CharlieW112/Programmable-Electronic-Load/STM32/TouchGFX_Projects/MyApplication/TouchGFX/assets/images/Screenshot 2024-04-13 051426.png

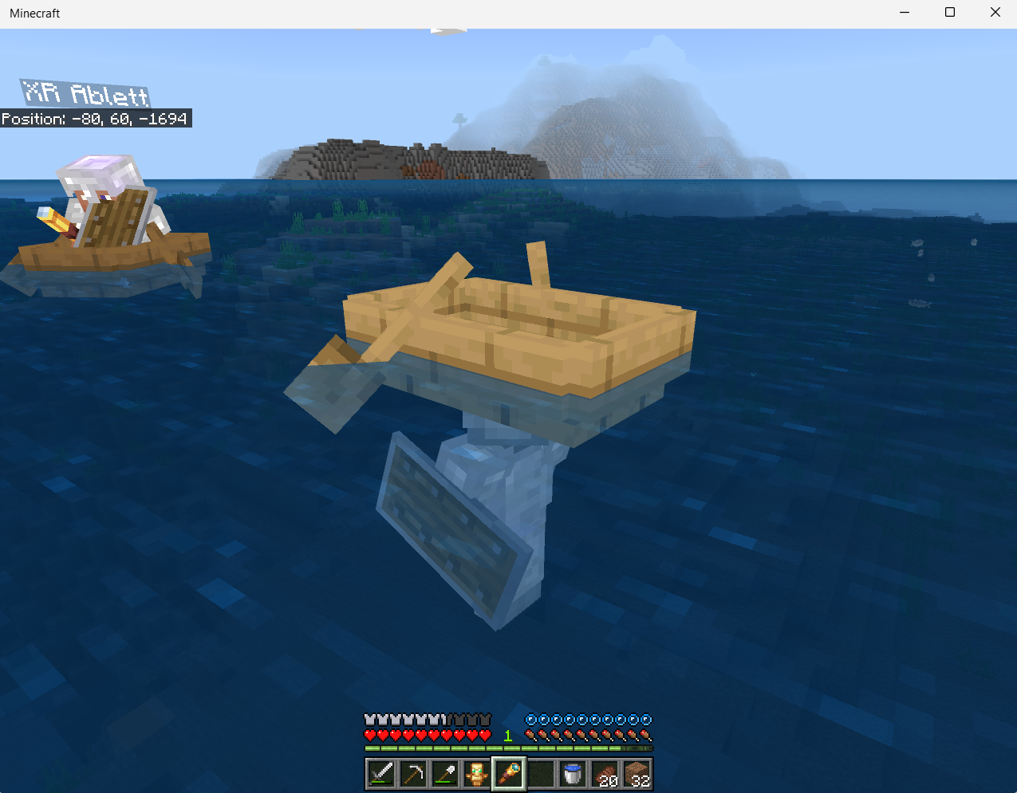
STM32/TouchGFX_Projects/MyApplication/TouchGFX/assets/images/Screenshot 2024-04-13 051426.png
