CharlieW112/Programmable-Electronic-Load/STM32/TouchGFX_Projects/MyApplication/TouchGFX/assets/images/Screenshot 2024-05-27 185339.png

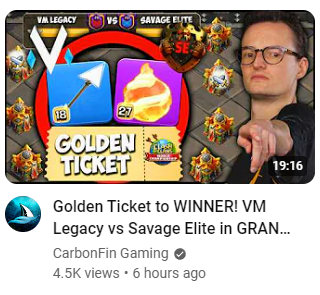
STM32/TouchGFX_Projects/MyApplication/TouchGFX/assets/images/Screenshot 2024-05-27 185339.png
