CharlieW112/Programmable-Electronic-Load/STM32/TouchGFX_Projects/MyApplication/readme.md

# STM32F429I_DISCO_REV_D01 TBS

The default IDE is set to STM32CubeIDE, to change IDE open the STM32F429I_DISCO_REV_D01.ioc with STM32CubeMX and select from the supported IDEs (EWARM from version 8.50.9, MDK-ARM, and STM32CubeIDE). Supports flashing of the STM32F429I_DISCO_DEV_D01 board directly from TouchGFX Designer using GCC and STM32CubeProgrammer. Flashing the board requires STM32CubeProgrammer which can be downloaded from the ST webpage. 

This TBS is configured for 320 x 240 pixels 16bpp screen resolution.  

Performance testing can be done using the GPIO pins designated with the following signals: VSYNC_FREQ  - Pin PE2, RENDER_TIME - Pin PE3, FRAME_RATE  - Pin PE4, MCU_ACTIVE  - Pin PE5
