CharlieW112/Programmable-Electronic-Load/Reports/CAD V1 vs V2 15.10.24.docx

CAD V1 -> V2 Proposed Changes

- Internal height 140mm -> ~160mm
- Additional exhausts on rear panel
- Plate thickness 15mm -> 12mm
- Consistent counterbores
- Tapped holes for cable routing
- Front panel extension
- Rear binding posts

Programmable dc electronic load (s) Charles Warhurst 10/15/24
