CharlieW112/Programmable-Electronic-Load/Reports/Project Overview - Bikar.pdf

## Charles Warhurst

charles.warhurst@students.plymouth.ac.uk

## Programmable DC Electronic Load

## Project Overview

I’m building a programmable DC electronic load, a device used to test power supplies and batteries by simulating real-world electrical loads. The enclosure is more than just a housing—it plays a critical role in heat dissipation, structural integrity, and EMI shielding.

## Why Aluminum?

- Heat Dissipation – The entire enclosure acts as a passive heatsink, helping to manage thermal loads efficiently.
- Structural Strength – A precisely machined aluminum assembly ensures durability and accurate alignment.
- EMI Shielding – The thick aluminum case minimizes electrical interference, improving measurement accuracy.

## What I Need

The enclosure will be built from seven individual aluminum plates, precisely machined to assemble into a rigid, thermally conductive structure. These plates will require cutouts, drilled holes, and accurate tolerances to ensure a secure fit and proper airflow. A simple milled finish is sufficient—no special coatings or treatments required.

## Example Commercial Units

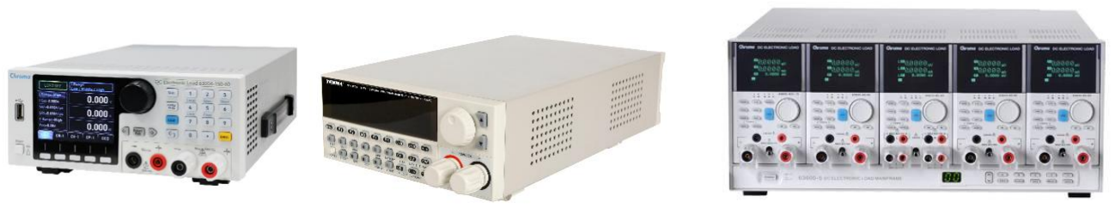
[picture p18: figure]

## My Design:

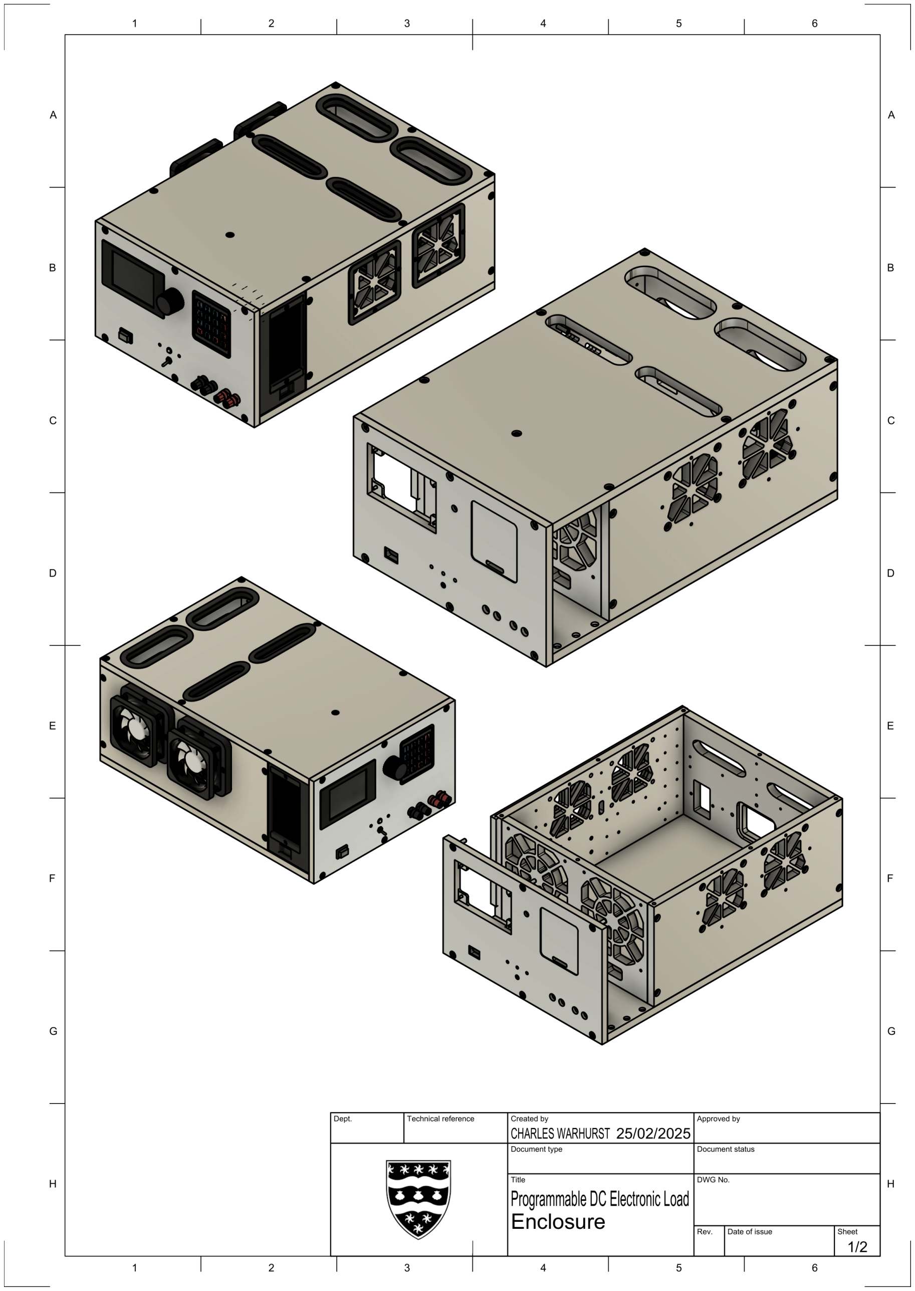
[picture p19: page 2]
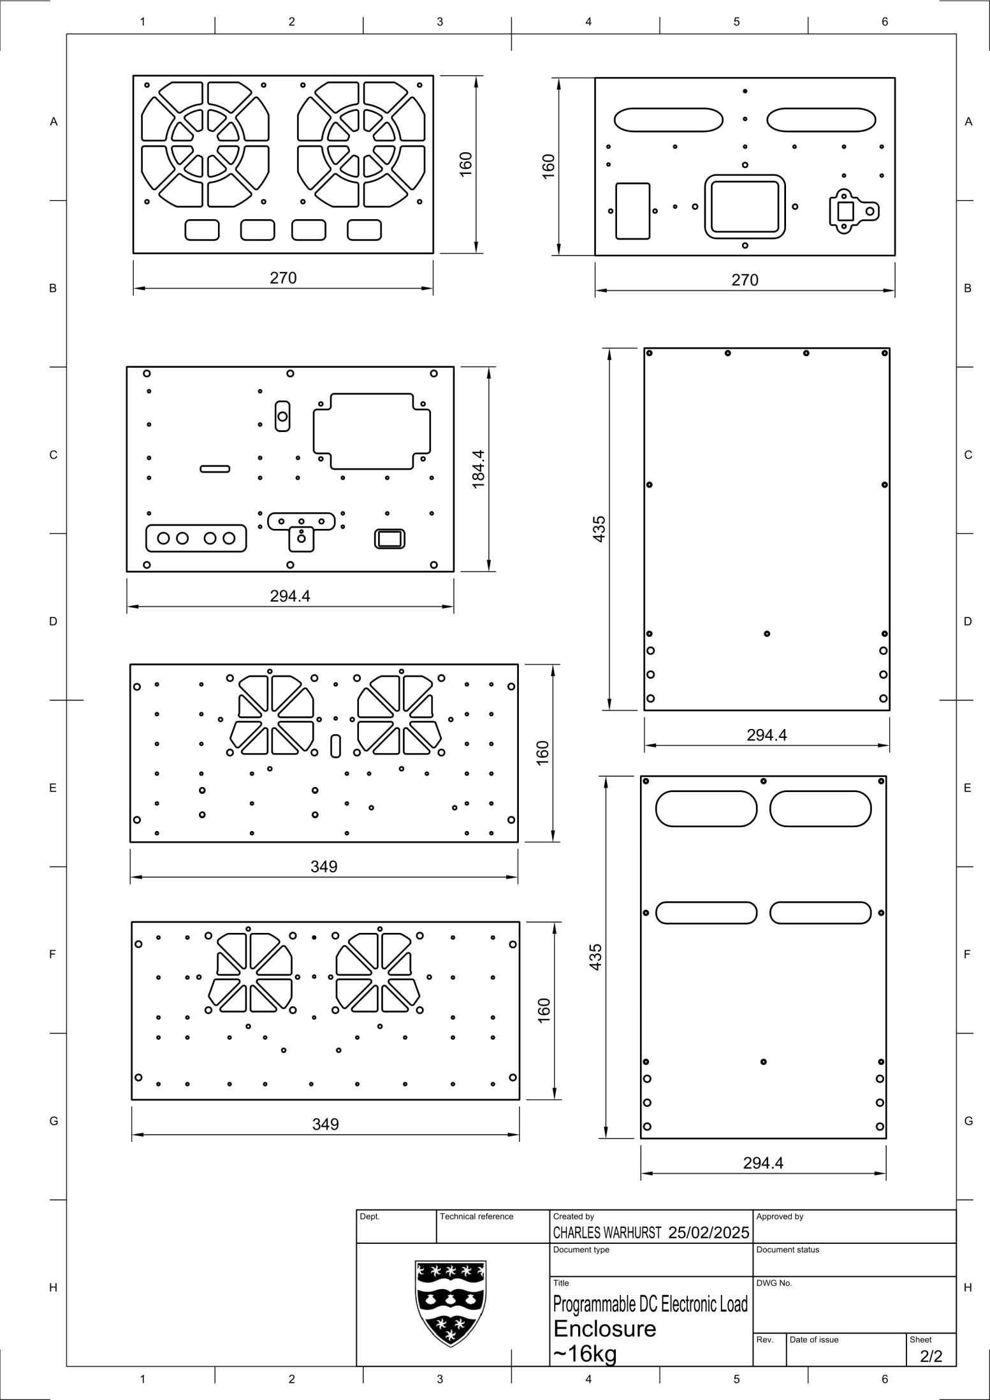
[picture p20: page 3]

PART NAME QTY = 1 | FINAL MACHINED DIMENSIONS (mm) | INITIAL PLATE DIMENSIONS (mm)
WIDTH | HEIGHT | THICKNESS | WIDTH | HEIGHT | THICKNESS
Front Panel | 270 | 160 | 12 | 276 | 166 | 12
Rear Panel | 270 | 160 | 12 | 276 | 166 | 12
External Front Panel | 294.4 | 184.4 | 10 | 300.4 | 190.4 | 12
Bottom Panel | 294.4 | 435 | 12 | 300.4 | 441 | 12
Top Panel | 294.4 | 435 | 12 | 300.4 | 441 | 12
Left Panel | 349 | 160 | 12 | 355 | 166 | 12
Right Panel | 349 | 160 | 12 | 355 | 166 | 12
