CharlieW112/Programmable-Electronic-Load/Reports/Initial Proposal.pdf

Student Name: | Charles Warhurst
Proposal Name: | Programmable DC Electronic Load

Proposal:

I am proposing to design, build, and test a Programmable DC Electronic Load capable of testing power sources up to 100A, 250V, 2kW (whichever comes first). These capabilities are extremely optimistic and due to budget restrictions, a more realistic target would be 20A, 60V, 750W.

# Initial Proposal

19 September 2024 17:51

New Section 1 Page 1
