CharlieW112/Programmable-Electronic-Load/Reports/CAD Progress Update.docx

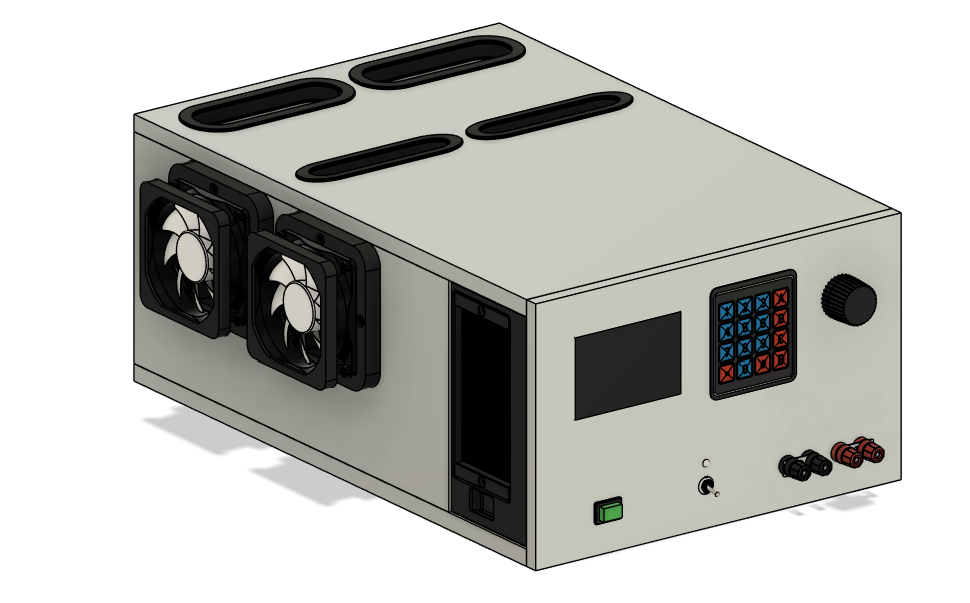
[picture p21: figure]
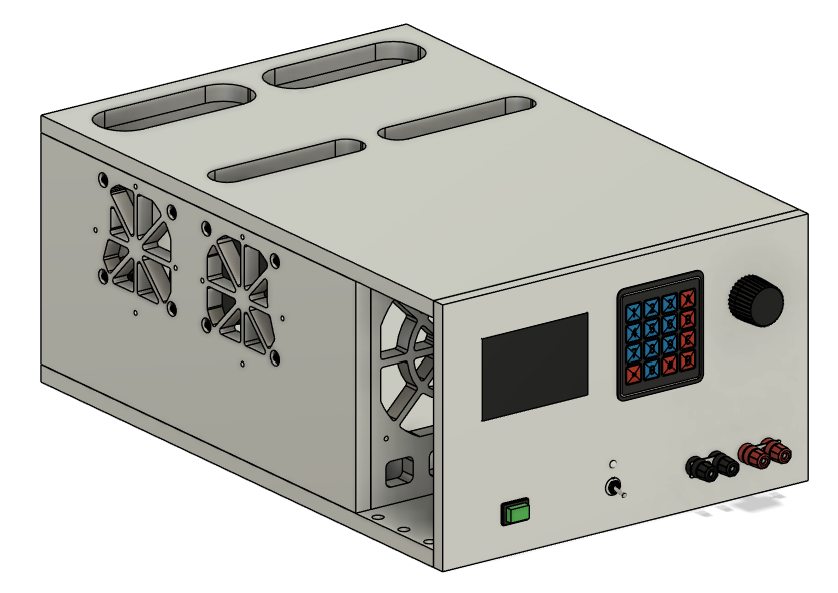
[picture p22: figure]
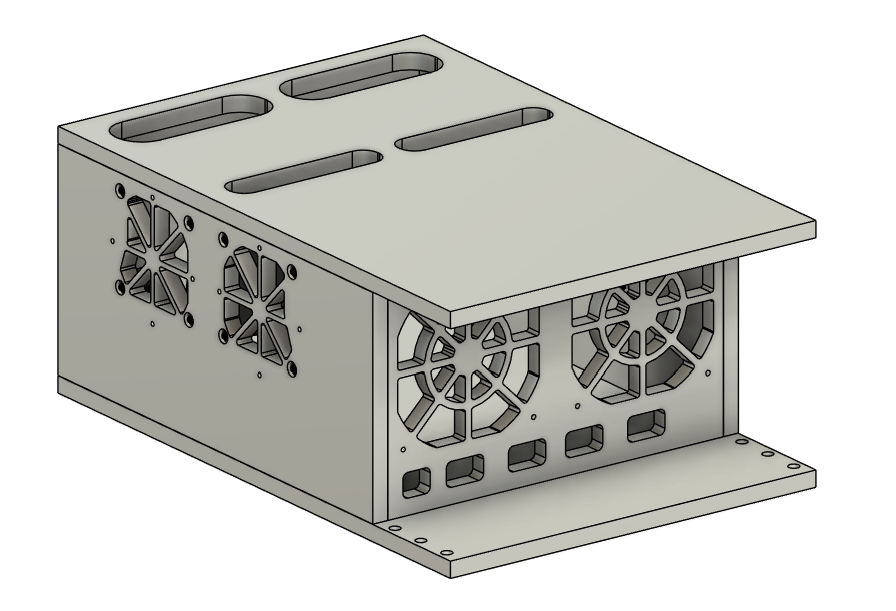
[picture p23: figure]
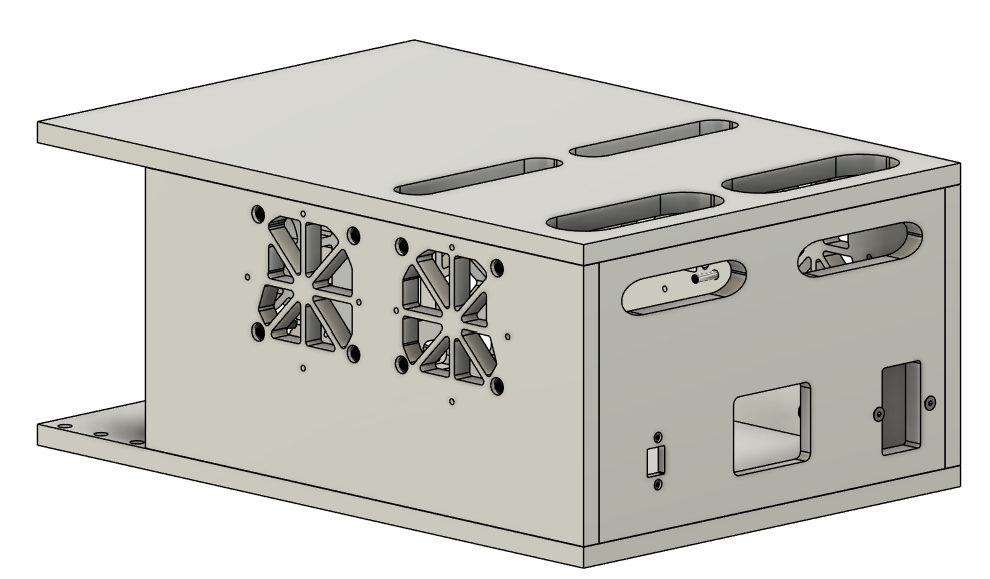
[picture p24: figure]
