CharlieW112/Programmable-Electronic-Load/CAD Files/Downloaded Part Files/3.5 LCD/AliExpress Dimensions.jpg

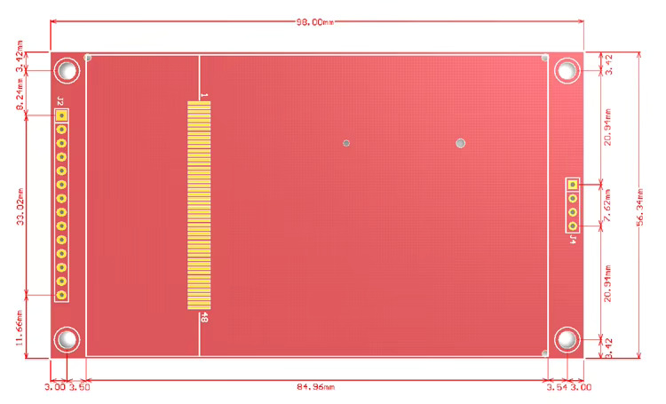
CAD Files/Downloaded Part Files/3.5 LCD/AliExpress Dimensions.jpg
