CharlieW112/Programmable-Electronic-Load/CAD Files/Downloaded Part Files/5mm RGB LED/1.png

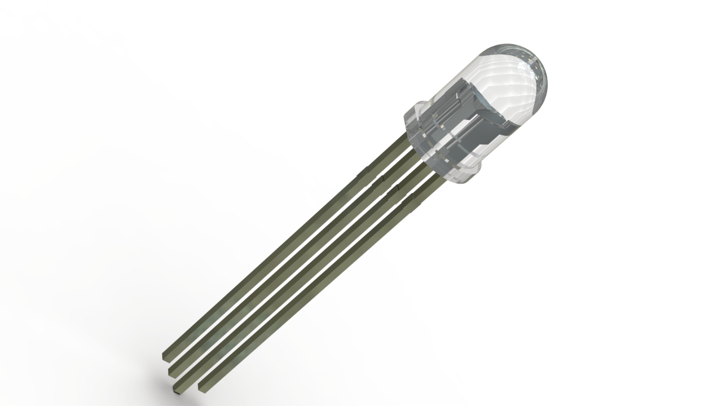
CAD Files/Downloaded Part Files/5mm RGB LED/1.png
