CharlieW112/Programmable-Electronic-Load/CAD Files/Downloaded Part Files/Binding Posts/Low-Current/Rendering1.PNG

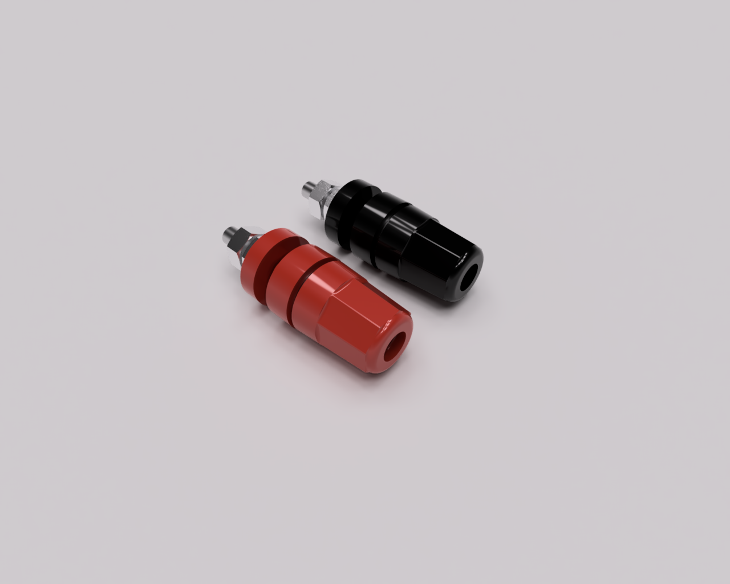
CAD Files/Downloaded Part Files/Binding Posts/Low-Current/Rendering1.PNG
