CharlieW112/Programmable-Electronic-Load/CAD Files/Downloaded Part Files/Binding Posts/Low-Current/Rendering2.png

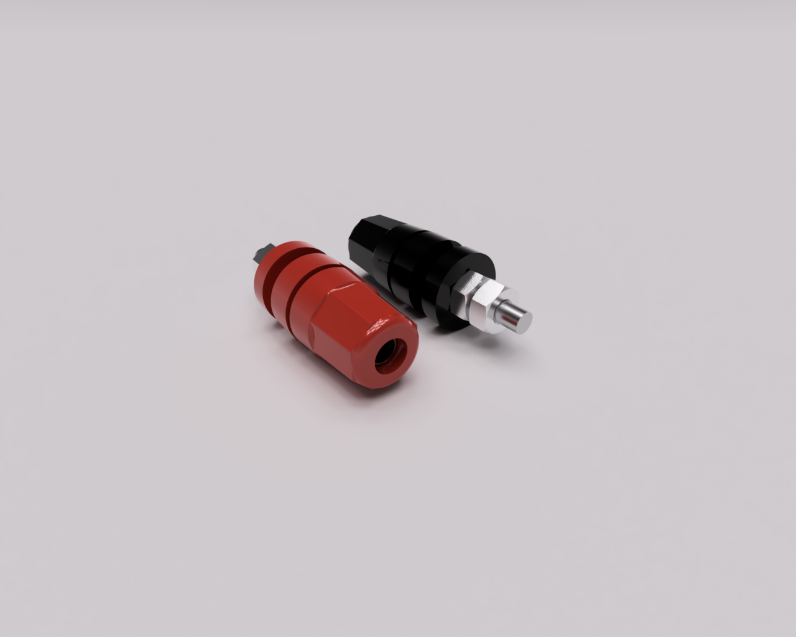
CAD Files/Downloaded Part Files/Binding Posts/Low-Current/Rendering2.png
