CharlieW112/Programmable-Electronic-Load/CAD Files/Downloaded Part Files/Ethernet Port/RJ45 PanelMount.jpg

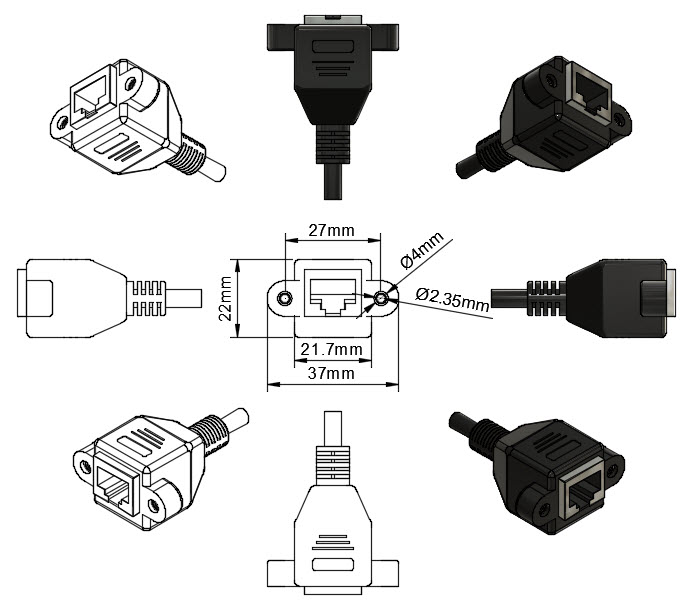
CAD Files/Downloaded Part Files/Ethernet Port/RJ45 PanelMount.jpg
