CharlieW112/Programmable-Electronic-Load/CAD Files/Downloaded Part Files/Fans/80x80x25/80x80x25 fan.307.jpg

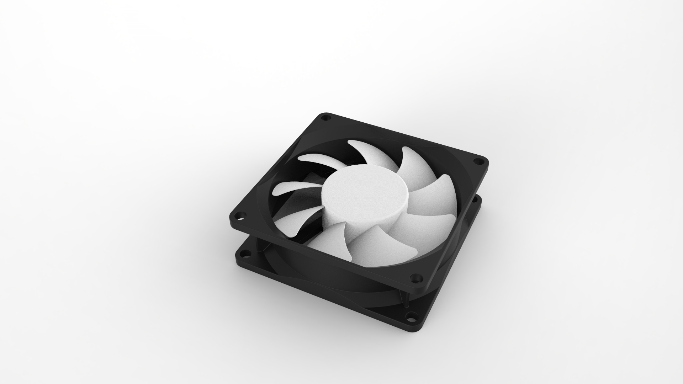
CAD Files/Downloaded Part Files/Fans/80x80x25/80x80x25 fan.307.jpg
