CharlieW112/Programmable-Electronic-Load/CAD Files/Downloaded Part Files/Membrane Keypad/keypad-16keymembrane.jpg

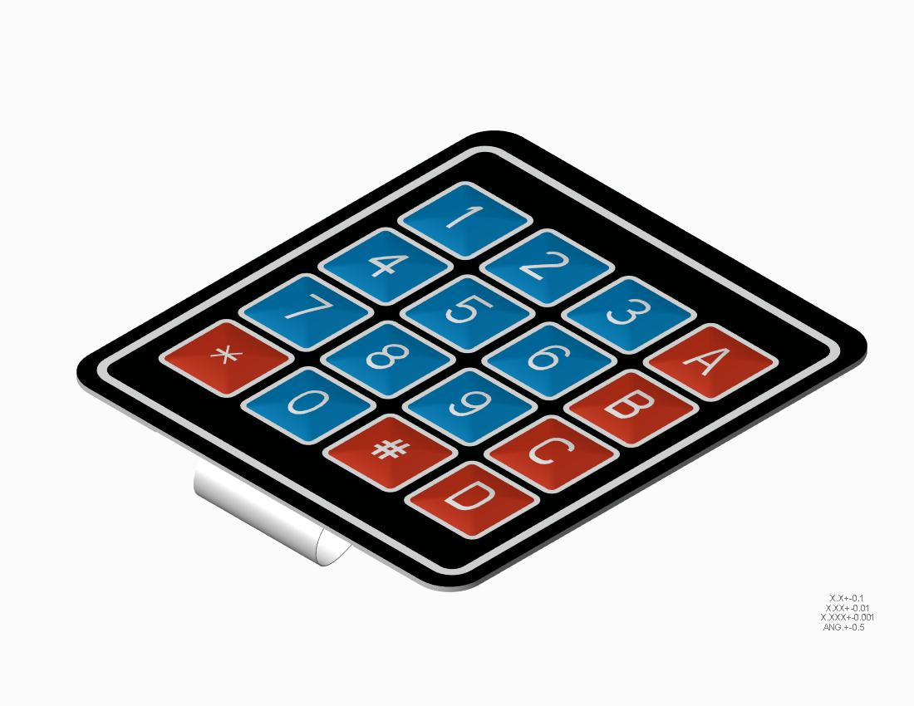
CAD Files/Downloaded Part Files/Membrane Keypad/keypad-16keymembrane.jpg
