CharlieW112/Programmable-Electronic-Load/Misc Photos/Enclosure/IMG_0725.JPEG

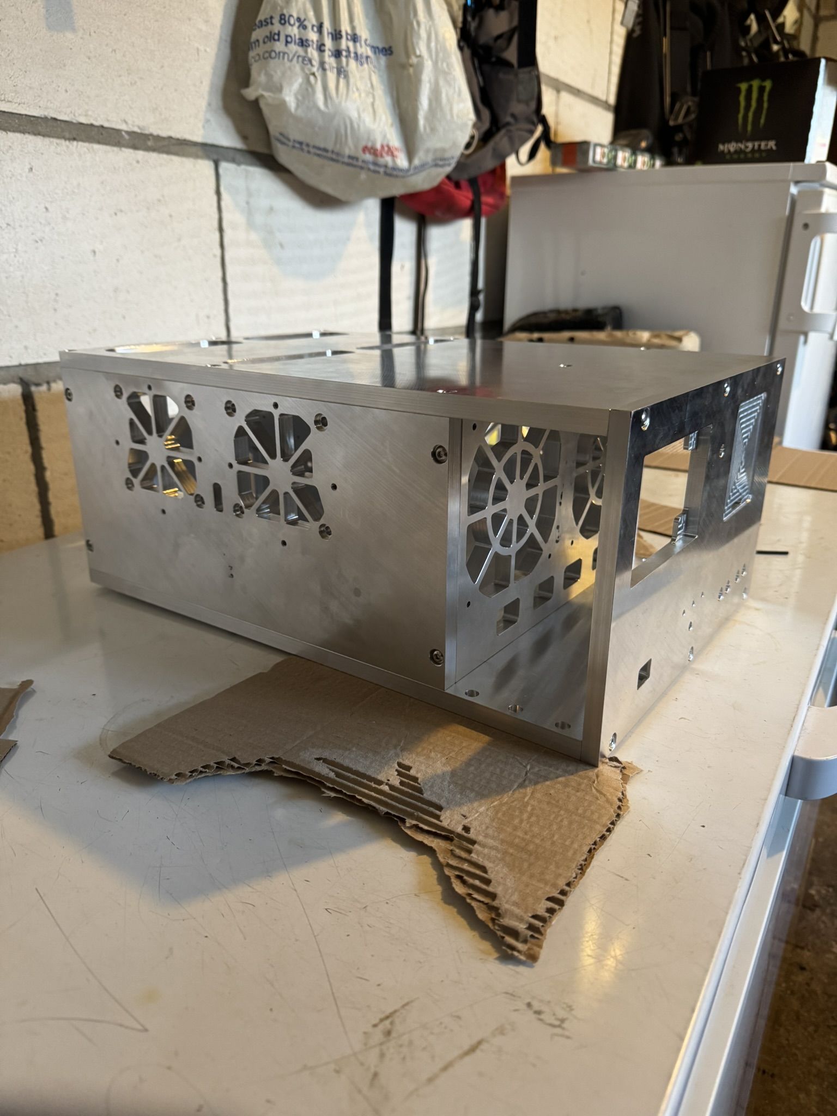
Misc Photos/Enclosure/IMG_0725.JPEG
