CharlieW112/Programmable-Electronic-Load/Misc Photos/Enclosure/IMG_0726.JPEG

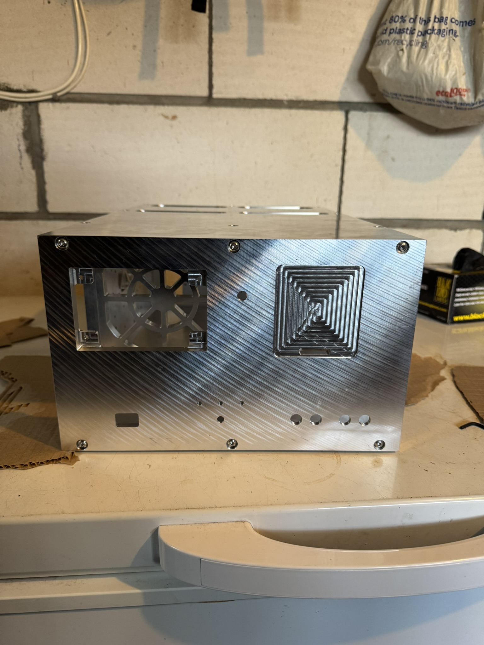
Misc Photos/Enclosure/IMG_0726.JPEG
