CharlieW112/Programmable-Electronic-Load/Misc Photos/Enclosure/IMG_0727.JPEG

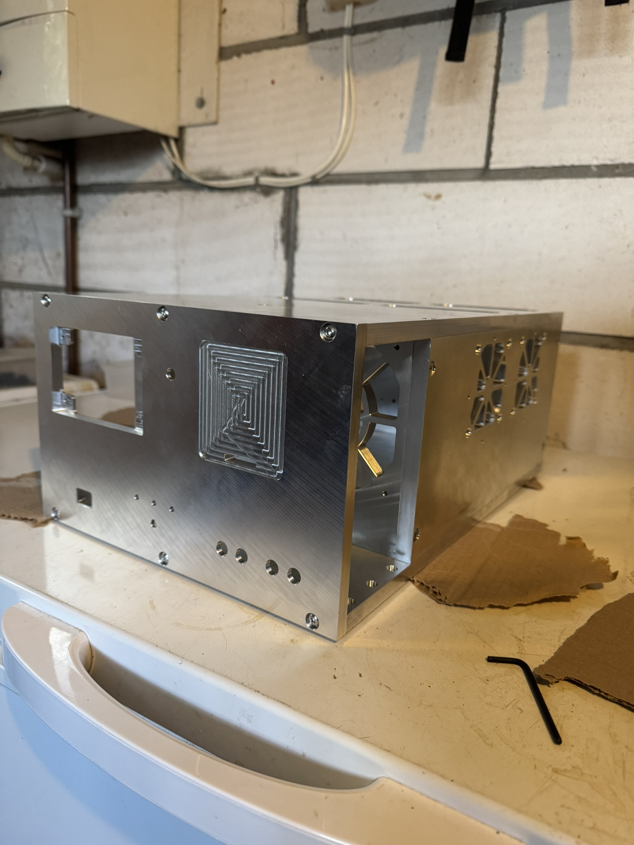
Misc Photos/Enclosure/IMG_0727.JPEG
