CharlieW112/Programmable-Electronic-Load/Misc Photos/Enclosure/IMG_0728.JPEG

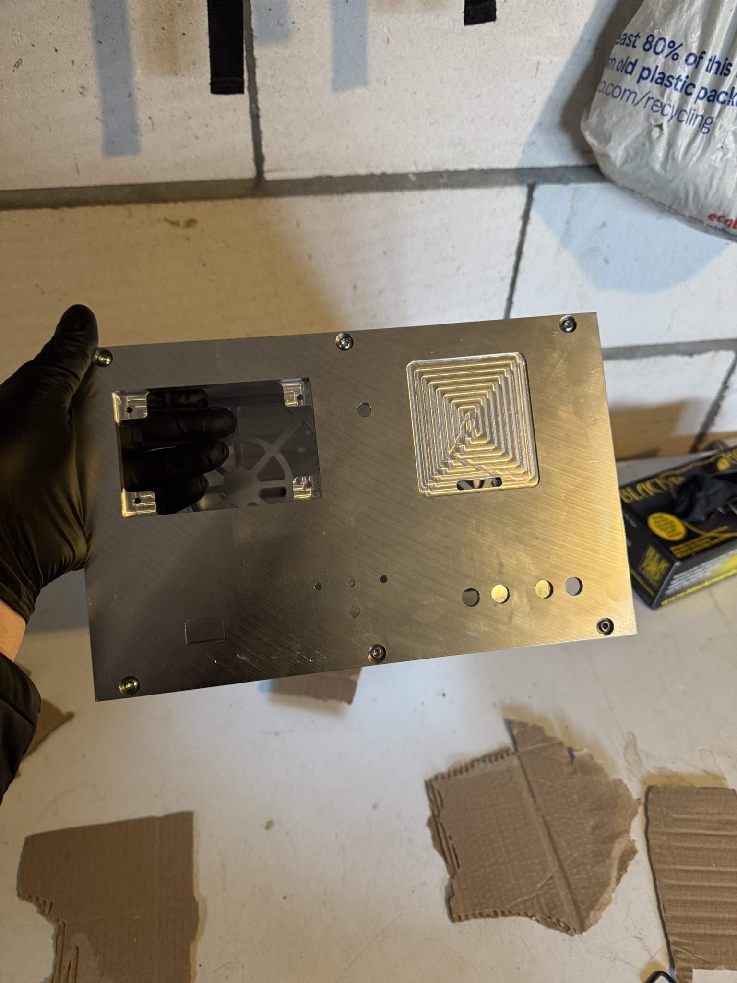
Misc Photos/Enclosure/IMG_0728.JPEG
