CharlieW112/Programmable-Electronic-Load/Misc Photos/Enclosure/IMG_0729.JPEG

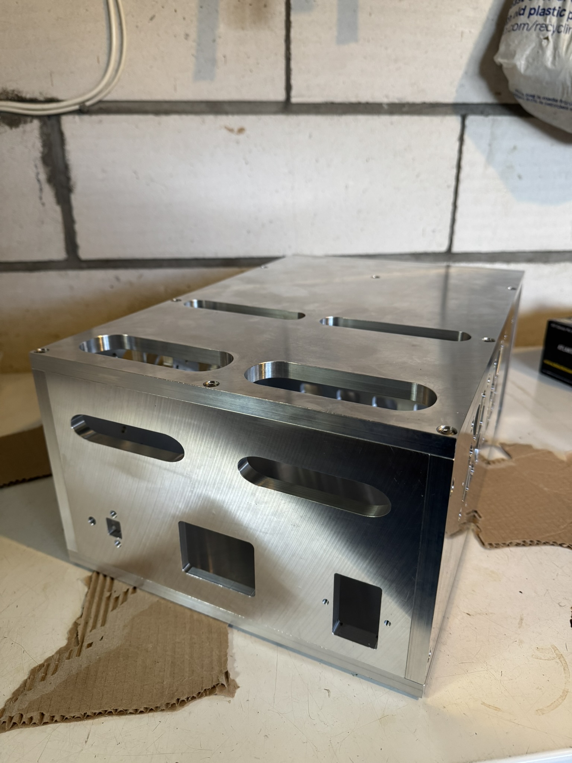
Misc Photos/Enclosure/IMG_0729.JPEG
