CharlieW112/Programmable-Electronic-Load/Misc Photos/Enclosure/IMG_0730.JPEG

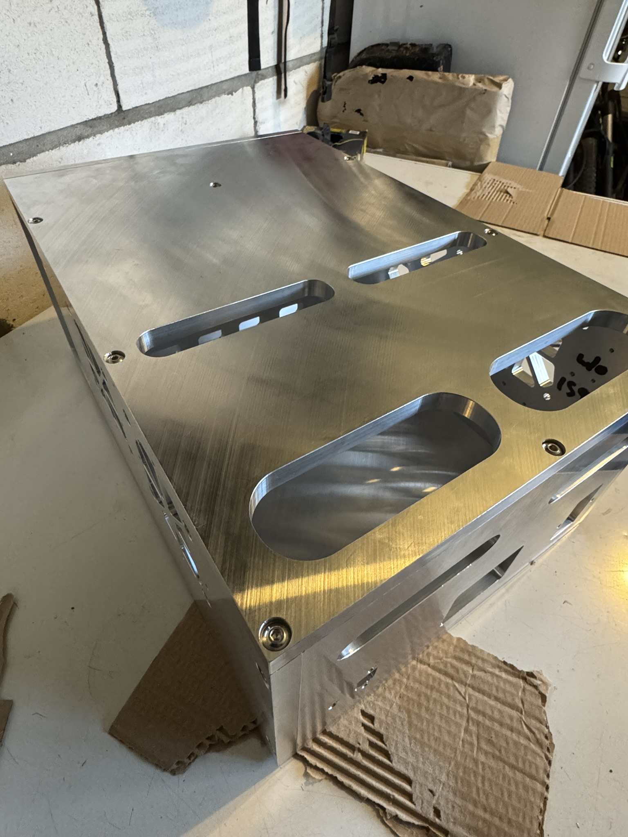
Misc Photos/Enclosure/IMG_0730.JPEG
