CharlieW112/Programmable-Electronic-Load/Misc Photos/Enclosure/IMG_0731.JPEG

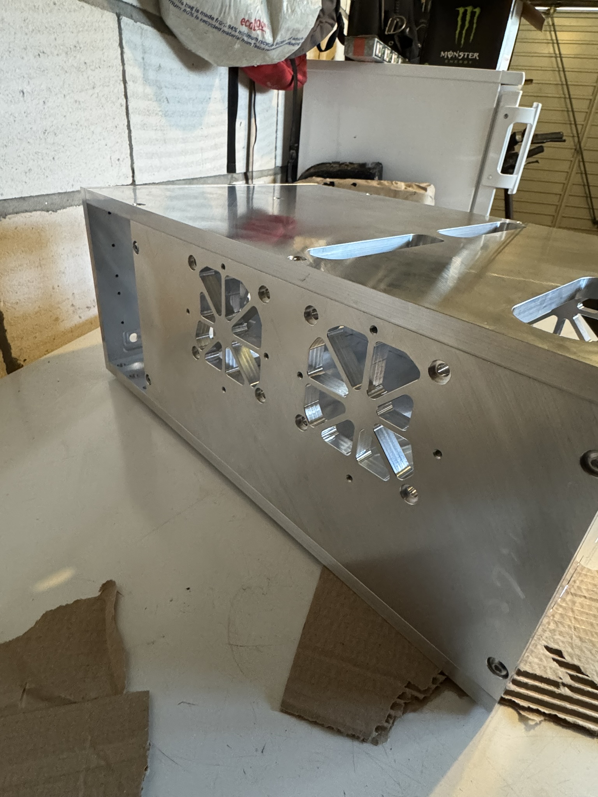
Misc Photos/Enclosure/IMG_0731.JPEG
