CharlieW112/Programmable-Electronic-Load/Misc Photos/Enclosure/IMG_0732.JPEG

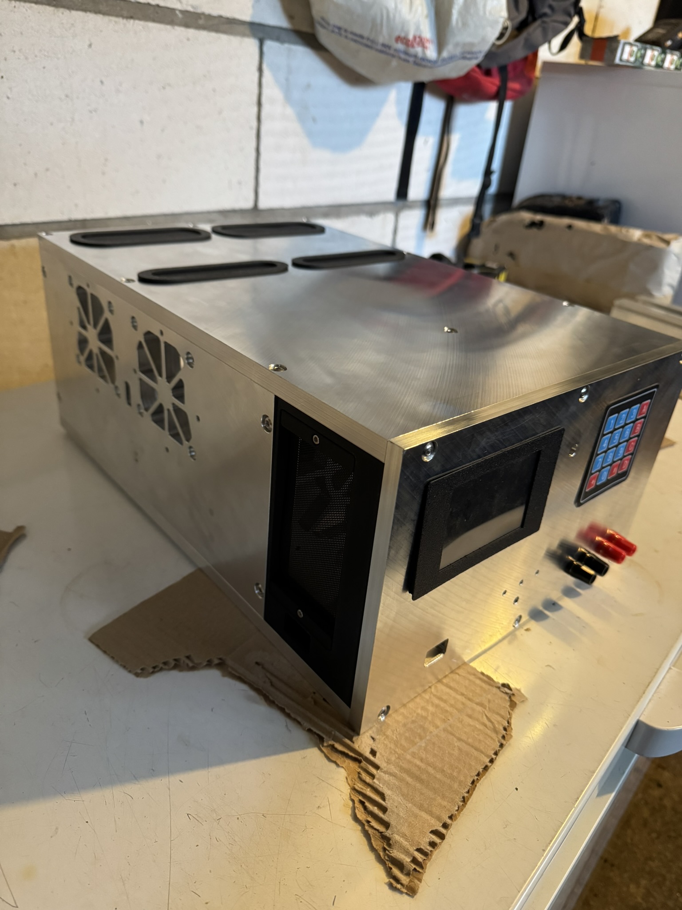
Misc Photos/Enclosure/IMG_0732.JPEG
