CharlieW112/Programmable-Electronic-Load/Misc Photos/Enclosure/IMG_0733.JPEG

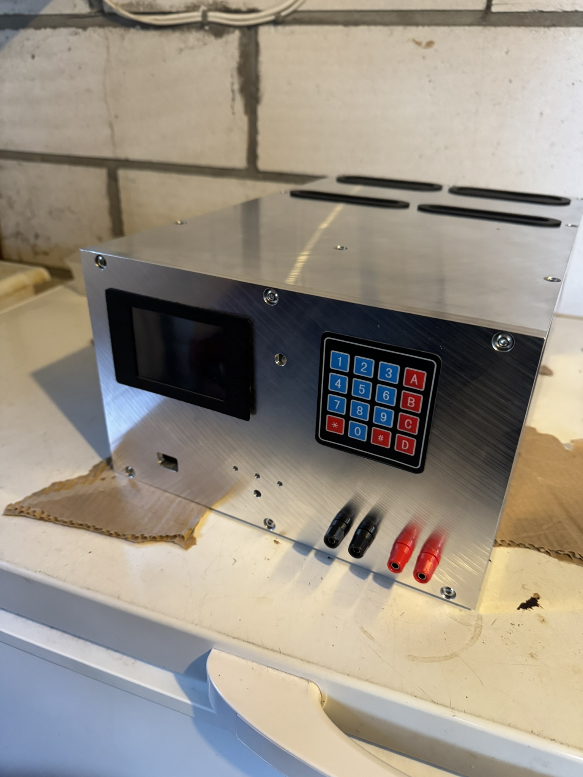
Misc Photos/Enclosure/IMG_0733.JPEG
