CharlieW112/Programmable-Electronic-Load/Misc Photos/Enclosure/IMG_0735.JPEG

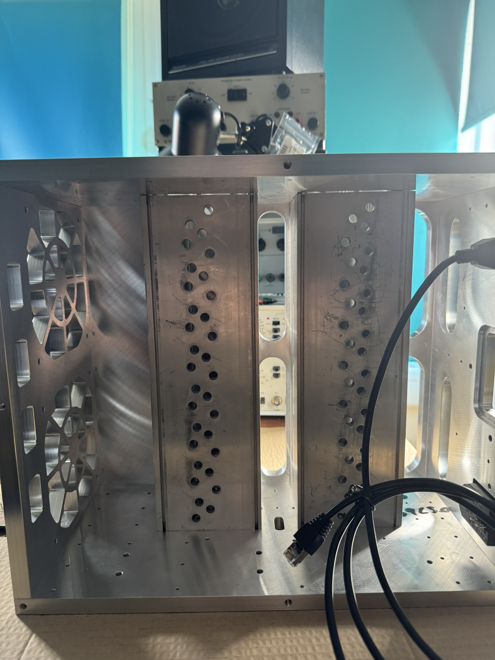
Misc Photos/Enclosure/IMG_0735.JPEG
