CharlieW112/Programmable-Electronic-Load/Misc Photos/Enclosure/IMG_0736.JPEG

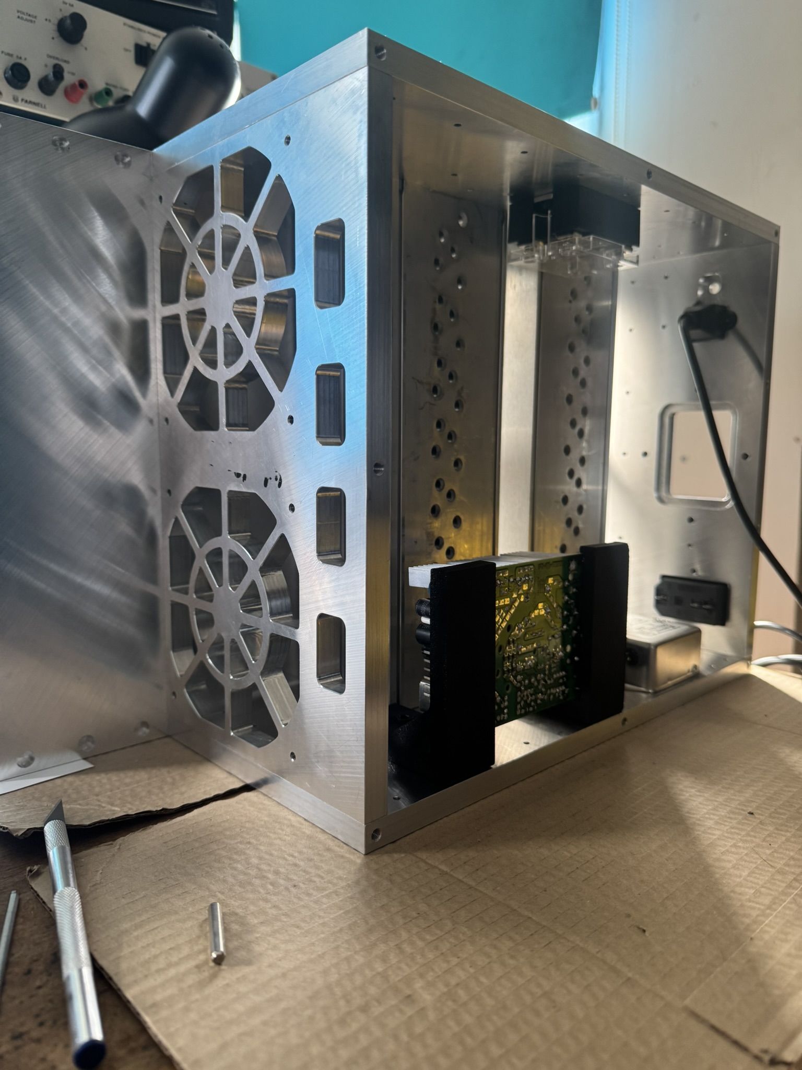
Misc Photos/Enclosure/IMG_0736.JPEG
