CharlieW112/Programmable-Electronic-Load/Misc Photos/Enclosure/IMG_0737.JPEG

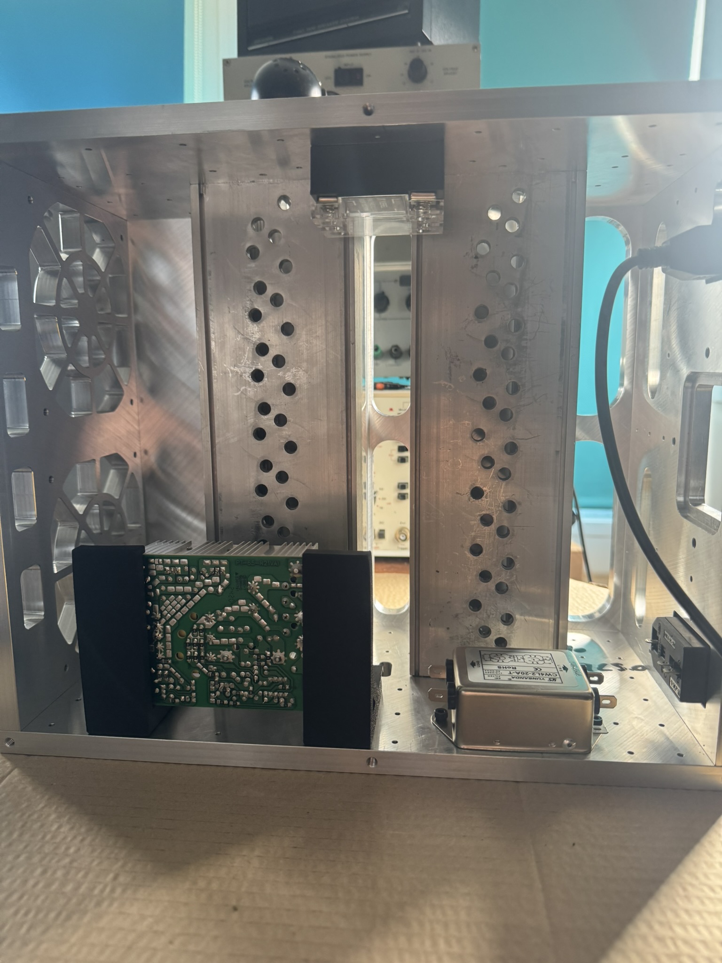
Misc Photos/Enclosure/IMG_0737.JPEG
