CharlieW112/Programmable-Electronic-Load/Misc Photos/Enclosure/IMG_0738.JPEG

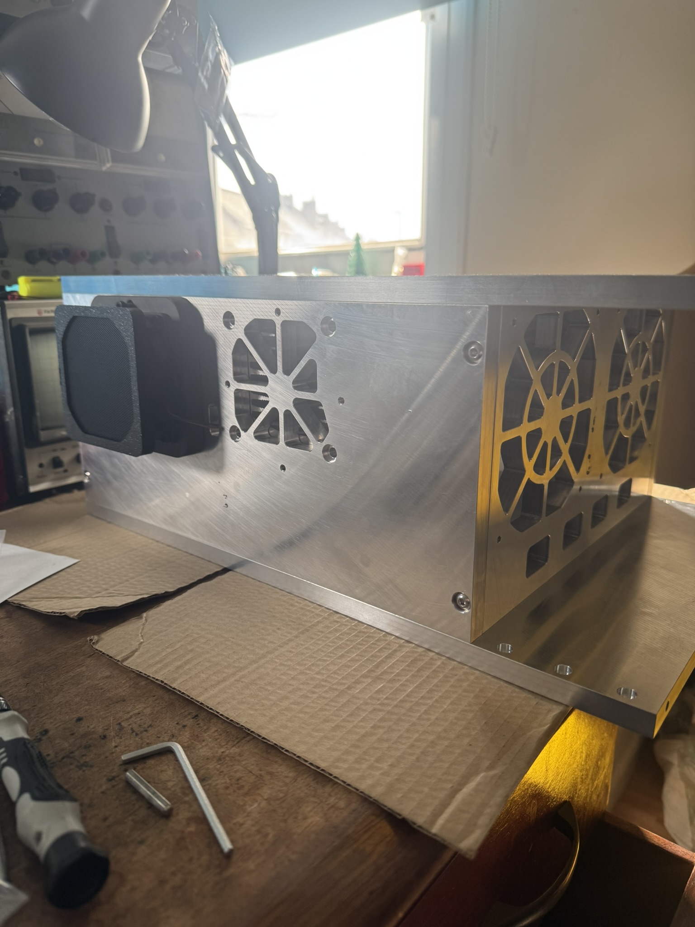
Misc Photos/Enclosure/IMG_0738.JPEG
