CharlieW112/Programmable-Electronic-Load/Misc Photos/Enclosure/IMG_0739.JPEG

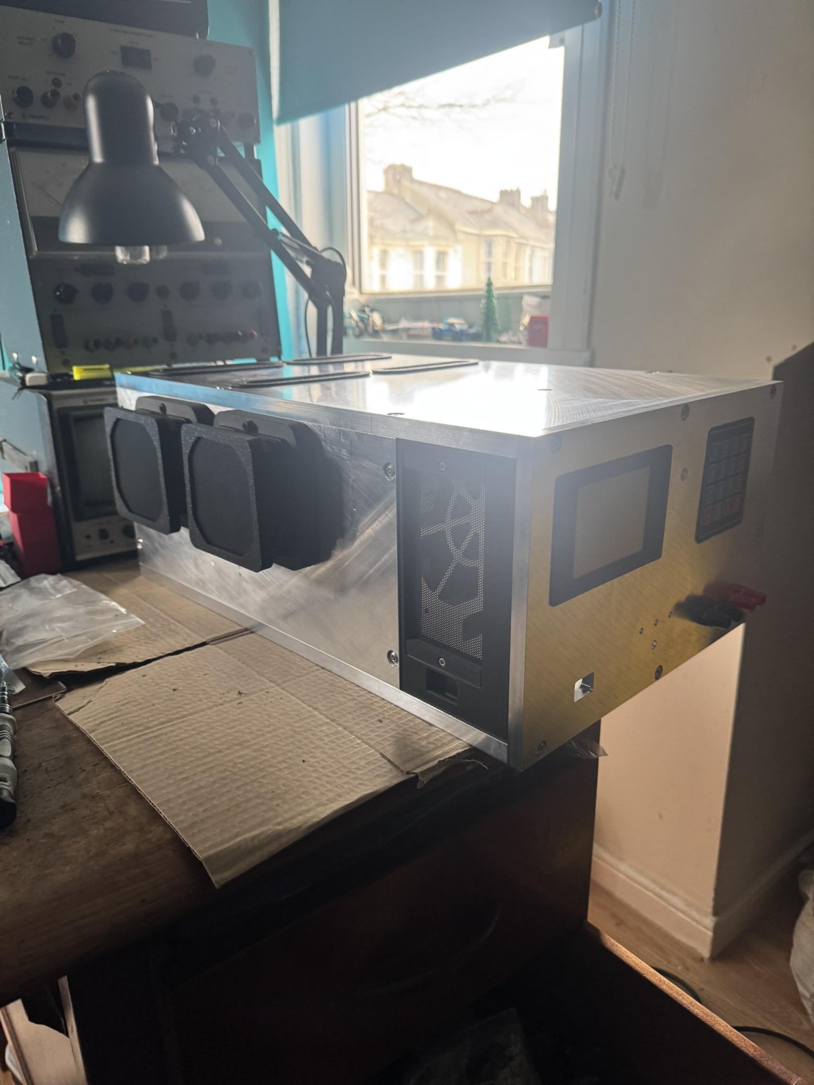
Misc Photos/Enclosure/IMG_0739.JPEG
