CharlieW112/Programmable-Electronic-Load/Misc Photos/Enclosure/IMG_0740.JPEG

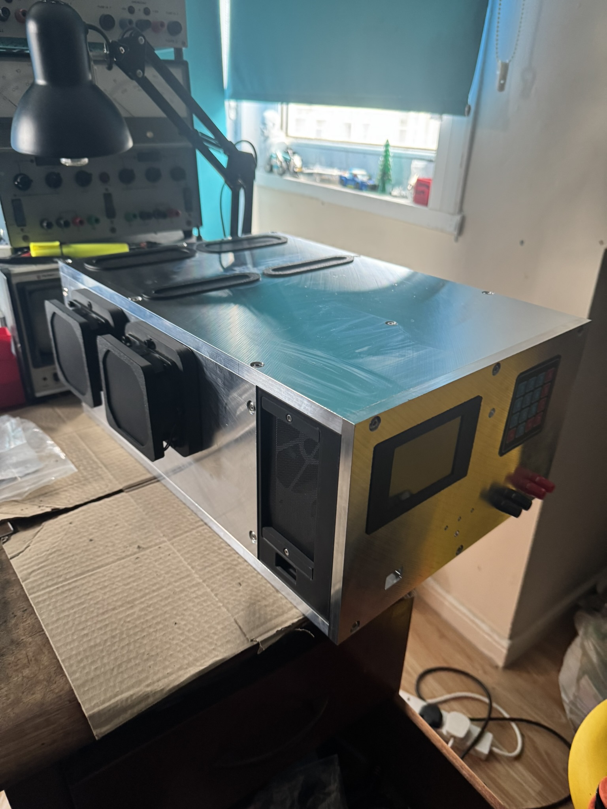
Misc Photos/Enclosure/IMG_0740.JPEG
