CharlieW112/Programmable-Electronic-Load/Misc Photos/Enclosure/IMG_0741.JPEG

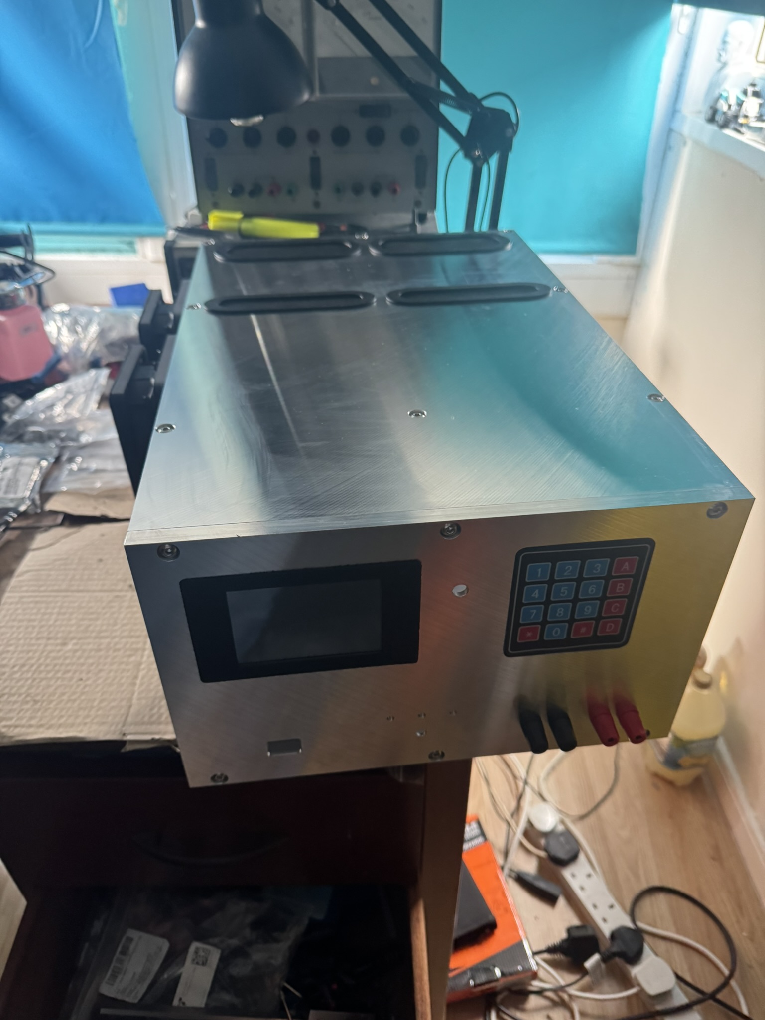
Misc Photos/Enclosure/IMG_0741.JPEG
