CharlieW112/Programmable-Electronic-Load/Misc Photos/Front Panel LEDs.png

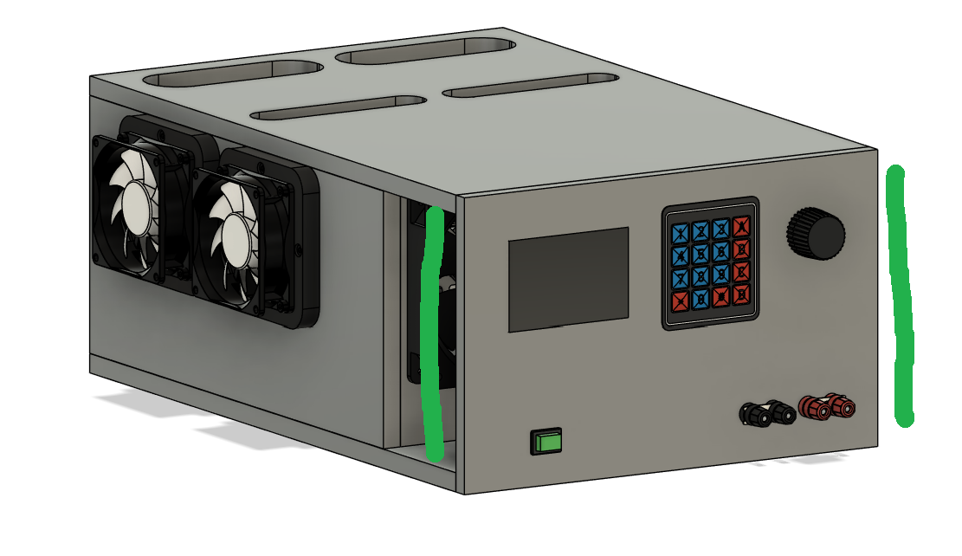
Misc Photos/Front Panel LEDs.png
