CharlieW112/Programmable-Electronic-Load/Misc Photos/Proteus - Base Driver V2.png

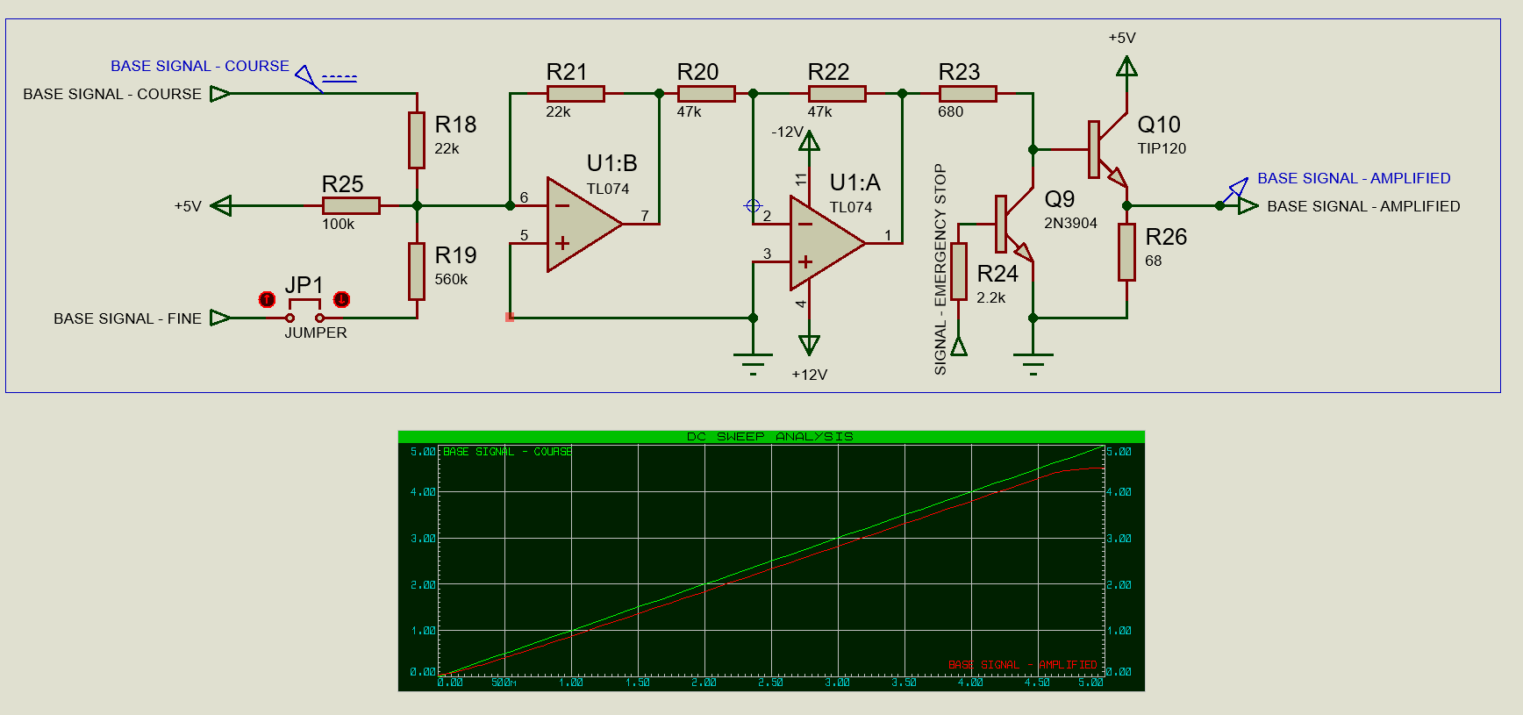
Misc Photos/Proteus - Base Driver V2.png
