CharlieW112/Programmable-Electronic-Load/Accounting/Sample Tracker.xlsx

Company | Email | Date | Product | Purchase Price | Response | Product Acquired | Company | Reason | Acknowledgement
MeanWell | info@meanwell.eu | 2024-09-30 | PT-65B | £15.00 | n | n | Bikar Metals | Aluminium plate for enclosure | Engraving
Riedon | sales@riedon.com | 2024-09-30 | SSA2-250 | £70.00 | y | y | AJM Engineering | Machining for enclosure | Engraving
STMicroelectronics | uk.contact@st.com | 2024-09-30 | STM32F767 | £13.00 | n | n | Riedon | SSA2-250 Smart Current Sensor | Engraving
Newhaven Display | nhsales@newhavendisplay.com | 2024-09-30 | 3.5" LCD TFT | £15-£100 | n | n
Gigavac | info@gigavac.com | 2024-10-05 | GX11 150+ Amp | £50.00 | n | n
Seek Thermal | https://www.flir.co.uk/about/general-inquiries/ | 2024-10-17 | Thermal Imaging Camera | £200-£1000 | a | n
Hakko | sales@hakko.co.uk | 2024-10-29 | Desoldering Gun | £350.00 | n | n
Pomona (Fluke) | technicalsupport@pomonatest.com | 2024-10-29 | Shorting Bar | £10-£50 | a | n
Molex | mo.boolaky@molex.com | 2024-10-30 | PSU Connectors | £15.00 | a | n
