CharlieW112/Programmable-Electronic-Load/Accounting/Price Tracker.xlsx

Total Price (£) | Name | Quantity | Vendor | Date | Purchased?
17.44 | Heavy Duty Car Starter Relay DC 12V 100A 4Pin Normally Open for Control Battery ON OFF RL/180 | 2 | Amazon.co.uk | 2024-09-16 | y
2.9 | TS5A3159ADBVR - SPDT Analog Multiplexer | 5 | Digikey.co.uk
5.32 | OPA197IDR - Precision Op-Amp | 4 | Digikey.co.uk
19.2 | HO 100-S - 100A Hall Effect Current Sensor | 1 | Digikey.co.uk
 | MEAN WELL Switching Power Supply, PT-65B, 12V dc, 2.5A, 63.5W, Triple Output, 264V ac Input Voltage | 1 | uk.rs-online.com
 | Sunon EE Series Axial Fan, 12 V dc, DC Operation, 158m³/h, 3.4W, 279mA Max, 120 x 120 x 25mm | 2 | uk.rs-online.com
 | Axial Fan, 12 V dc, dc Operation, 70m³/h, 138mA Max, 80 x 80 x 25mm | 4 | uk.rs-online.com
 | RS PRO 83dB Through Hole Continuous Internal Piezo Buzzer, 28.6 (Dia.) x 7.5mm, 3V dc Min, 28V dc Max | 5 | uk.rs-online.com
 | STMicroelectronics STM32F767VIT6, 32bit ARM Cortex M7 Microcontroller, STM32F7, 216MHz, 2.048 MB Flash, 100-Pin LQFP | 1 | uk.rs-online.com
