CharlieW112/Programmable-Electronic-Load/CAD Files/Downloaded Part Files/5mm RGB LED/Led RGB 5mm.STEP

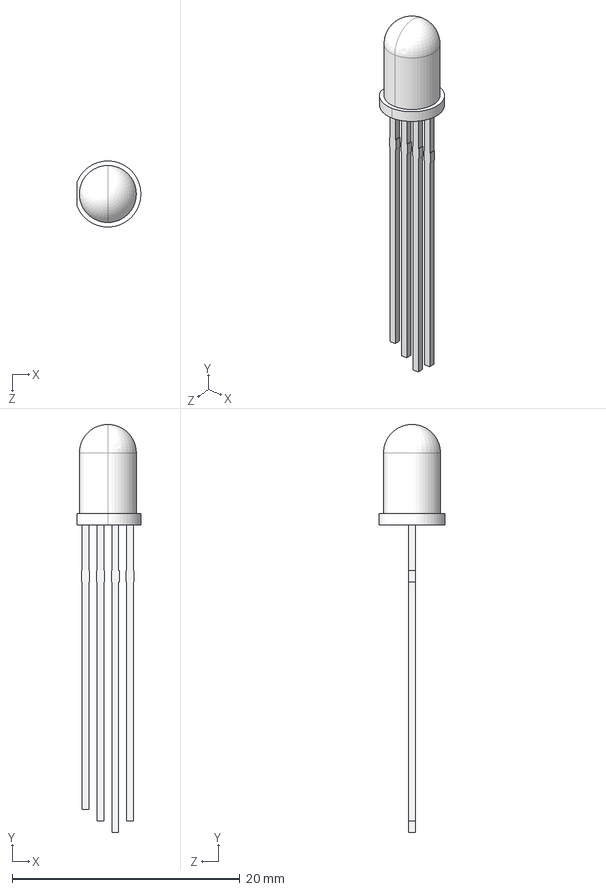
[picture p55: CAD file, 2024-10-31]
CAD Files/Downloaded Part Files/5mm RGB LED/Led RGB 5mm.STEP
5.60 x 35.8 x 5.80 mm
Lente^Led RGB 5mm
Terminais^Led RGB 5mm
