CharlieW112/Programmable-Electronic-Load/CAD Files/Downloaded Part Files/Binding Posts/Low-Current/Banana jack (4mm female socket).step

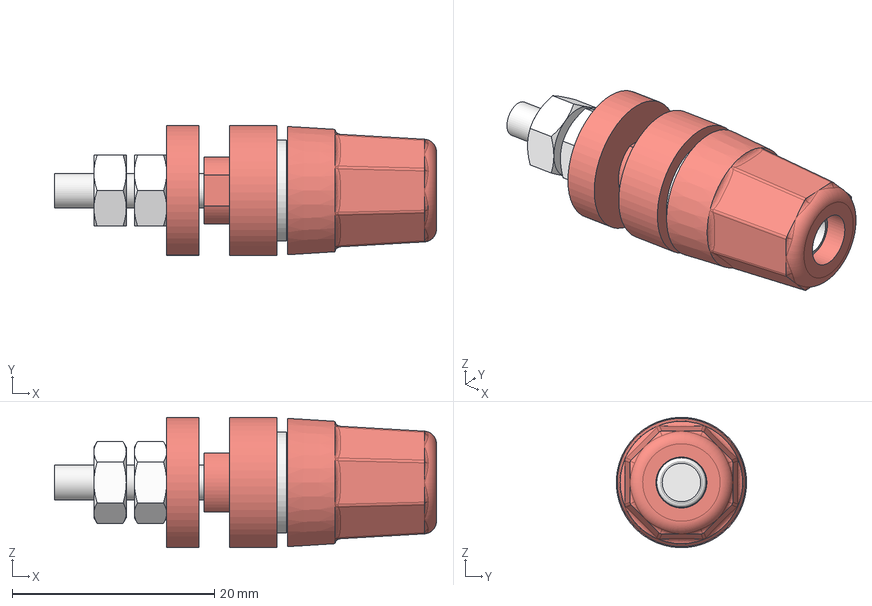
[picture p56: CAD file, 2024-10-31]
CAD Files/Downloaded Part Files/Binding Posts/Low-Current/Banana jack (4mm female socket).step
37.8 x 12.9 x 12.9 mm
Metal rod
Knob part
Front fixing part
Back washer
M4 nut x 2
