CharlieW112/Programmable-Electronic-Load/CAD Files/Downloaded Part Files/Fans/80x80x25/80x80x25 fan frame.SLDPRT

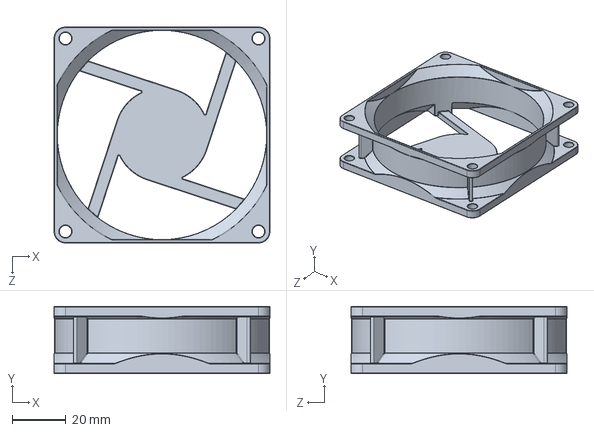
[picture p58: CAD file, 2024-10-12]
CAD Files/Downloaded Part Files/Fans/80x80x25/80x80x25 fan frame.SLDPRT
80.0 x 25.0 x 80.0 mm
