CharlieW112/Programmable-Electronic-Load/CAD Files/Downloaded Part Files/Fans/Fan Adapter.stl

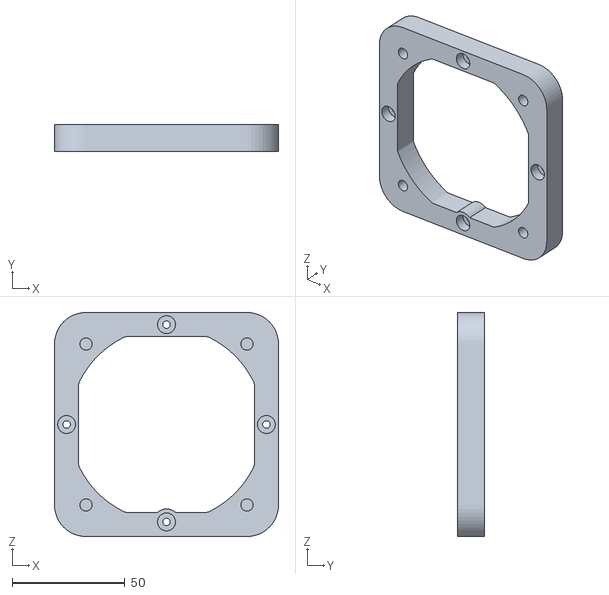
[picture p59: CAD file, 2024-10-12]
CAD Files/Downloaded Part Files/Fans/Fan Adapter.stl
99.5 x 12.0 x 99.5
