CharlieW112/Programmable-Electronic-Load/CAD Files/Downloaded Part Files/Heatsinks/Outline1.dxf

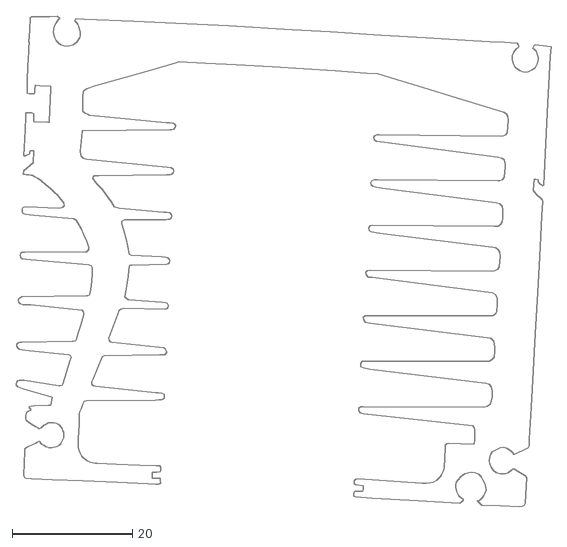
[picture p60: CAD file, 2024-10-12]
CAD Files/Downloaded Part Files/Heatsinks/Outline1.dxf
89.0 x 81.5
