CharlieW112/Programmable-Electronic-Load/CAD Files/Downloaded Part Files/Mains Switch Indicating/PB1973GxxxxILEFx.stp

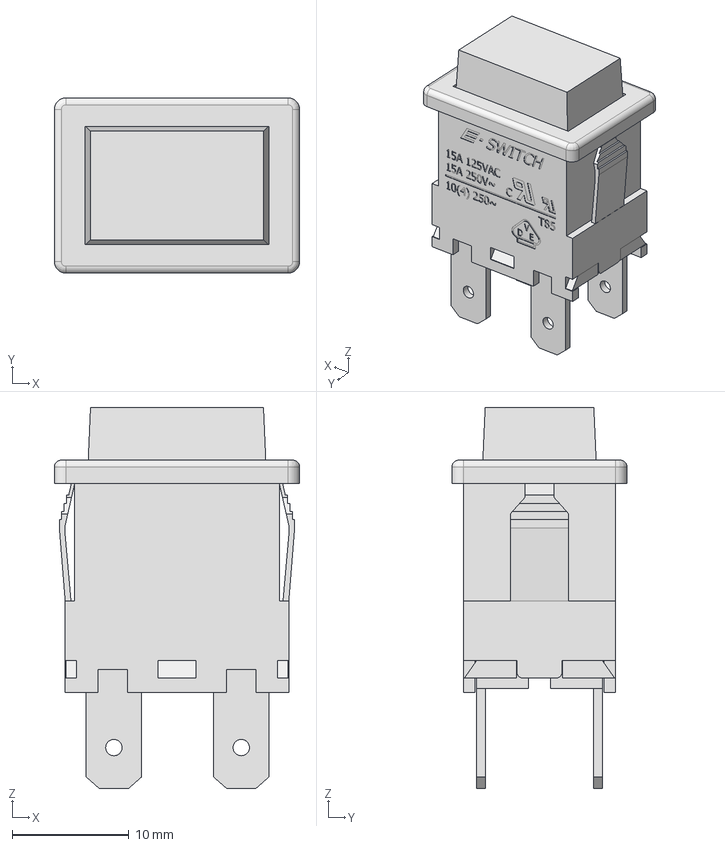
[picture p61: CAD file, 2024-10-31]
CAD Files/Downloaded Part Files/Mains Switch Indicating/PB1973GxxxxILEFx.stp
21.0 x 15.0 x 32.6 mm
