CharlieW112/Programmable-Electronic-Load/CAD Files/Downloaded Part Files/Power Line Filter/CW4EL2-10A-T EMI v2.step

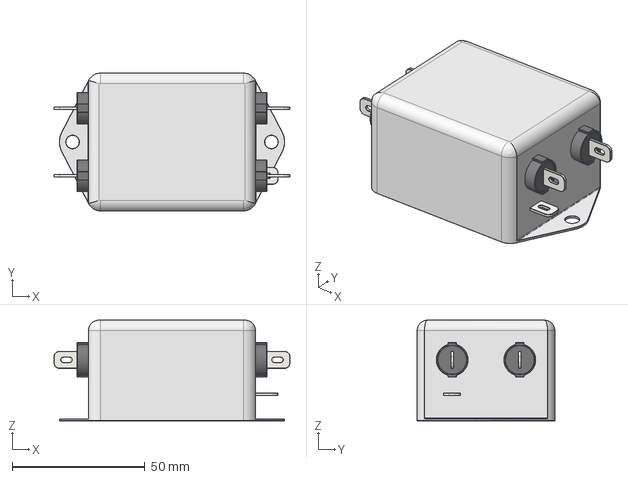
[picture p62: CAD file, 2024-10-31]
CAD Files/Downloaded Part Files/Power Line Filter/CW4EL2-10A-T EMI v2.step
89.0 x 52.0 x 38.0 mm
