CharlieW112/Programmable-Electronic-Load/CAD Files/Downloaded Part Files/Power Socket/IEC320-C14.STEP

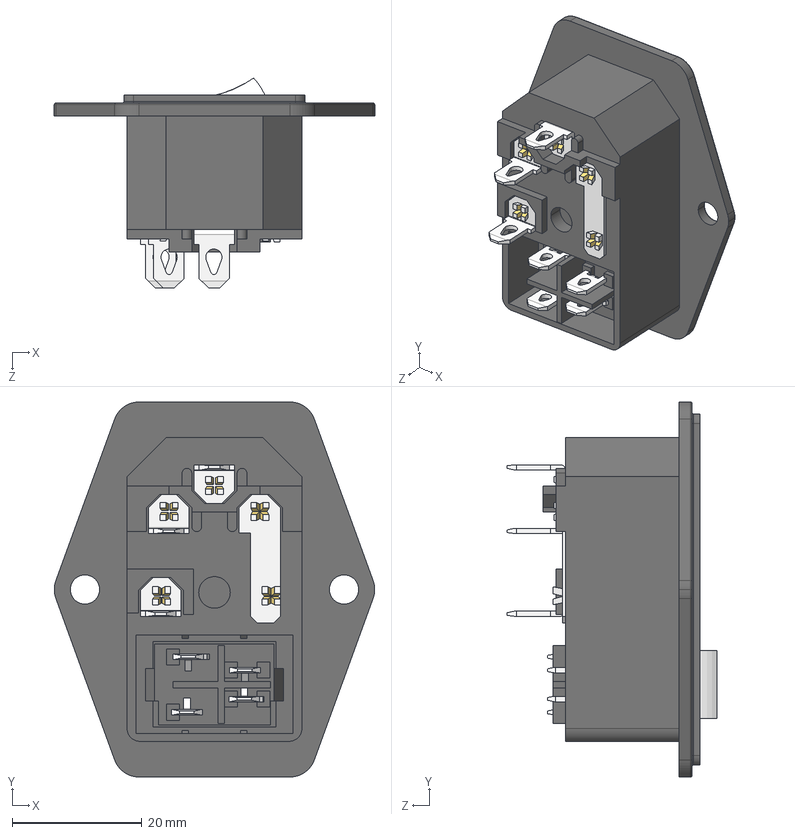
[picture p63: CAD file, 2024-10-13]
CAD Files/Downloaded Part Files/Power Socket/IEC320-C14.STEP
49.5 x 57.9 x 32.4 mm
ilpm_case
fuse_clip_set
blade_15
blade_12 x 2
fuse-holder
fuse
switch_base
rocker
sm_tab_type1a
sm_tab_type1b
sm_tab_type2a
sm_tab_type2b
spot x 2
stamped_cond
correct_big_tab x 3
