CharlieW112/Programmable-Electronic-Load/CAD Files/Downloaded Part Files/Rotary Encoder/pec11r-4x25f-sxxxx.stp

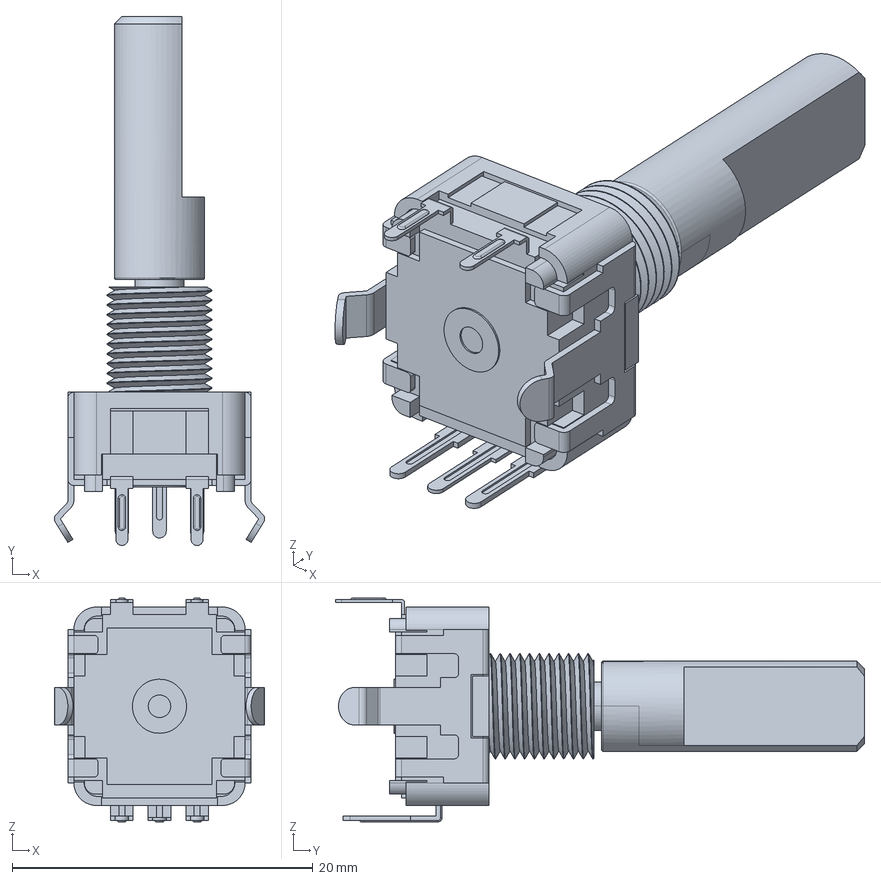
[picture p64: CAD file, 2024-10-31]
CAD Files/Downloaded Part Files/Rotary Encoder/pec11r-4x25f-sxxxx.stp
14.0 x 35.2 x 14.9 mm
