CharlieW112/Programmable-Electronic-Load/CAD Files/Downloaded Part Files/Transistors/TO3.STEP

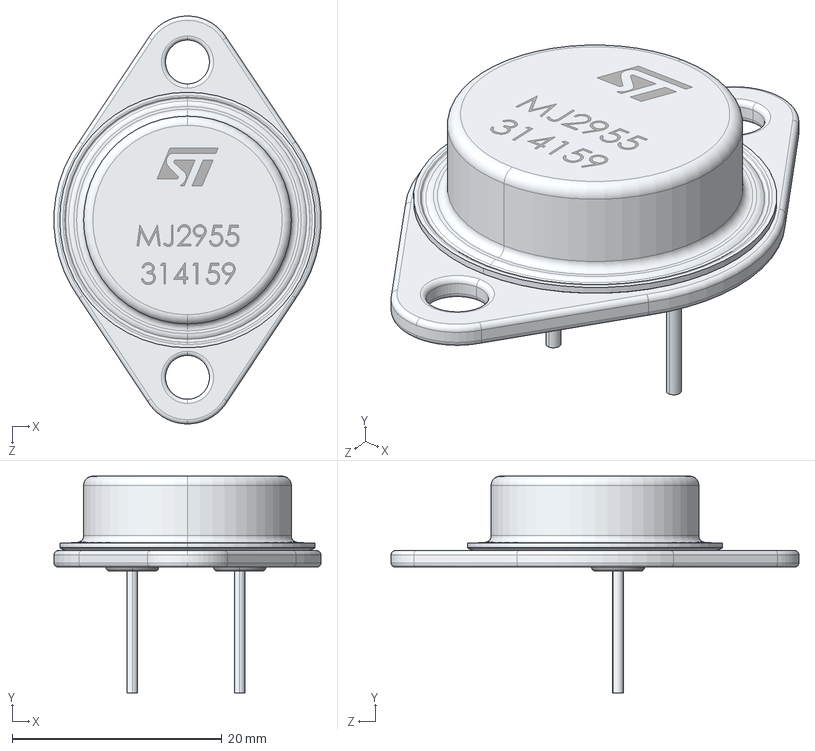
[picture p65: CAD file, 2024-10-12]
CAD Files/Downloaded Part Files/Transistors/TO3.STEP
25.5 x 20.7 x 38.9 mm
