CharlieW112/Programmable-Electronic-Load/CAD Files/STL Files/Dust Filters/SMALL TOOL.stl

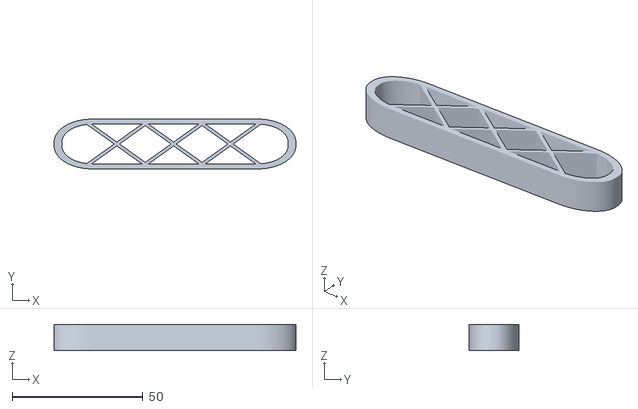
[picture p66: CAD file, 2025-04-07]
CAD Files/STL Files/Dust Filters/SMALL TOOL.stl
92.5 x 19.0 x 10.00
