CharlieW112/Programmable-Electronic-Load/CAD Files/STL Files/Rotary Encoder Knob.stl

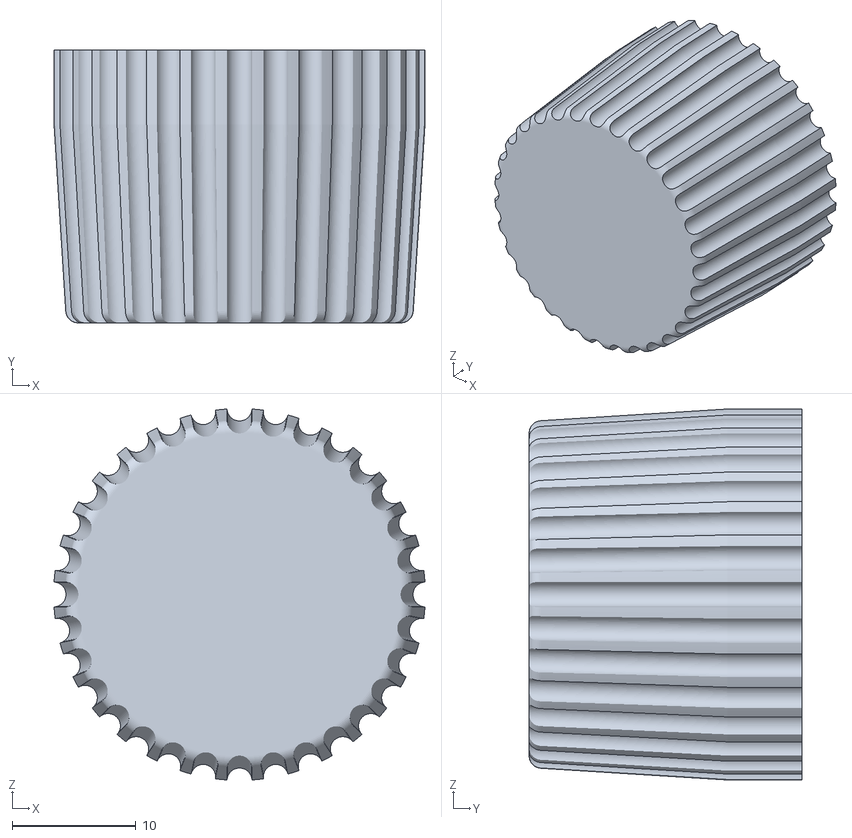
[picture p67: CAD file, 2025-04-07]
CAD Files/STL Files/Rotary Encoder Knob.stl
29.9 x 22.0 x 29.9
