CharlieW112/Programmable-Electronic-Load/KiCad/V1/LED Board/LED_BOARD/LED_BOARD.step

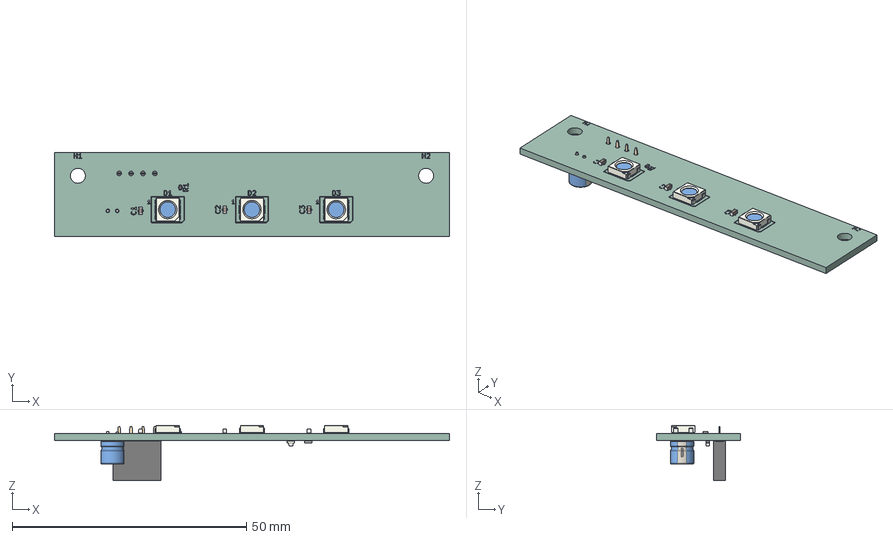
[picture p68: CAD file, 2025-04-07]
KiCad/V1/LED Board/LED_BOARD/LED_BOARD.step
84.4 x 18.0 x 11.8 mm
LED_WS2812B_PLCC4_5.0x5.0mm_P3.2mm x 3
R_0402_1005Metric
C_0603_1608Metric x 3
LED_0603_1608Metric
CP_Radial_D5.0mm_P2.00mm
R_0603_1608Metric
PinSocket_1x04_P2.54mm_Vertical
LED_BOARD_silkscreen
LED_BOARD_PCB
