CharlieW112/Programmable-Electronic-Load/KiCad/V1/Power Regulation Board/Power Regulation/Power Regulation.step

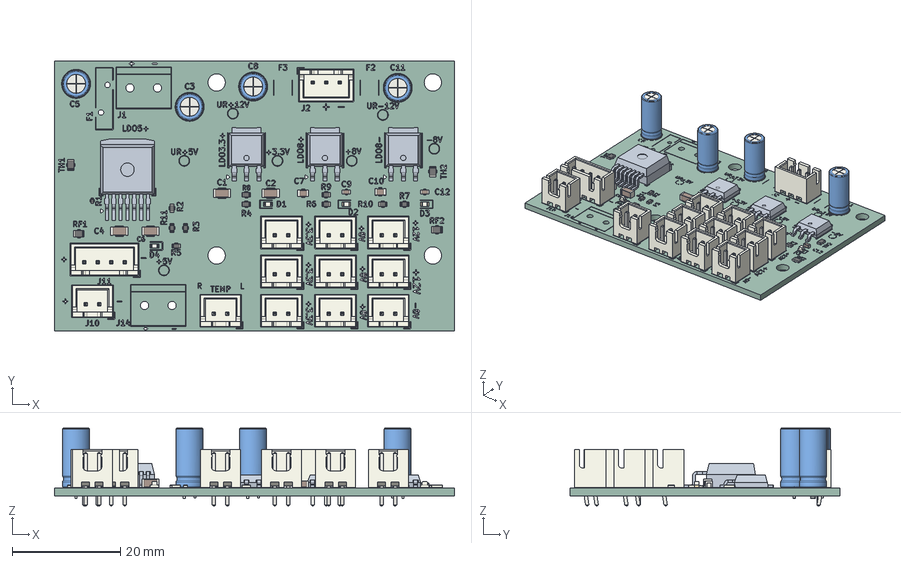
[picture p69: CAD file, 2025-04-07]
KiCad/V1/Power Regulation Board/Power Regulation/Power Regulation.step
74.0 x 50.0 x 14.4 mm
R_0402_1005Metric
R_0603_1608Metric x 10
LED_0603_1608Metric x 4
Power Regulation 1.4.1 x 3
R_0805_2012Metric x 4
JST_XH_B2B-XH-A_1x02_P2.50mm_Vertical x 11
C_Radial_D5.0mm_H11.0mm_P2.00mm x 4
C_1206_3216Metric x 4
C_0805_2012Metric x 2
C_0603_1608Metric x 2
Power Regulation 1.41.1
JST_XH_B3B-XH-A_1x03_P2.50mm_Vertical
JST_XH_B4B-XH-A_1x04_P2.50mm_Vertical
Power Regulation_silkscreen
Power Regulation_PCB
