CharlieW112/Programmable-Electronic-Load/CAD Files/Downloaded Part Files/Fans/80x80x25/80x80x25 fan blade.SLDPRT

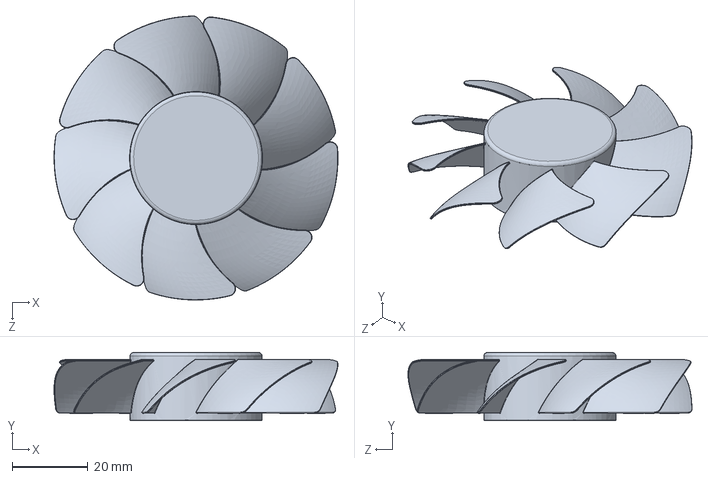
[picture p71: CAD file, 2024-10-12]
CAD Files/Downloaded Part Files/Fans/80x80x25/80x80x25 fan blade.SLDPRT
75.1 x 18.0 x 75.1 mm
