CharlieW112/Programmable-Electronic-Load/CAD Files/STL Files/Dust Filters/MEDIUM Outer Ring.stl

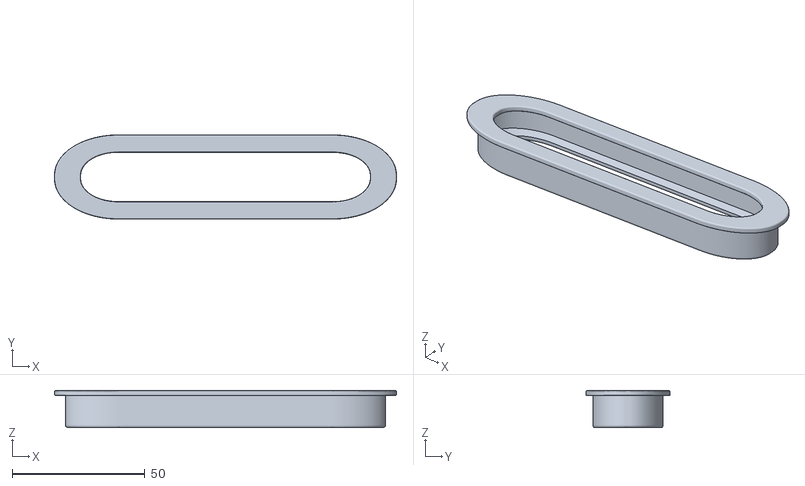
[picture p72: CAD file, 2025-04-07]
CAD Files/STL Files/Dust Filters/MEDIUM Outer Ring.stl
129.0 x 31.7 x 14.0
