CharlieW112/Programmable-Electronic-Load/CAD Files/STL Files/Binding Post Insulator.stl

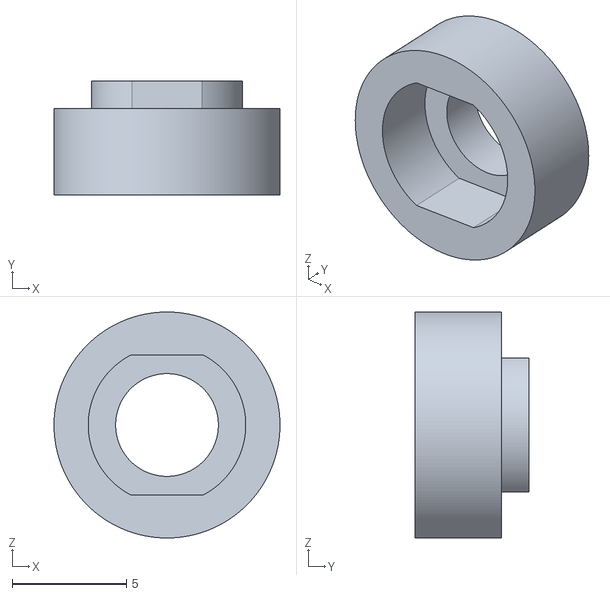
[picture p73: CAD file, 2025-01-18]
CAD Files/STL Files/Binding Post Insulator.stl
9.90 x 5.00 x 9.90
