CharlieW112/Programmable-Electronic-Load/CAD Files/STL Files/Dust Filters/SMALL Inner Ring.stl

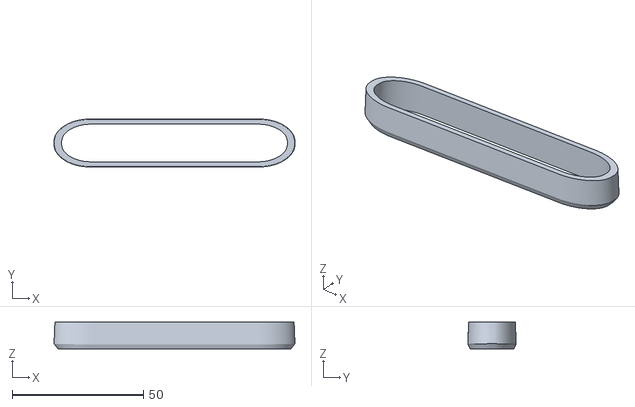
[picture p74: CAD file, 2025-04-07]
CAD Files/STL Files/Dust Filters/SMALL Inner Ring.stl
91.8 x 18.3 x 10.2
