CharlieW112/Programmable-Electronic-Load/CAD Files/STL Files/Display Bezel.stl

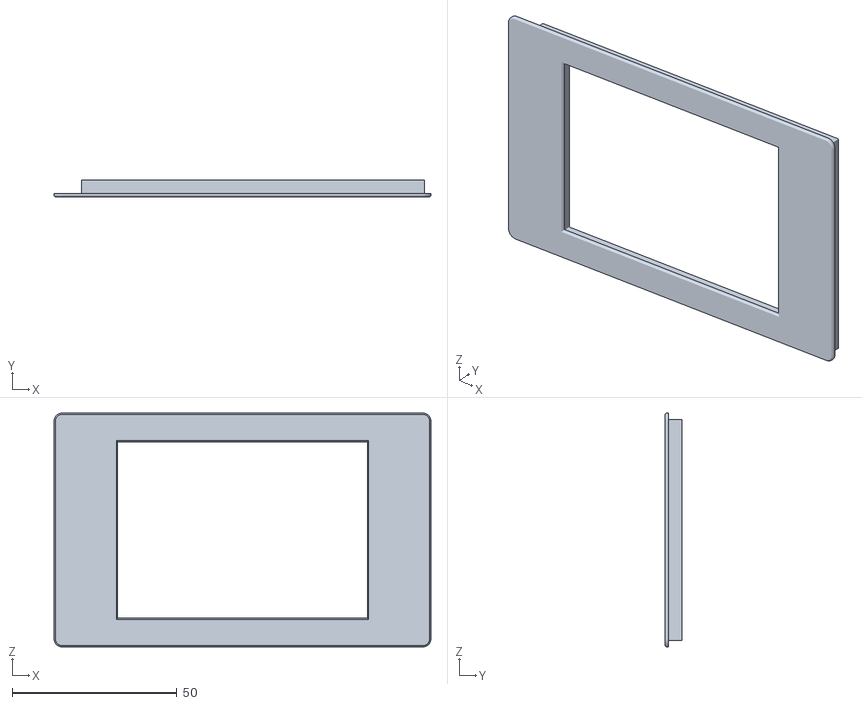
[picture p75: CAD file, 2025-01-18]
CAD Files/STL Files/Display Bezel.stl
114.4 x 5.10 x 71.0
