CharlieW112/Programmable-Electronic-Load/CAD Files/STL Files/Dust Filters/LARGE Inner Ring.3mf

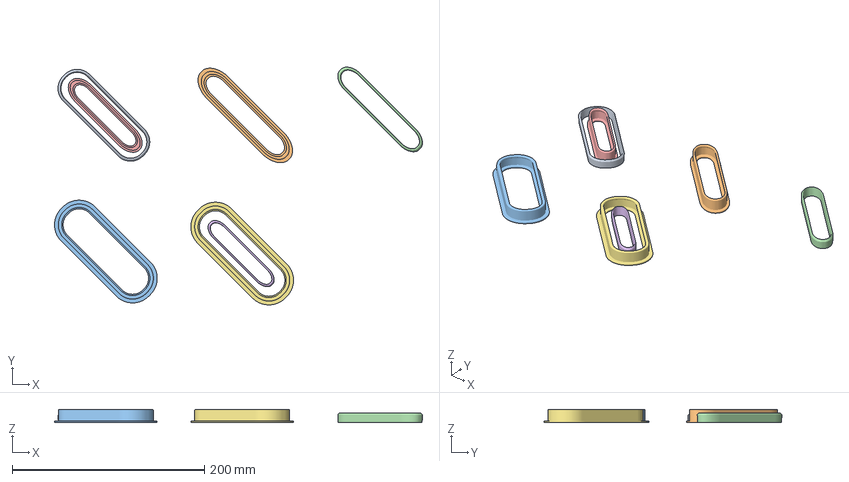
[picture p76: CAD file, 2025-04-07]
CAD Files/STL Files/Dust Filters/LARGE Inner Ring.3mf
383.2 x 247.6 x 14.0 mm
LARGE Inner Ring.stl
MEDIUM Outer Ring.stl
LARGE Outer Ring.stl x 2
MEDIUM Inner Ring.stl
SMALL Outer Ring.stl
SMALL Inner Ring.stl
