CharlieW112/Programmable-Electronic-Load/CAD Files/STL Files/Dust Filters/MEDIUM Inner Ring.stl

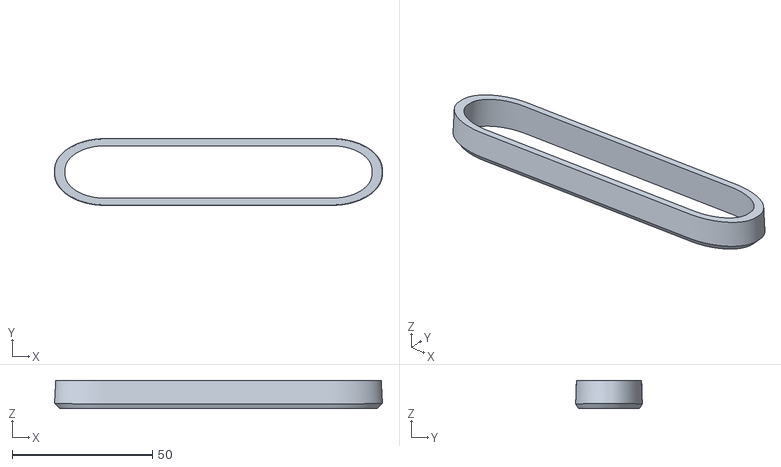
[picture p77: CAD file, 2025-04-07]
CAD Files/STL Files/Dust Filters/MEDIUM Inner Ring.stl
116.9 x 23.8 x 10.1
