CharlieW112/Programmable-Electronic-Load/CAD Files/STL Files/Fan Dust Filter.stl

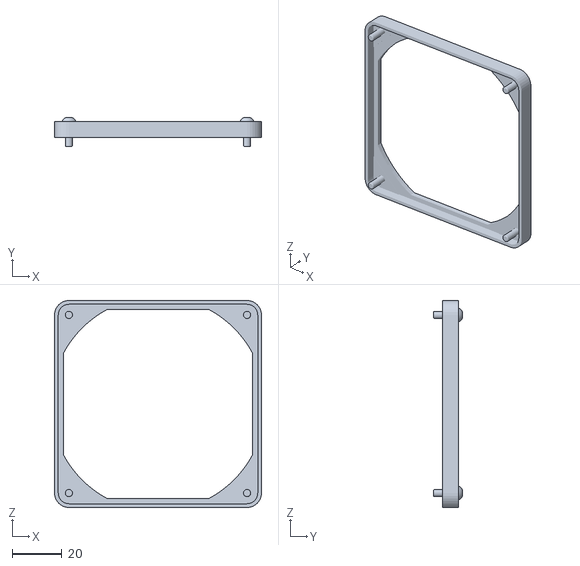
[picture p78: CAD file, 2024-10-31]
CAD Files/STL Files/Fan Dust Filter.stl
83.1 x 11.6 x 83.1
