CharlieW112/Programmable-Electronic-Load/CAD Files/STL Files/Dust Filters/LARGE Outer Ring.3mf

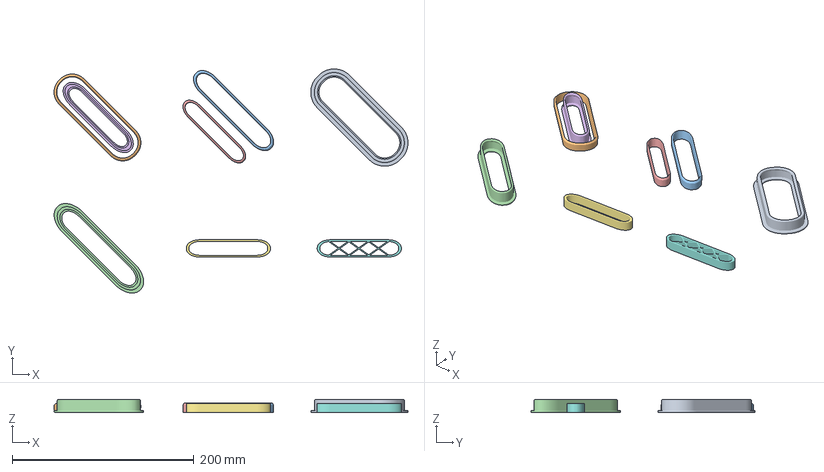
[picture p79: CAD file, 2025-04-07]
CAD Files/STL Files/Dust Filters/LARGE Outer Ring.3mf
389.4 x 246.5 x 14.0 mm
LARGE Outer Ring.stl
LARGE Inner Ring.stl
MEDIUM Inner Ring.stl
MEDIUM Outer Ring.stl
SMALL Inner Ring.stl
SMALL Outer Ring.stl
SMALL TOOL.stl x 2
