CharlieW112/Programmable-Electronic-Load/CAD Files/STL Files/Dust Filters/SMALL Outer Ring.stl

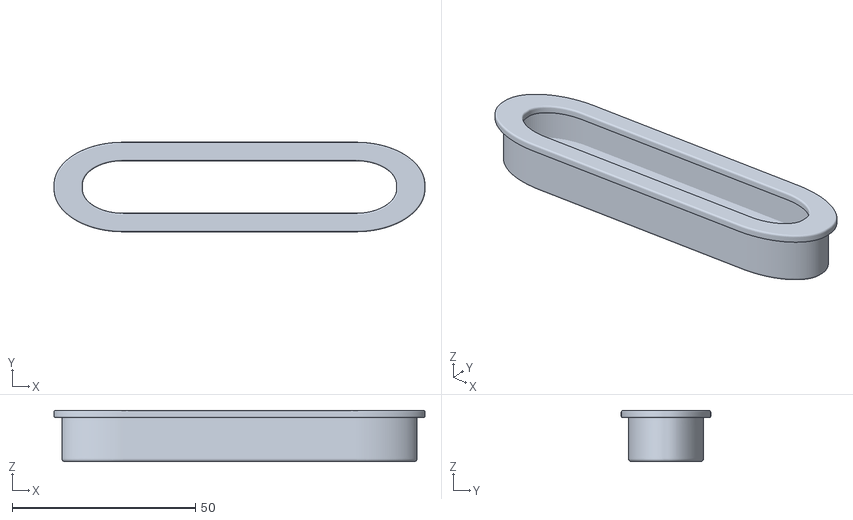
[picture p80: CAD file, 2025-04-07]
CAD Files/STL Files/Dust Filters/SMALL Outer Ring.stl
101.3 x 24.5 x 14.0
