CharlieW112/Programmable-Electronic-Load/CAD Files/STL Files/Right Dust Covers.stl

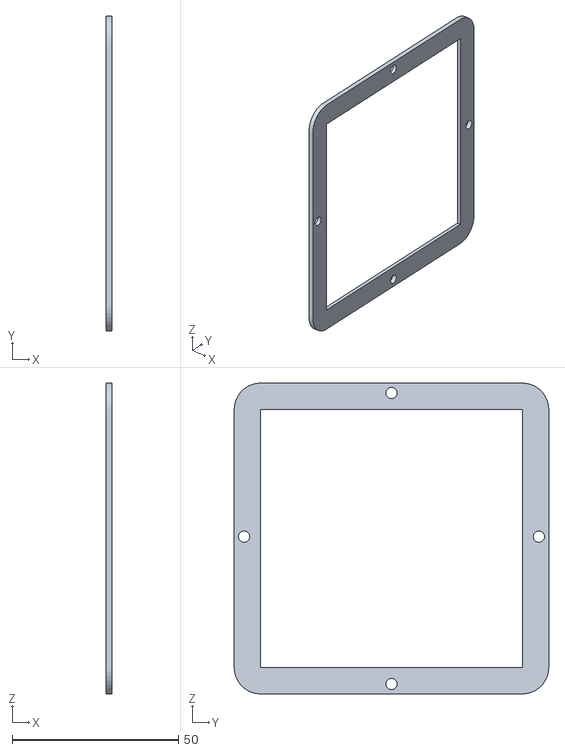
[picture p81: CAD file, 2024-10-31]
CAD Files/STL Files/Right Dust Covers.stl
1.80 x 94.8 x 93.6
