CharlieW112/Programmable-Electronic-Load/CAD Files/STL Files/Front Outer Ring.stl

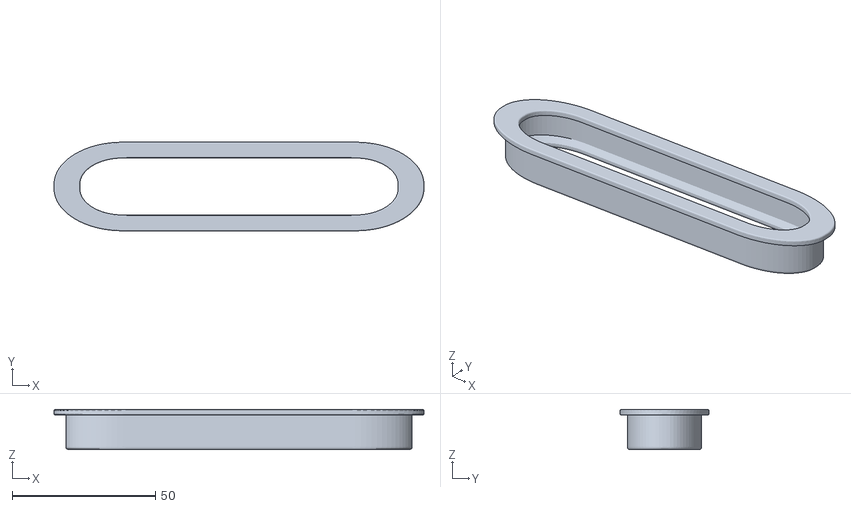
[picture p82: CAD file, 2024-10-31]
CAD Files/STL Files/Front Outer Ring.stl
129.0 x 30.9 x 14.0
