CharlieW112/Programmable-Electronic-Load/CAD Files/STL Files/Inner Ring.stl

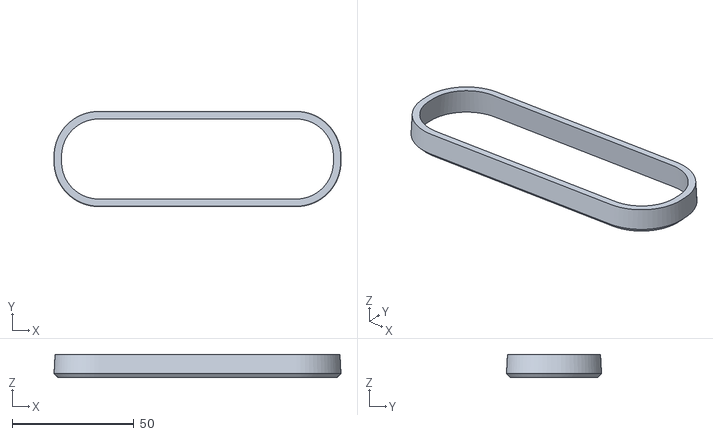
[picture p83: CAD file, 2024-10-31]
CAD Files/STL Files/Inner Ring.stl
117.6 x 39.0 x 9.50
