CharlieW112/Programmable-Electronic-Load/CAD Files/STL Files/Mesh Temporary Spacer.stl

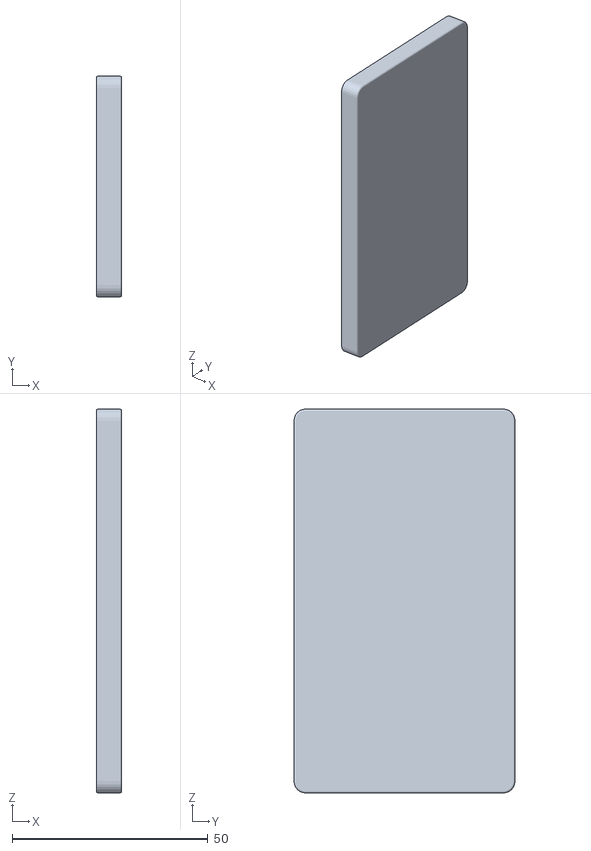
[picture p84: CAD file, 2024-10-31]
CAD Files/STL Files/Mesh Temporary Spacer.stl
6.50 x 56.4 x 98.0
