CharlieW112/Programmable-Electronic-Load/CAD Files/STL Files/Rear Dust Filter Outline.stl

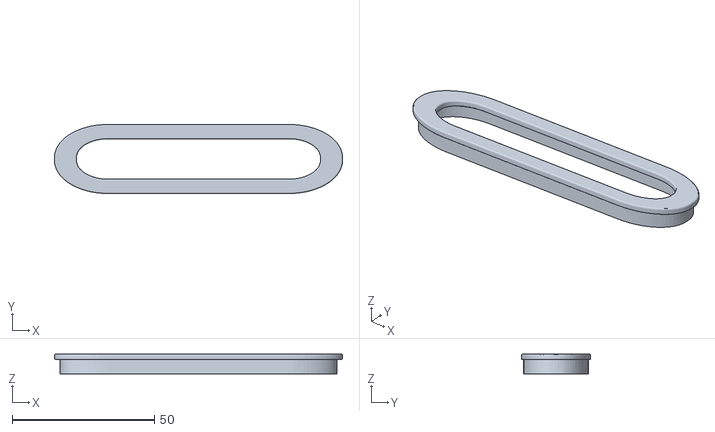
[picture p85: CAD file, 2024-10-31]
CAD Files/STL Files/Rear Dust Filter Outline.stl
101.1 x 24.2 x 7.00
