CharlieW112/Programmable-Electronic-Load/CAD Files/STL Files/Outer Ring.stl

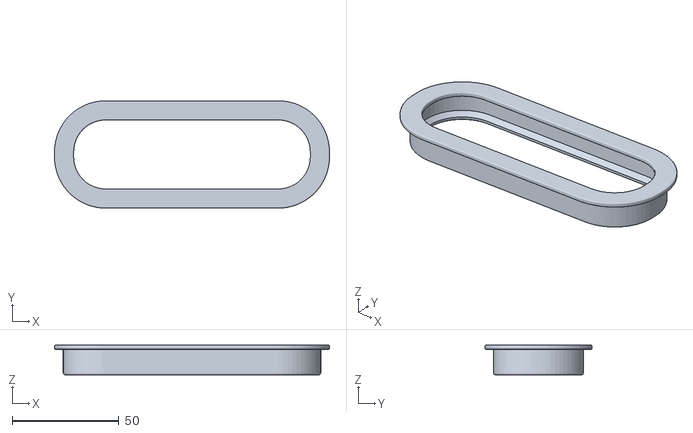
[picture p86: CAD file, 2024-10-31]
CAD Files/STL Files/Outer Ring.stl
129.0 x 50.4 x 14.0
