CharlieW112/Programmable-Electronic-Load/CAD Files/STL Files/PSU Bracket.stl

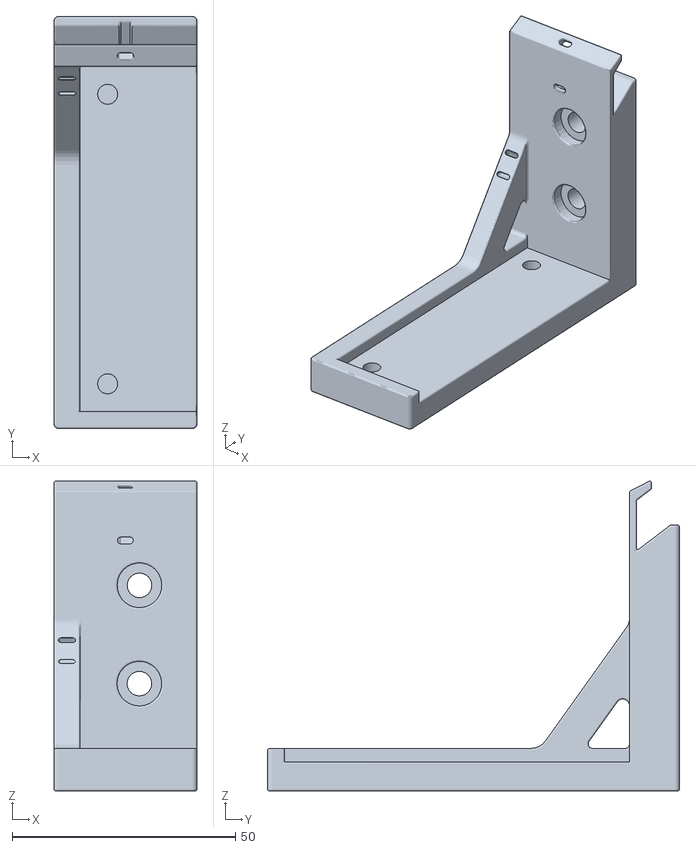
[picture p87: CAD file, 2024-10-31]
CAD Files/STL Files/PSU Bracket.stl
32.0 x 92.2 x 69.3
