CharlieW112/Programmable-Electronic-Load/CAD Files/STL Files/M3 Spacer.stl

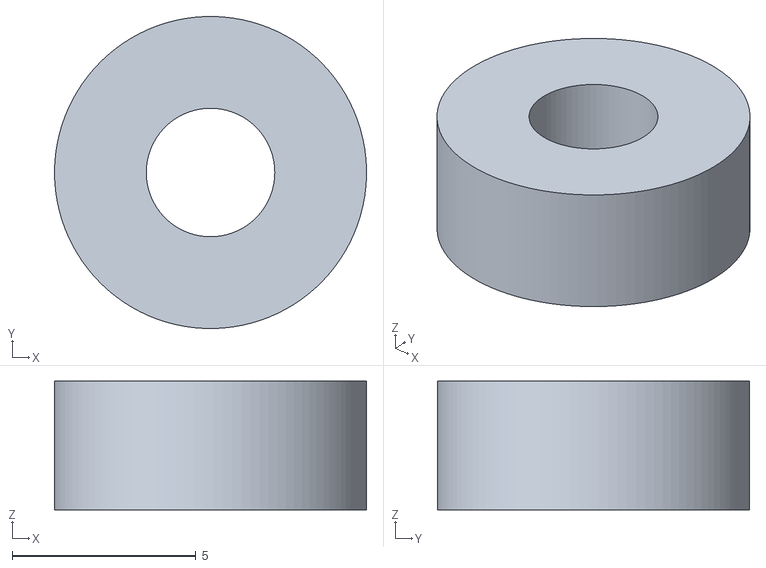
[picture p88: CAD file, 2024-10-31]
CAD Files/STL Files/M3 Spacer.stl
8.50 x 8.50 x 3.50
