CharlieW112/Programmable-Electronic-Load/CAD Files/STL Files/Small Outer Ring Scaled Up.stl

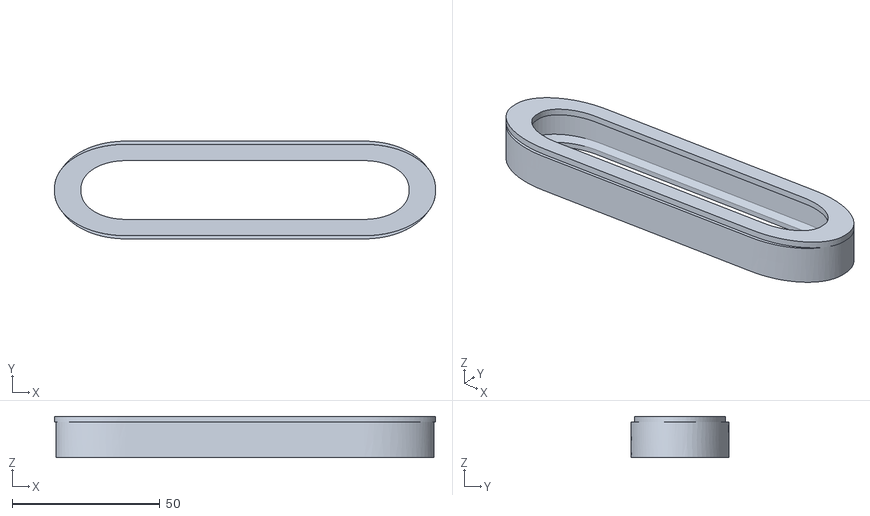
[picture p89: CAD file, 2024-10-31]
CAD Files/STL Files/Small Outer Ring Scaled Up.stl
129.0 x 33.1 x 14.0
