CharlieW112/Programmable-Electronic-Load/CAD Files/STL Files/Front Inner Ring.stl

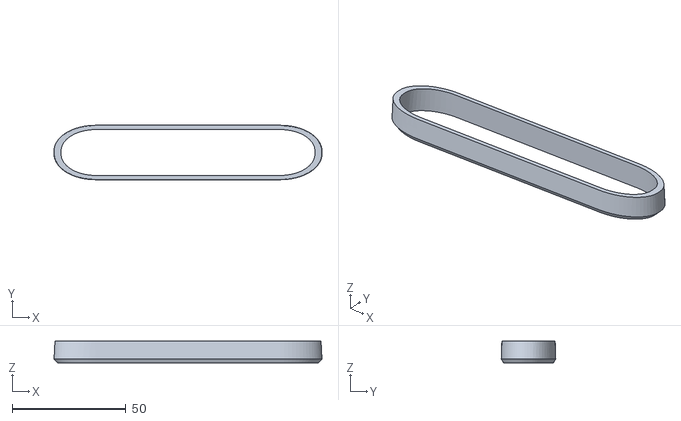
[picture p90: CAD file, 2024-10-31]
CAD Files/STL Files/Front Inner Ring.stl
117.6 x 23.9 x 9.50
