CharlieW112/Programmable-Electronic-Load/CAD Files/STL Files/Cable Clip.stl

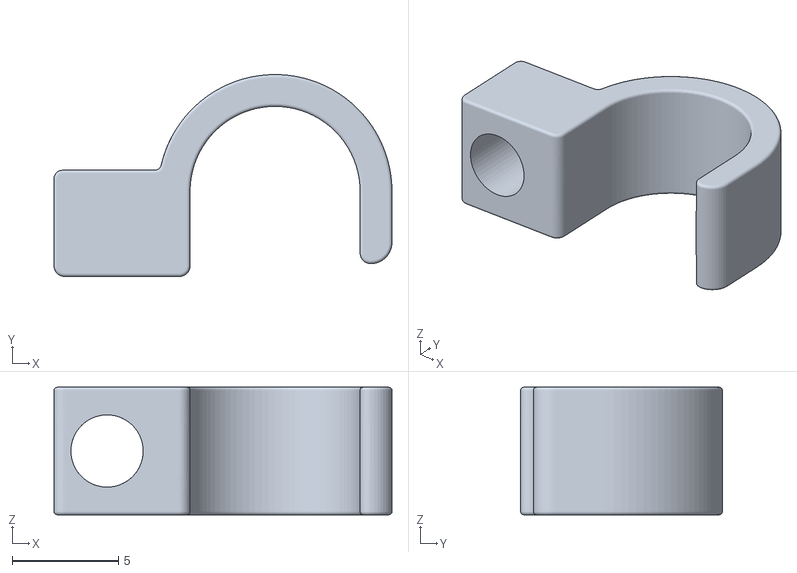
[picture p91: CAD file, 2024-10-31]
CAD Files/STL Files/Cable Clip.stl
15.9 x 9.50 x 6.00
