CharlieW112/Programmable-Electronic-Load/CAD Files/STL Files/Filter Clip.stl

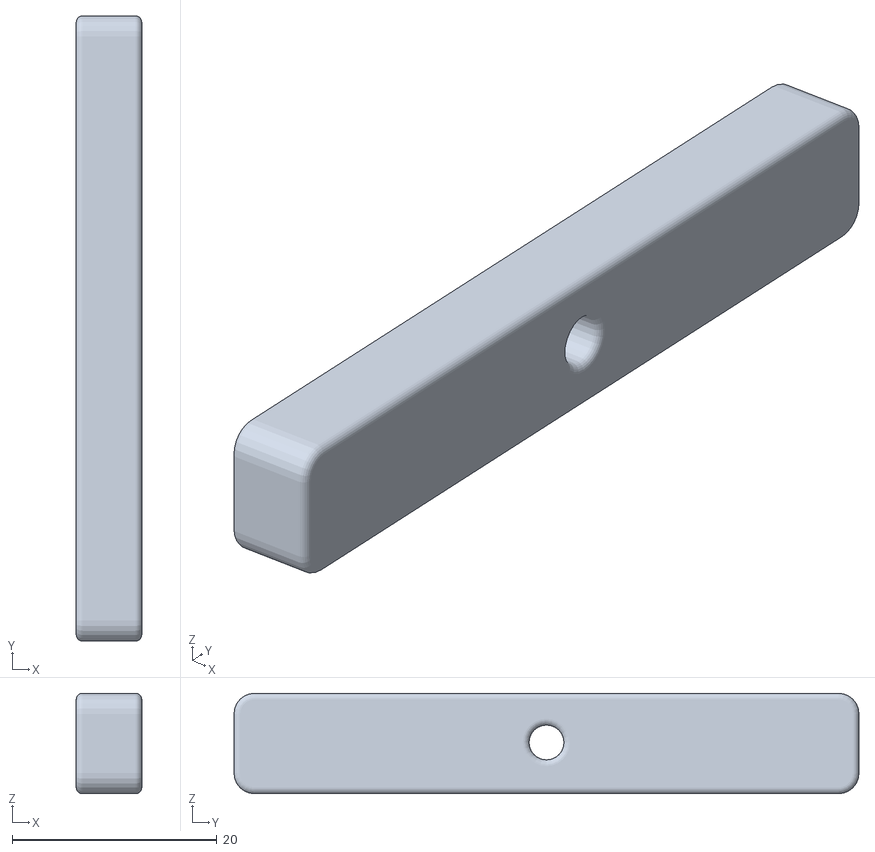
[picture p92: CAD file, 2024-10-31]
CAD Files/STL Files/Filter Clip.stl
6.40 x 61.0 x 9.80
