CharlieW112/Programmable-Electronic-Load/CAD Files/STL Files/Left Mesh Outer Body.stl

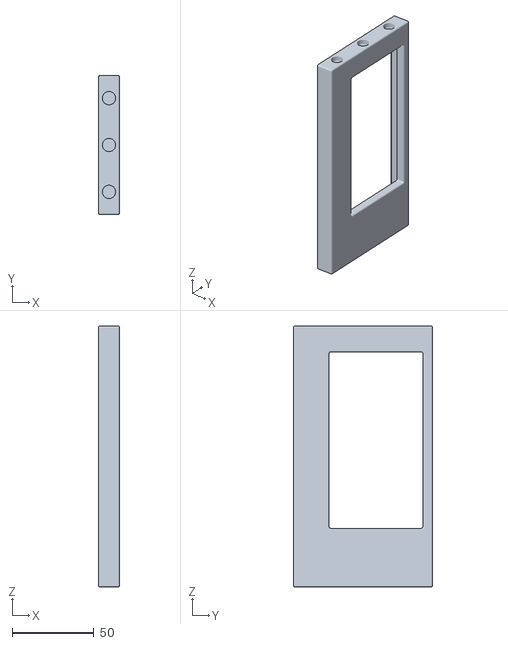
[picture p93: CAD file, 2024-10-31]
CAD Files/STL Files/Left Mesh Outer Body.stl
13.0 x 85.4 x 160.0
