CharlieW112/Programmable-Electronic-Load/CAD Files/STL Files/Body1.stl

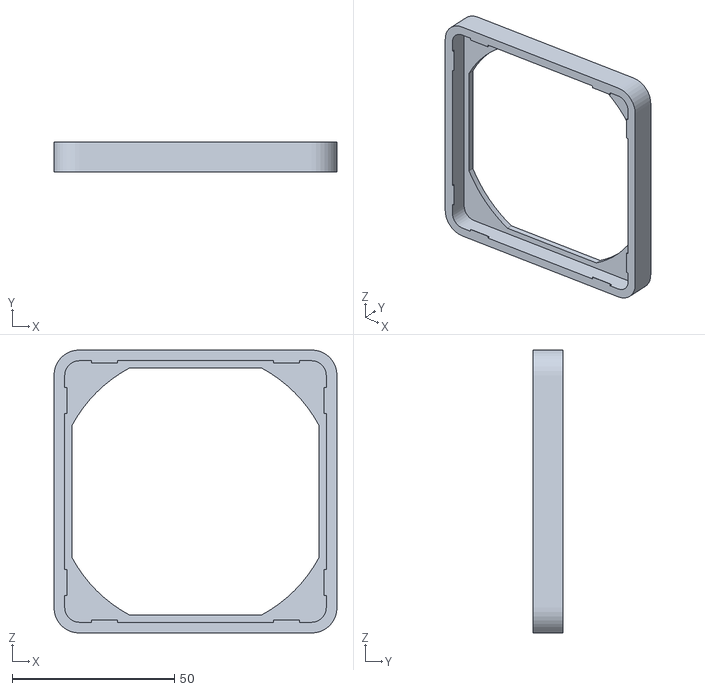
[picture p94: CAD file, 2024-10-31]
CAD Files/STL Files/Body1.stl
87.1 x 9.12 x 87.1
