CharlieW112/Programmable-Electronic-Load/CAD Files/STL Files/Outer Body .stl

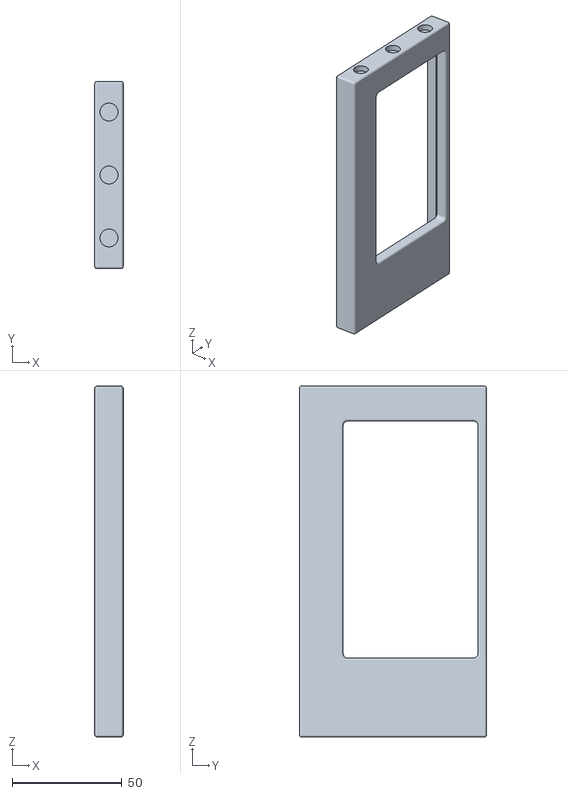
[picture p95: CAD file, 2024-10-31]
CAD Files/STL Files/Outer Body .stl
13.0 x 85.4 x 160.0
