CharlieW112/Programmable-Electronic-Load/CAD Files/STL Files/Left Dust Cover.stl

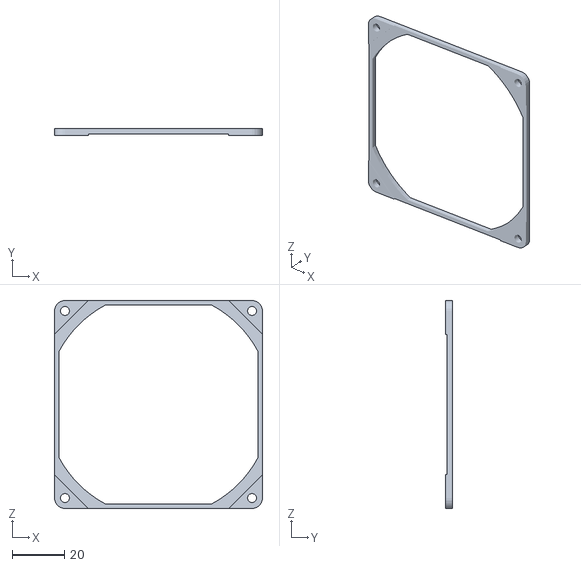
[picture p96: CAD file, 2024-10-31]
CAD Files/STL Files/Left Dust Cover.stl
79.5 x 2.50 x 79.5
