CharlieW112/Programmable-Electronic-Load/(list of files, cad)

Other CAD files:
CAD Files/STL Files/Knob.stl
CAD Files/STL Files/Rear Inner Ring.stl
CAD Files/STL Files/PSU Bracket Mirror.stl
CAD Files/STL Files/Rear Outer Ring.stl
CAD Files/STL Files/Right Mesh Outer Body.stl
CAD Files/STL Files/Right Outer Body.stl
CAD Files/STL Files/Left Outer Body.stl
CAD Files/Downloaded Part Files/5mm RGB LED/Led RGB 5mm.SLDASM
CAD Files/Downloaded Part Files/Binding Posts/Low-Current/Banana jack (4mm female socket).f3d
CAD Files/Downloaded Part Files/Power Line Filter/CW4EL2-10A-T EMI v2.f3d
CAD Files/Downloaded Part Files/Power Line Filter/CW4EL2-10A-T EMI v2.iges
CAD Files/Downloaded Part Files/Power Socket/IEC320-C14.SLDASM
CAD Files/STL Files/Dust Filters/LARGE Inner Ring.stl
CAD Files/STL Files/Dust Filters/LARGE Outer Ring.stl
CAD Files/STL Files/Inner Ring (1).stl
CAD Files/STL Files/Outer Ring (1).stl
