CharlieW112/Programmable-Electronic-Load/Data/Component Data/MJ15024 Measured Values.xlsx

Transistor | hFE | Ie (mA) | Vbe (mV)
1 | 21.7 | 0.17 | 470
2 | 25.7 | 0.21 | 474
3 | 25.1 | 0.2 | 472
4 | 23.5 | 0.19 | 471 | 24
5 | 45 | 6.2 | 566
6 | 25.3 | 6.1 | 567
7 | 34.1 | 6.2 | 567
8 | 30.7 | 6.2 | 562
