CharlieW112/Programmable-Electronic-Load/LTSpice/Test Setups/VCCS V2/Handwritten_2025-03-16_183225.jpg

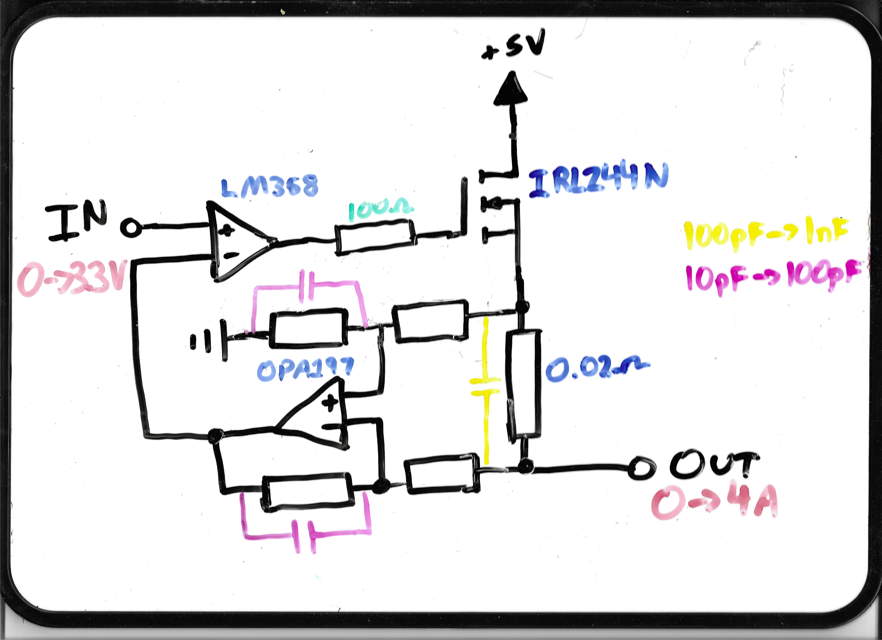
LTSpice/Test Setups/VCCS V2/Handwritten_2025-03-16_183225.jpg
