CharlieW112/Programmable-Electronic-Load/STM32/TouchGFX_Projects/MyApplication/changelog.txt

3.0.19
- Updated to STM32CubeMX 6.13.0
- Updated to Firmware Package FW_F4 V1.28.1

3.0.18
- Updated to STM32CubeMX 6.12.0
- SYSCLK increased from 168 MHz to 180 MHz

3.0.17
- Updated to TouchGFX 4.24.0

3.0.16
- Updated to STM32CubeMX 6.11.0

3.0.15
- Updated to TouchGFX 4.23.0
- Updated to STM32CubeMX 6.10.0
- Updated to FW 1.28.0
- Enabled support for vector fonts

3.0.14
- Upgraded to STM32CubeMX 6.9.1

3.0.13
- Upgraded to TouchGFX 4.22.0

3.0.12
- Upgraded to STM32CubeMX 6.8.0

3.0.11
- Upgraded to TouchGFX 4.21.0
- Upgraded to STM32CubeMX 6.7.0
- Upgraded to Firmware Package FW_F4 1.27.1

3.0.10
- Upgraded to TouchGFX 4.20.0
- Added Readme

3.0.9
- Upgraded to TouchGFX 4.19.1
- Upgraded to STM32CubeMX 6.5.0
- Upgraded to Firmware Package FW_F4 1.27.0
- Added GPIO pins (VSYNC_FREQ, RENDER_TIME, FRAME_RATE, MCU_ACTIVE) for performance testing 

3.0.8
- Upgraded to TouchGFX 4.18.1
- Upgraded to STM32CubeMX 6.4.0

3.0.7
- Upgraded to TouchGFX 4.18

3.0.6
- Upgraded to STM32CubeMX 6.3.0
- Upgraded to Firmware Package FW_F4 1.26.2
- Bugfixing for EWARM

3.0.5
- Upgraded to TouchGFX 4.17
- Upgraded to STM32CubeMX 6.2.1
- Upgraded to Firmware Package FW_F4 1.26.1
- Added DefaultTask to allow IP integration out of STM32CubeMX
