CharlieW112/Programmable-Electronic-Load/CAD Files/V1/Programmable DC Electronic Load Drawing Complete V1 v1.pdf

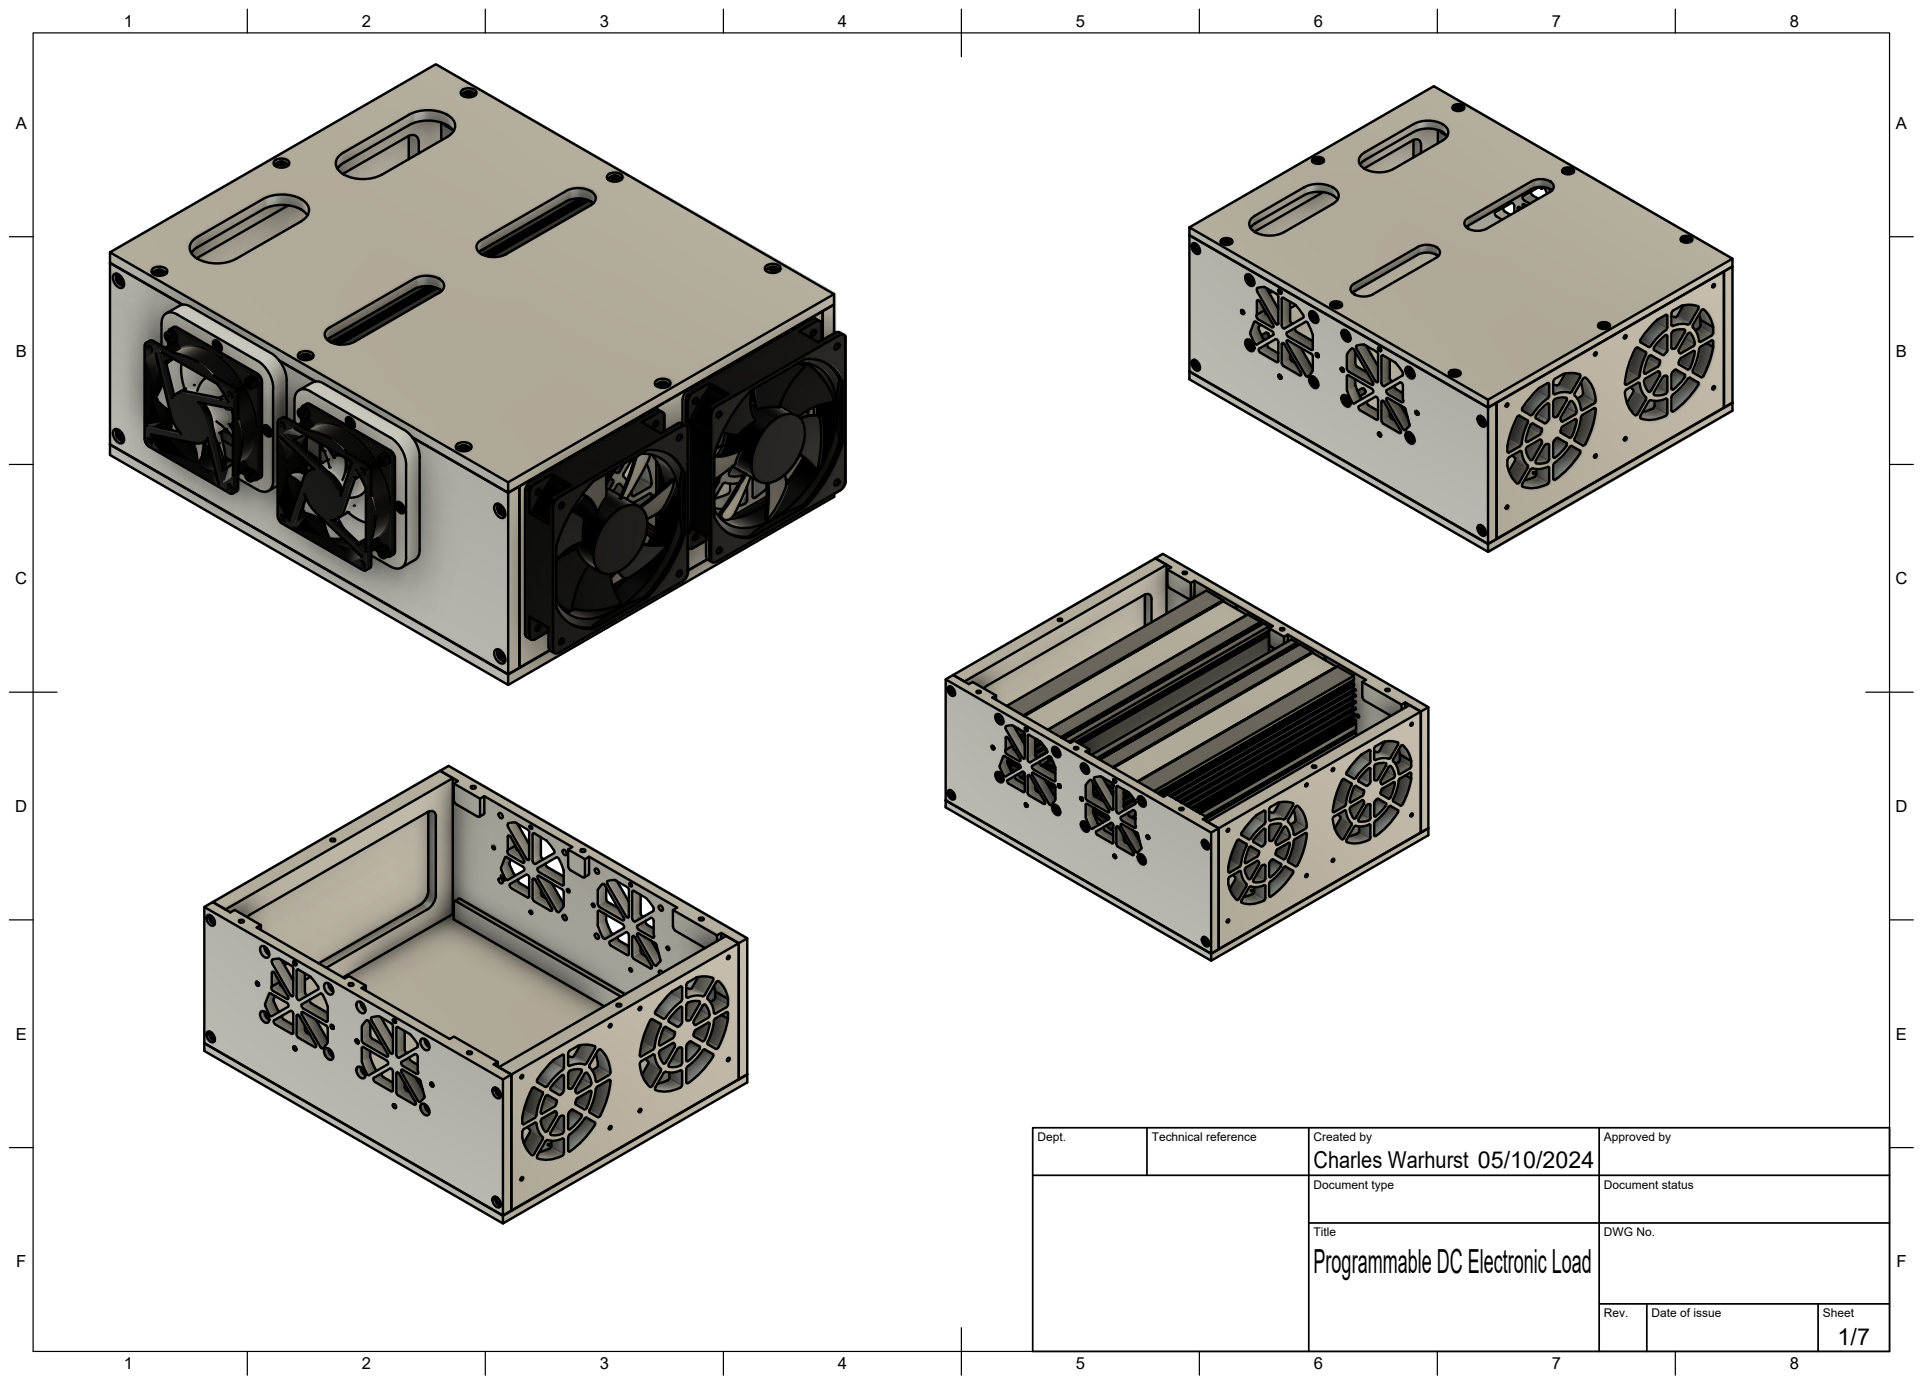
[picture p98: page 1]
Title; DWG No.; Rev.; Date of issue; Sheet

Dept. | Technical reference | Created by Charles Warhurst 05/10/2024 | Approved by

Document type | Document status

Programmable DC Electronic Load

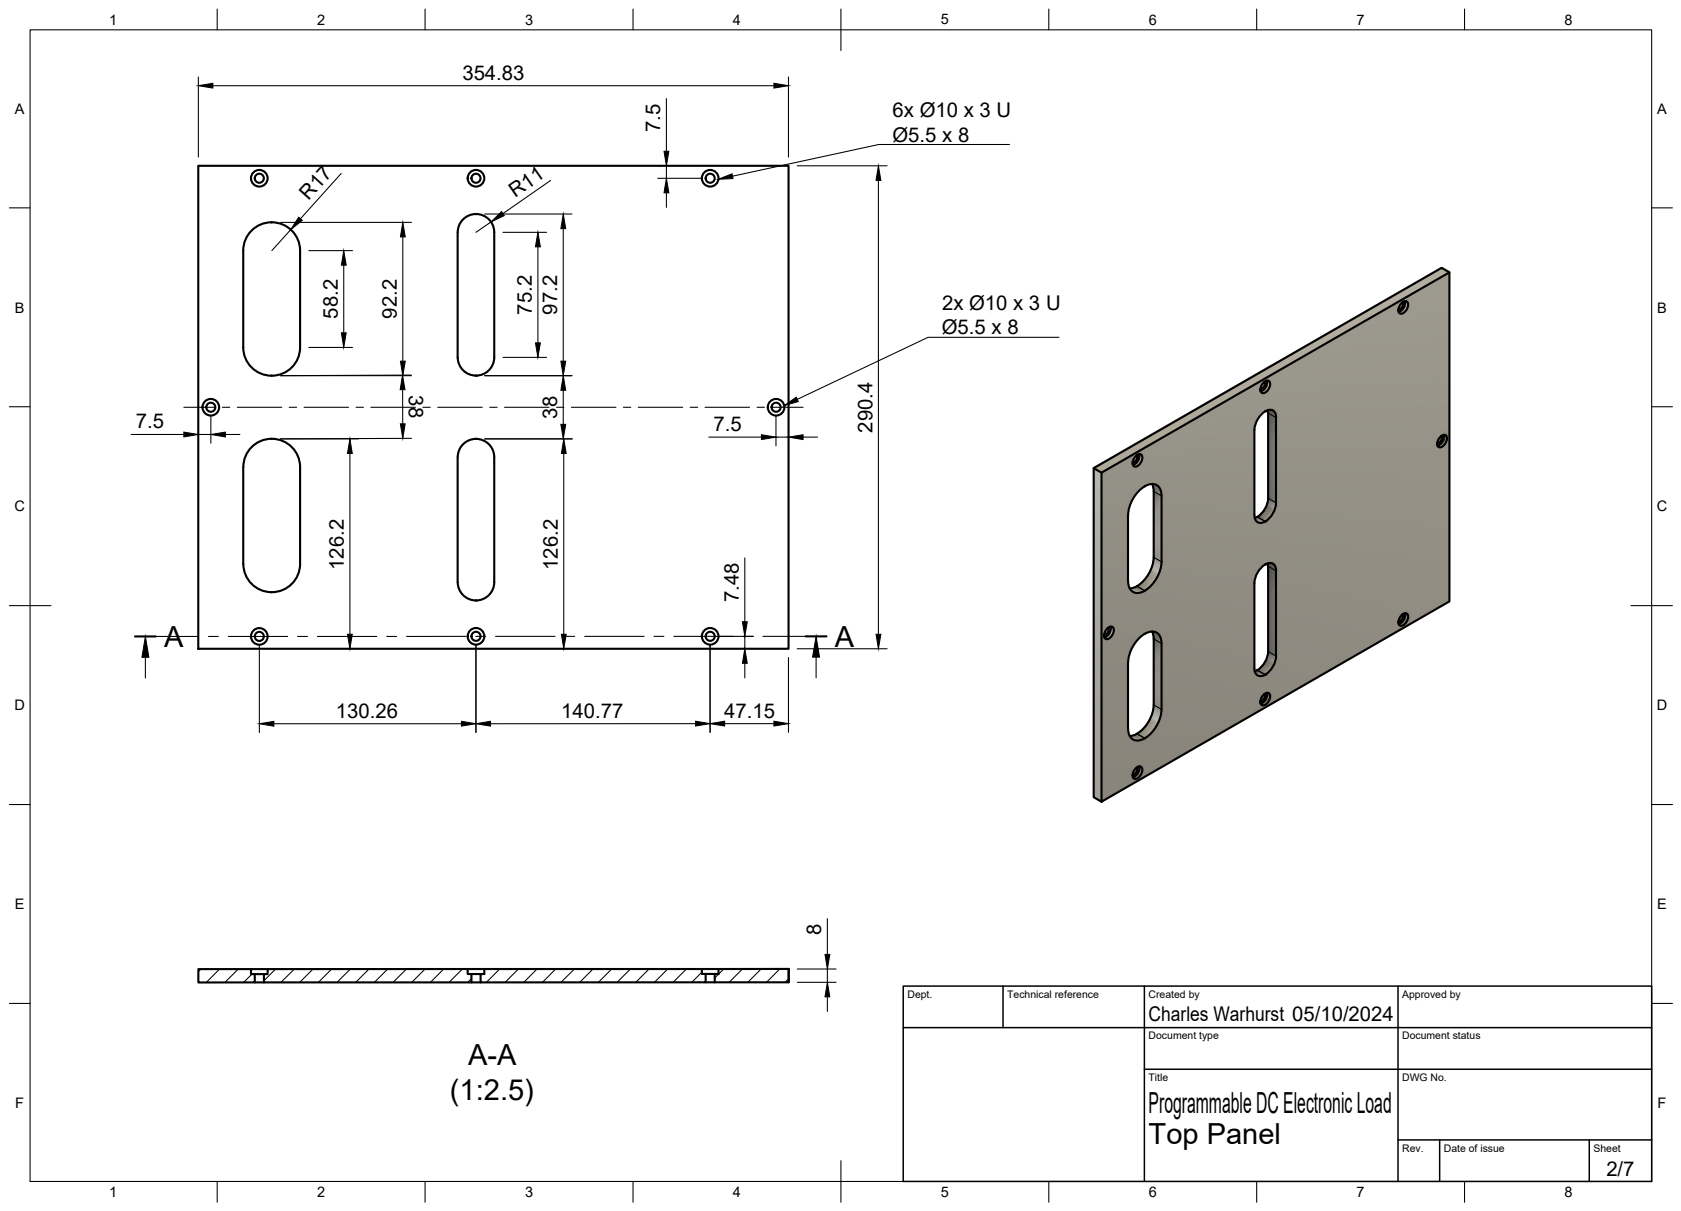
[picture p99: page 2]
Title; DWG No.

Dept. | Technical reference | Created by Charles Warhurst 05/10/2024 | Approved by

Document type | Document status

Programmable DC Electronic Load
Top Panel

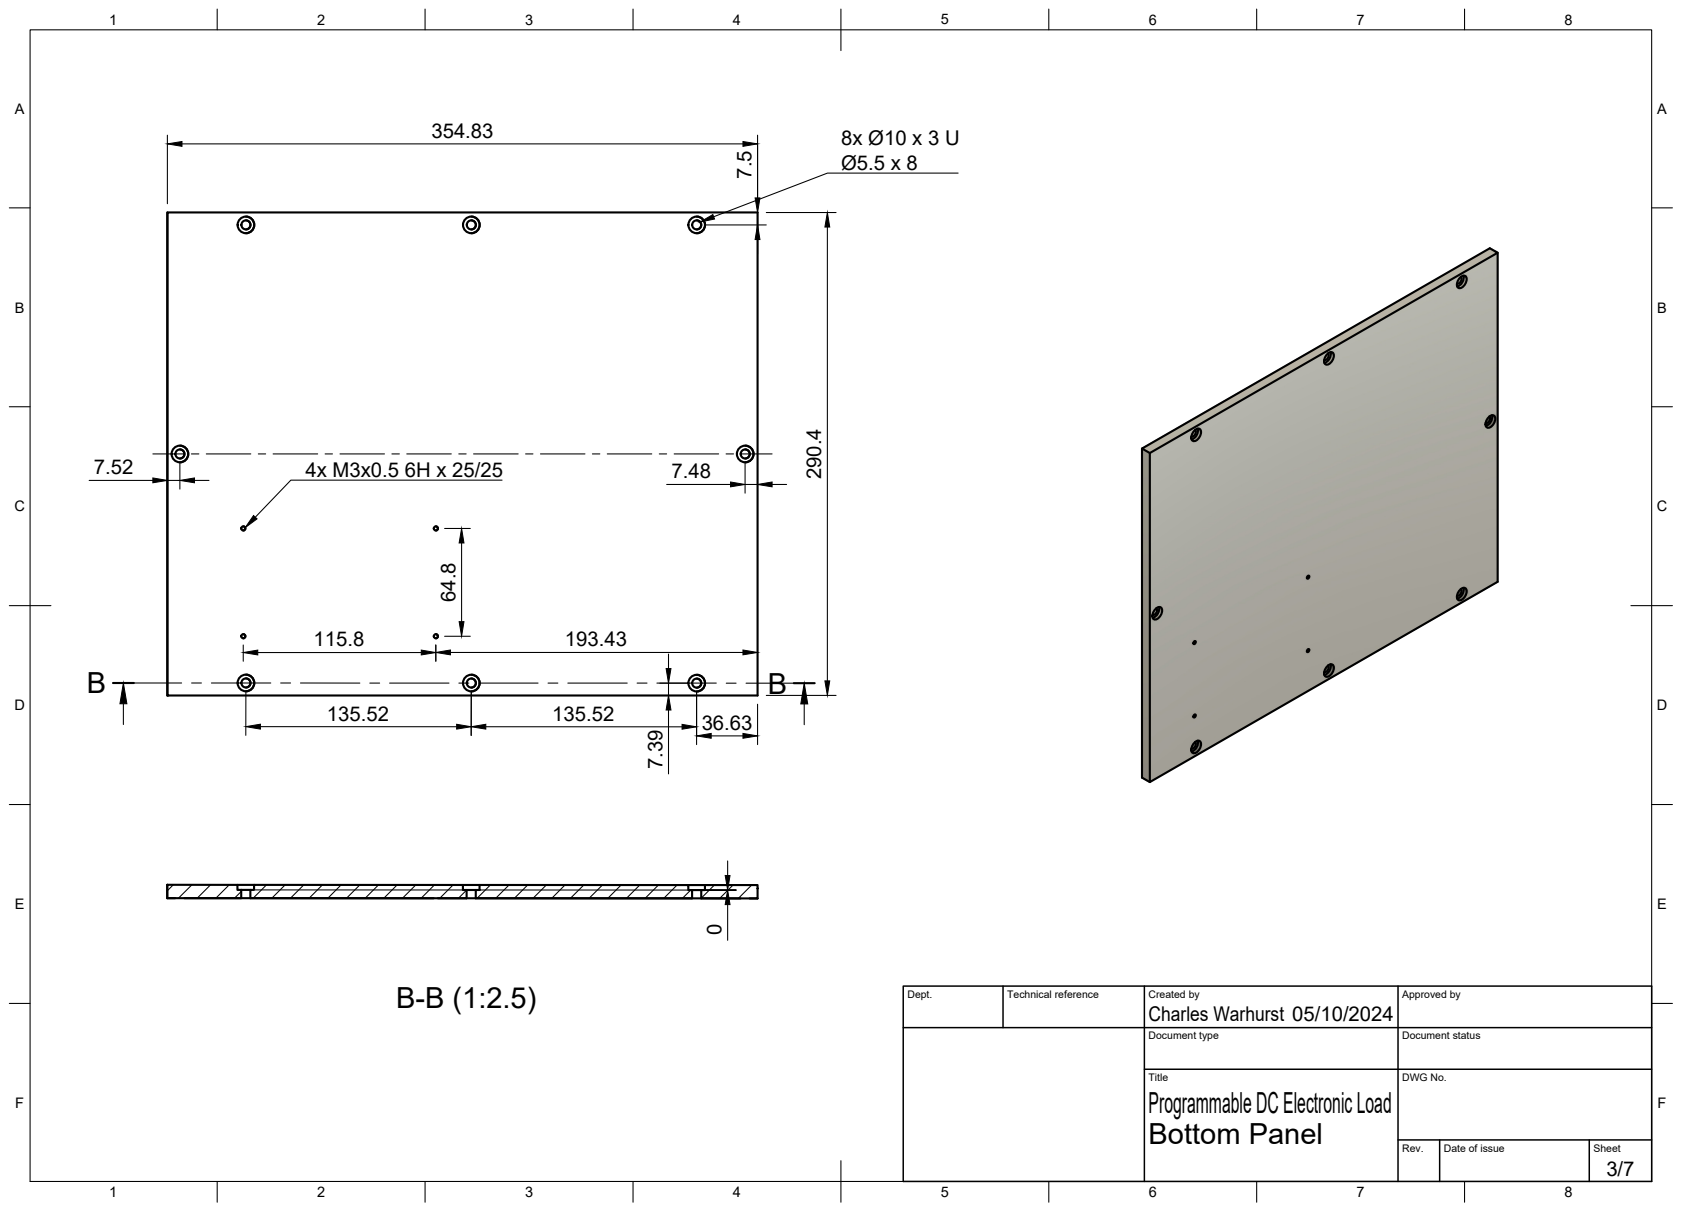
[picture p100: page 3]
Title; DWG No.

Dept. | Technical reference | Created by Charles Warhurst 05/10/2024 | Approved by

Document type | Document status

Programmable DC Electronic Load
Bottom Panel

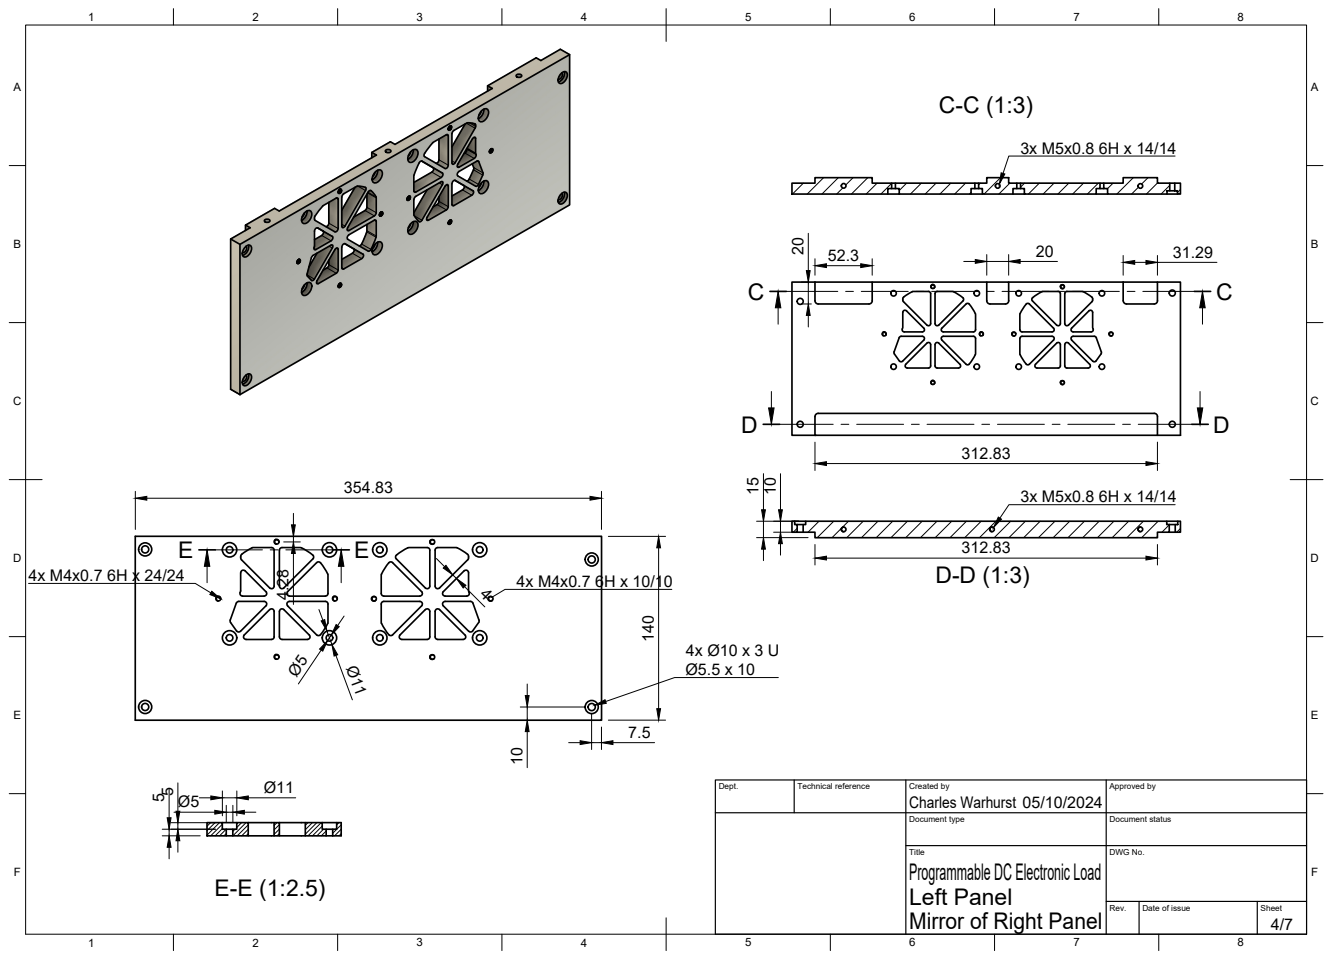
[picture p101: page 4]
Title; DWG No.

Dept. | Technical reference | Created by Charles Warhurst 05/10/2024 | Approved by

Document type | Document status

Programmable DC Electronic Load
Left Panel
Mirror of Right Panel

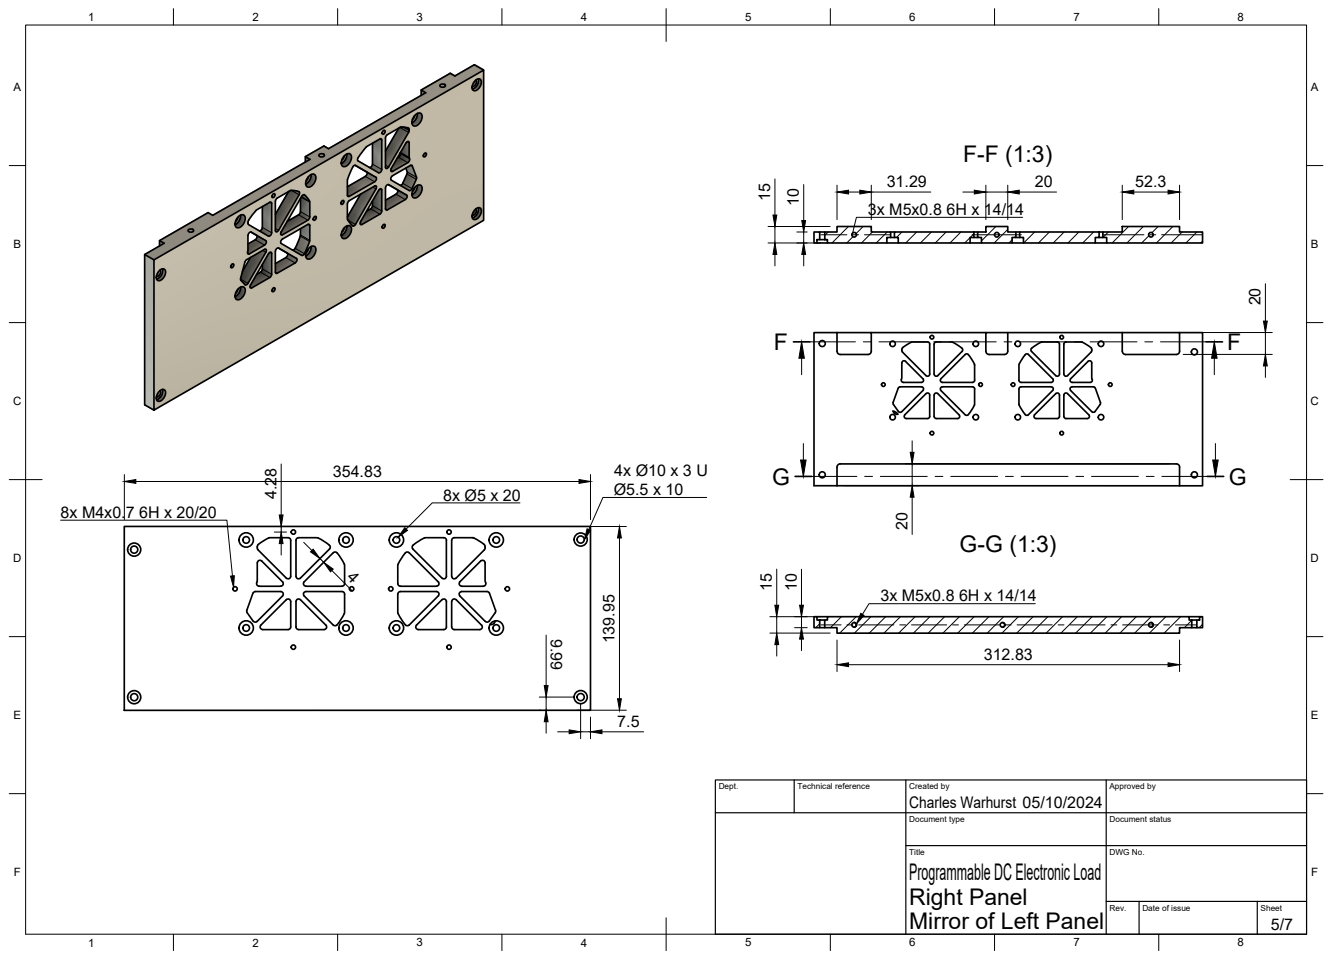
[picture p102: page 5]
Title; DWG No.

Dept. | Technical reference | Created by Charles Warhurst 05/10/2024 | Approved by

Document type | Document status

Programmable DC Electronic Load
Right Panel
Mirror of Left Panel

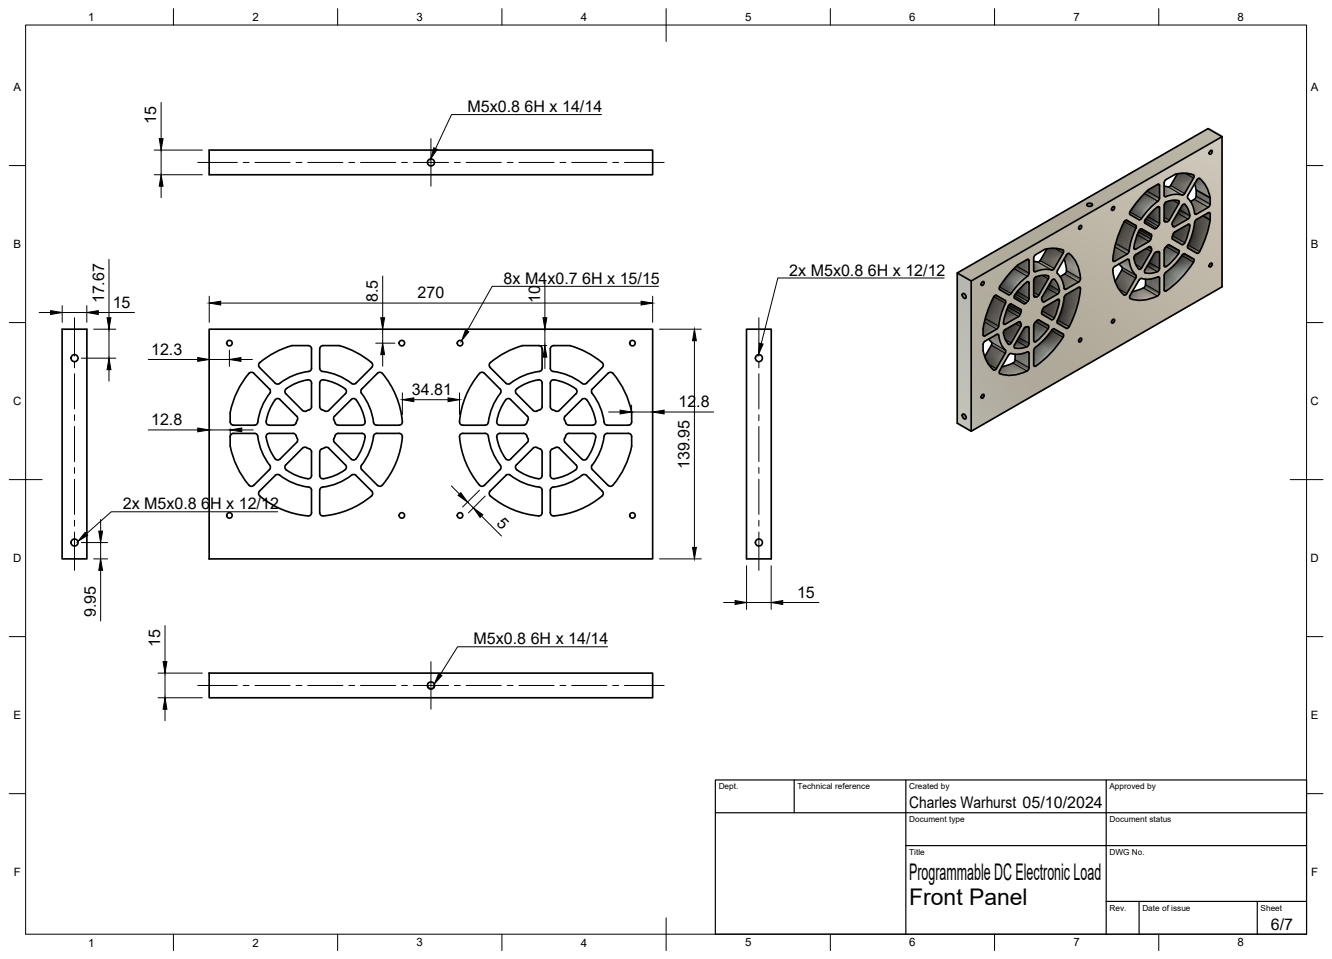
[picture p103: page 6]
Title; DWG No.; Charles Warhurst 139.95

Dept. | Technical reference | Created by 05/10/2024 | Approved by

Document type | Document status

Programmable DC Electronic Load
Front Panel

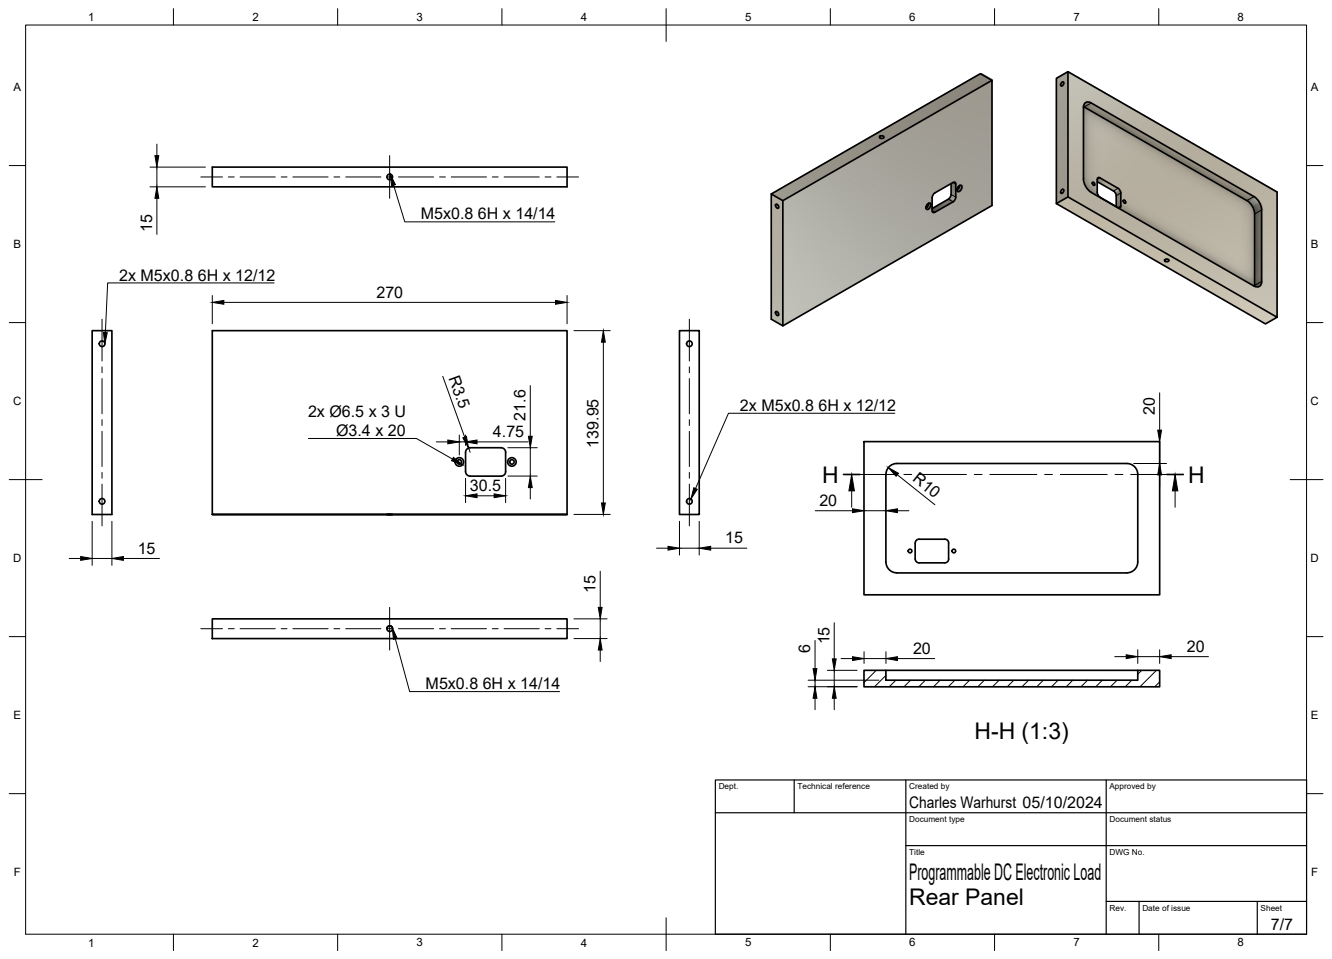
[picture p104: page 7]
Title; DWG No.; Charles Warhurst 139.95

Dept. | Technical reference | Created by 05/10/2024 | Approved by

Document type | Document status

Programmable DC Electronic Load
Rear Panel
