CharlieW112/Programmable-Electronic-Load/LTSpice/Test Setups/VCCS V2/V2 Photo.pdf

## VCCS

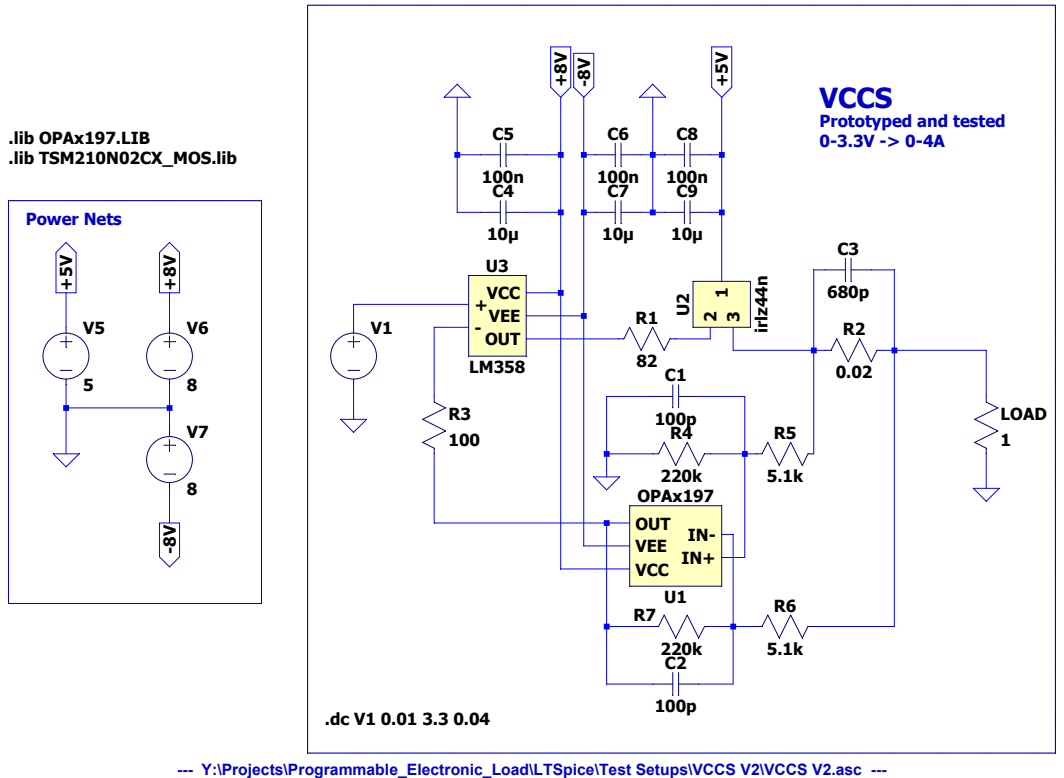
[picture p105: page 1]

--- Y:\Projects\Programmable_Electronic_Load\LTSpice\Test Setups\VCCS V2\VCCS V2.asc ---
