CharlieW112/Programmable-Electronic-Load/CAD Files/Charlie Warhurst - Enclosure Thread Info.pdf

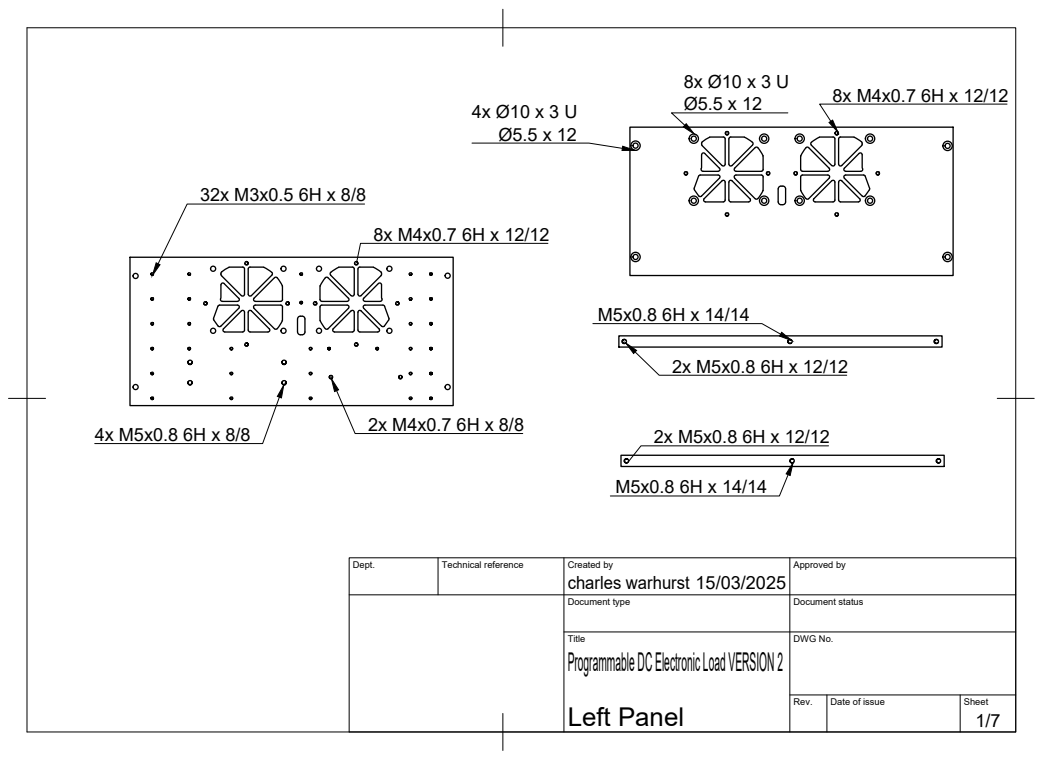
[picture p106: page 1]

Dept. | Technical reference | Created by charles warhurst 15/03/2025 | Approved by

Document type | Document status

Title Programmable DC Electronic Load VERSION 2 Left Panel | DWG No.

Rev. | Date of issue | Sheet

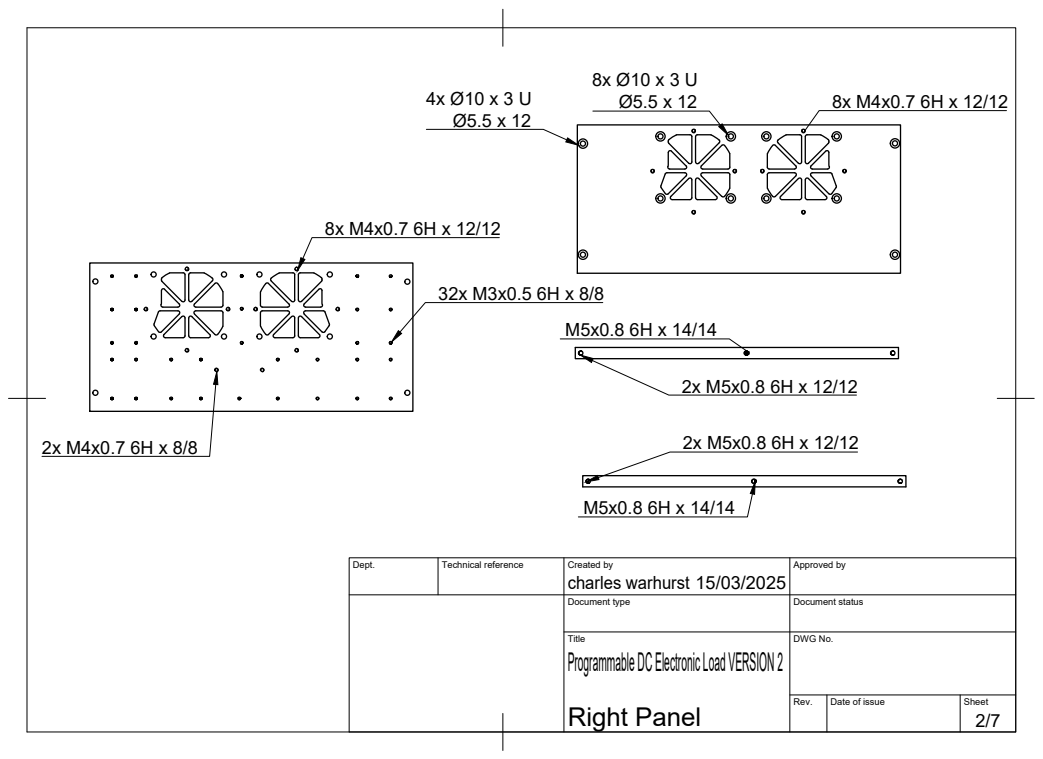
[picture p107: page 2]

Dept. | Technical reference | Created by charles warhurst 15/03/2025 | Approved by

Document type | Document status

Title Programmable DC Electronic Load VERSION 2 Right Panel | DWG No.

Rev. | Date of issue | Sheet

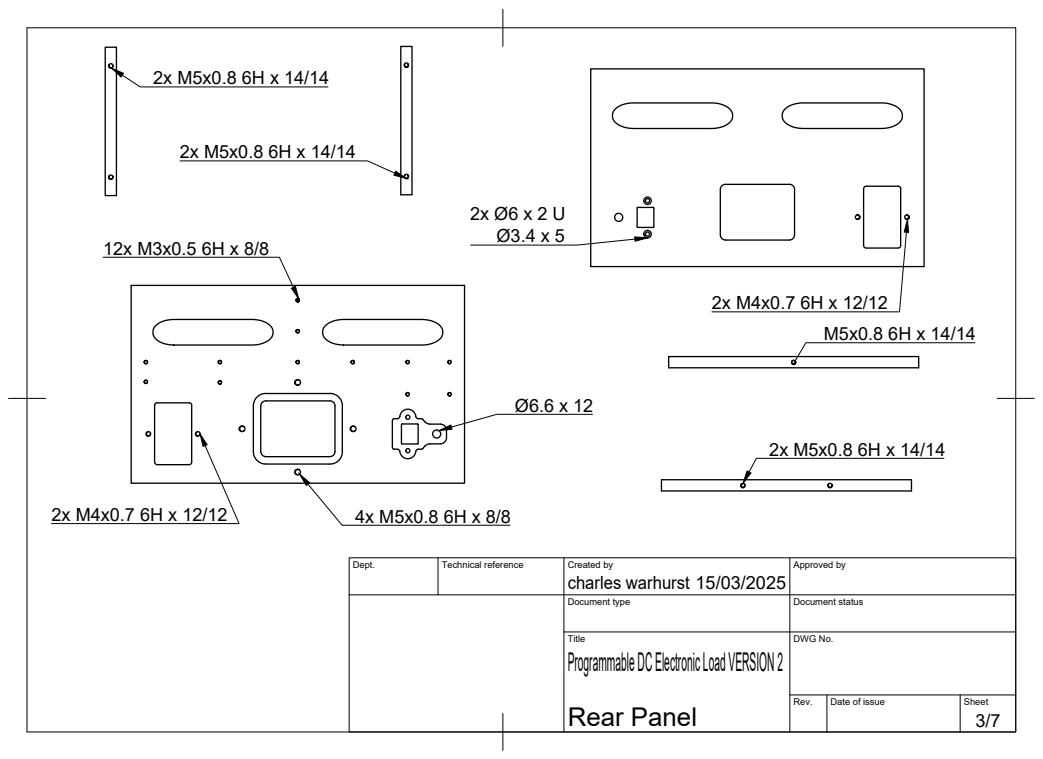
[picture p108: page 3]

Dept. | Technical reference | Created by charles warhurst 15/03/2025 | Approved by

Document type | Document status

Title Programmable DC Electronic Load VERSION 2 Rear Panel | DWG No.

Rev. | Date of issue | Sheet

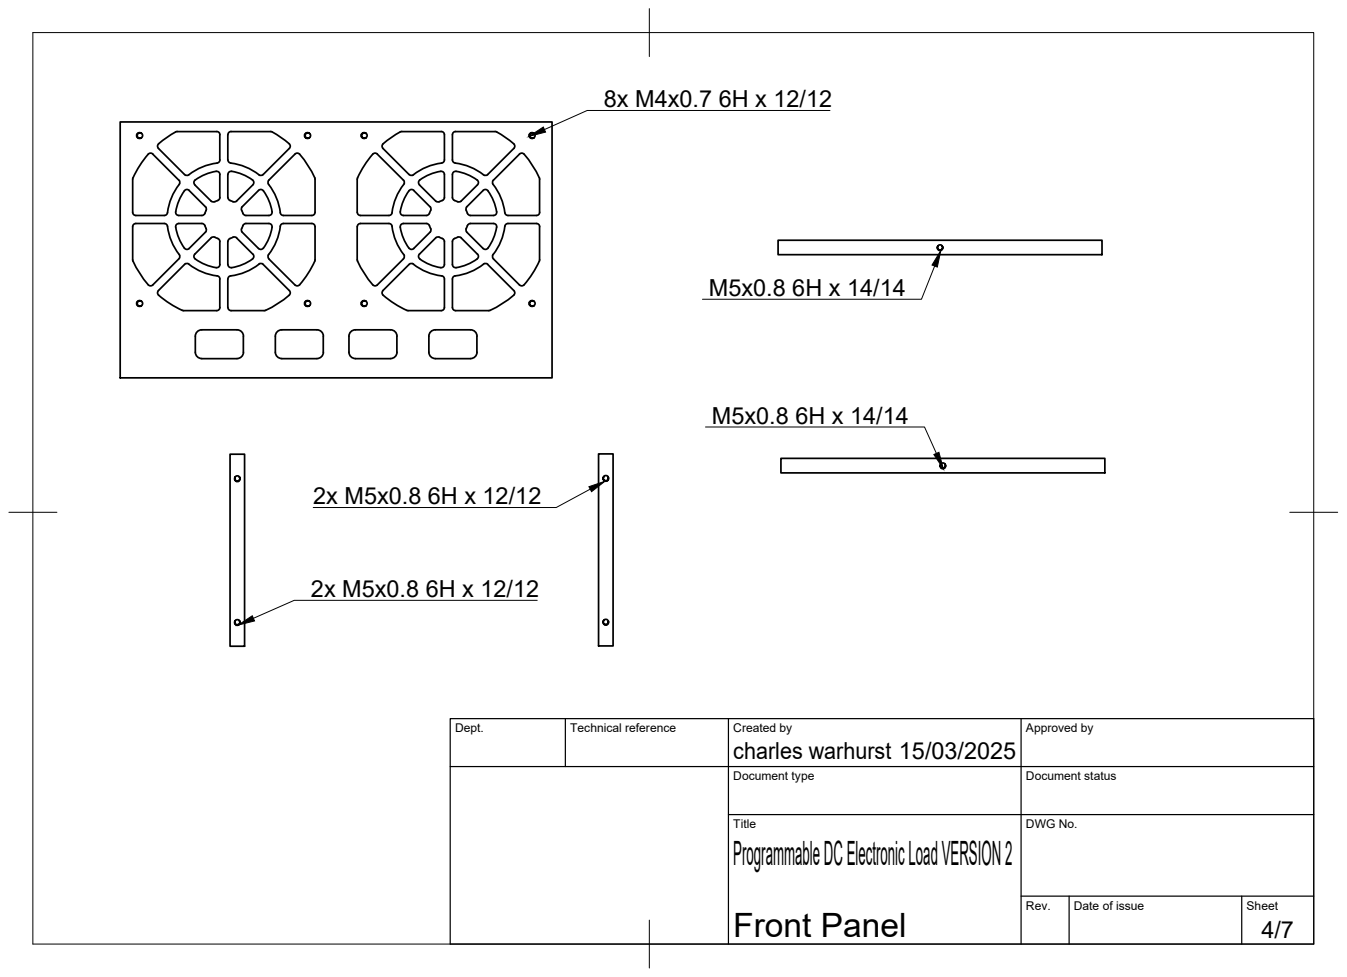
[picture p109: page 4]

Dept. | Technical reference | Created by charles warhurst 15/03/2025 | Approved by

Document type | Document status

Title Programmable DC Electronic Load VERSION 2 Front Panel | DWG No.

Rev. | Date of issue | Sheet

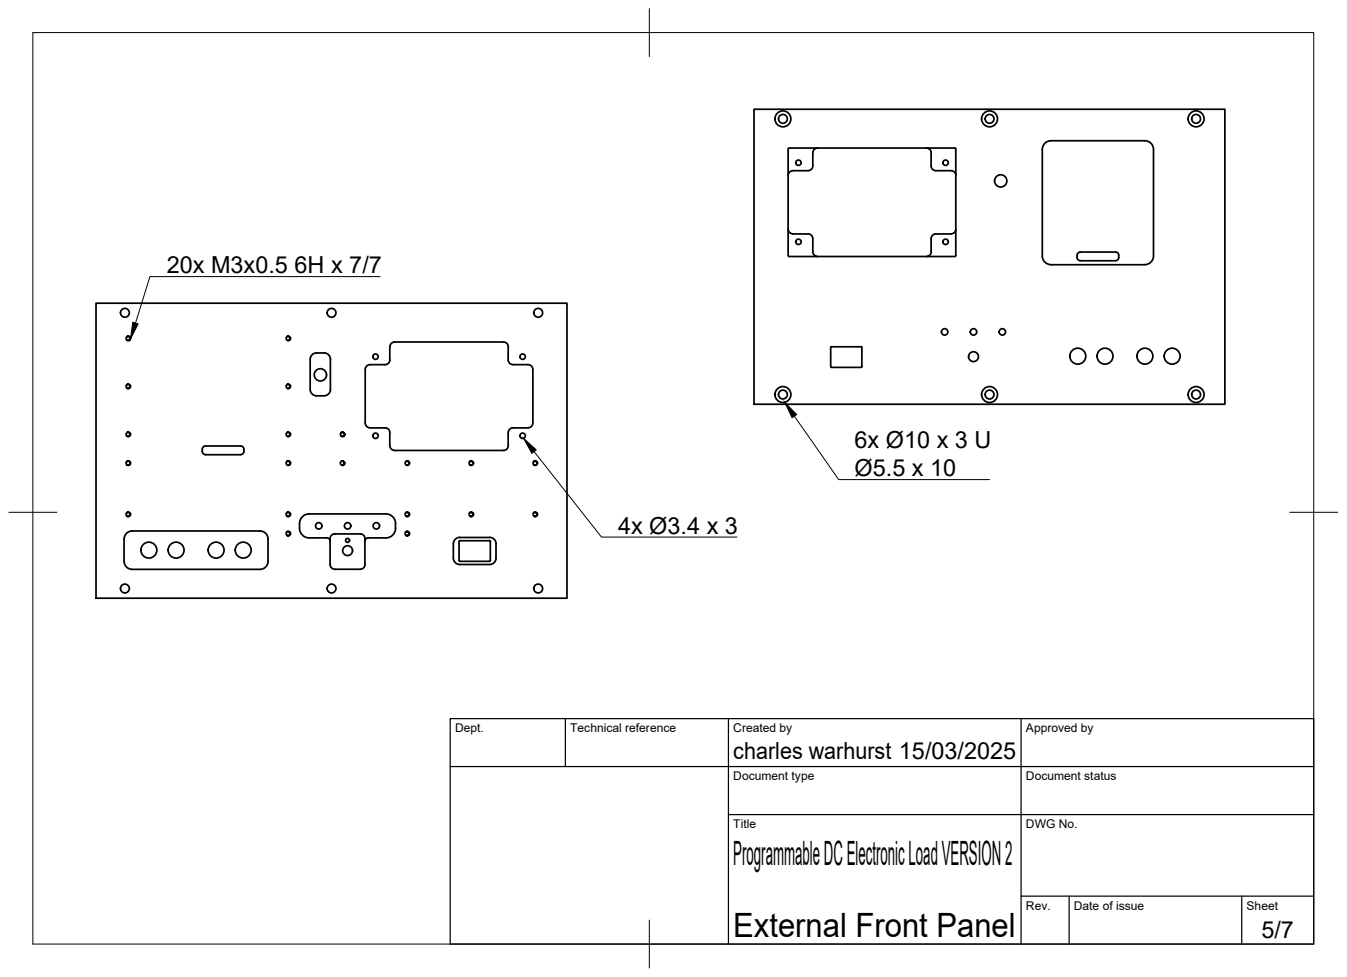
[picture p110: page 5]

Dept. | Technical reference | Created by charles warhurst 15/03/2025 | Approved by

Document type | Document status

Title Programmable DC Electronic Load VERSION 2 External Front Panel | DWG No.

Rev. | Date of issue | Sheet

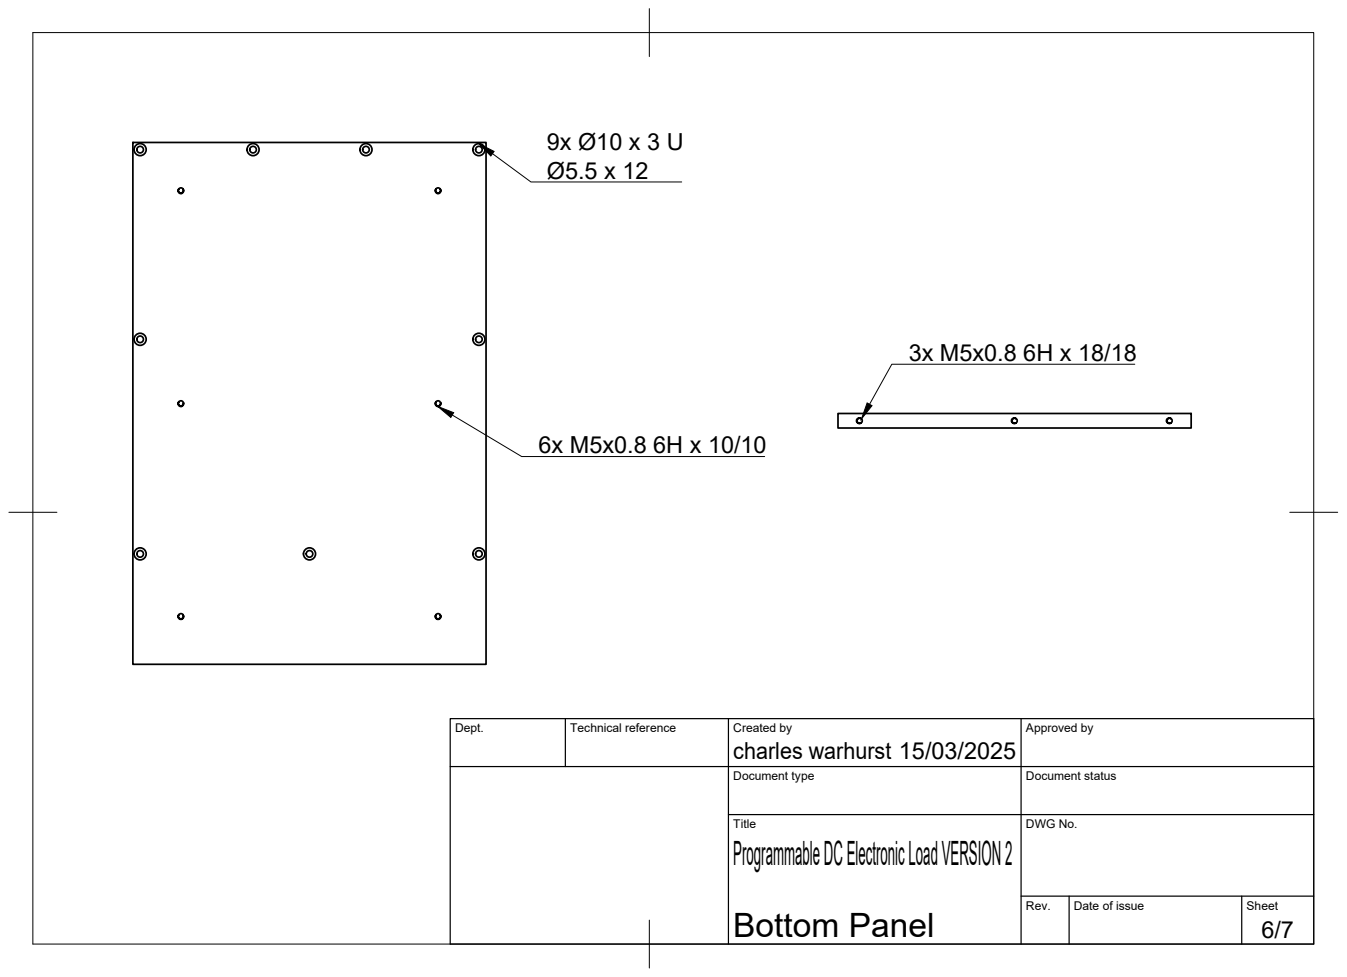
[picture p111: page 6]

Dept. | Technical reference | Created by charles warhurst 15/03/2025 | Approved by

Document type | Document status

Title Programmable DC Electronic Load VERSION 2 Bottom Panel | DWG No.

Rev. | Date of issue | Sheet

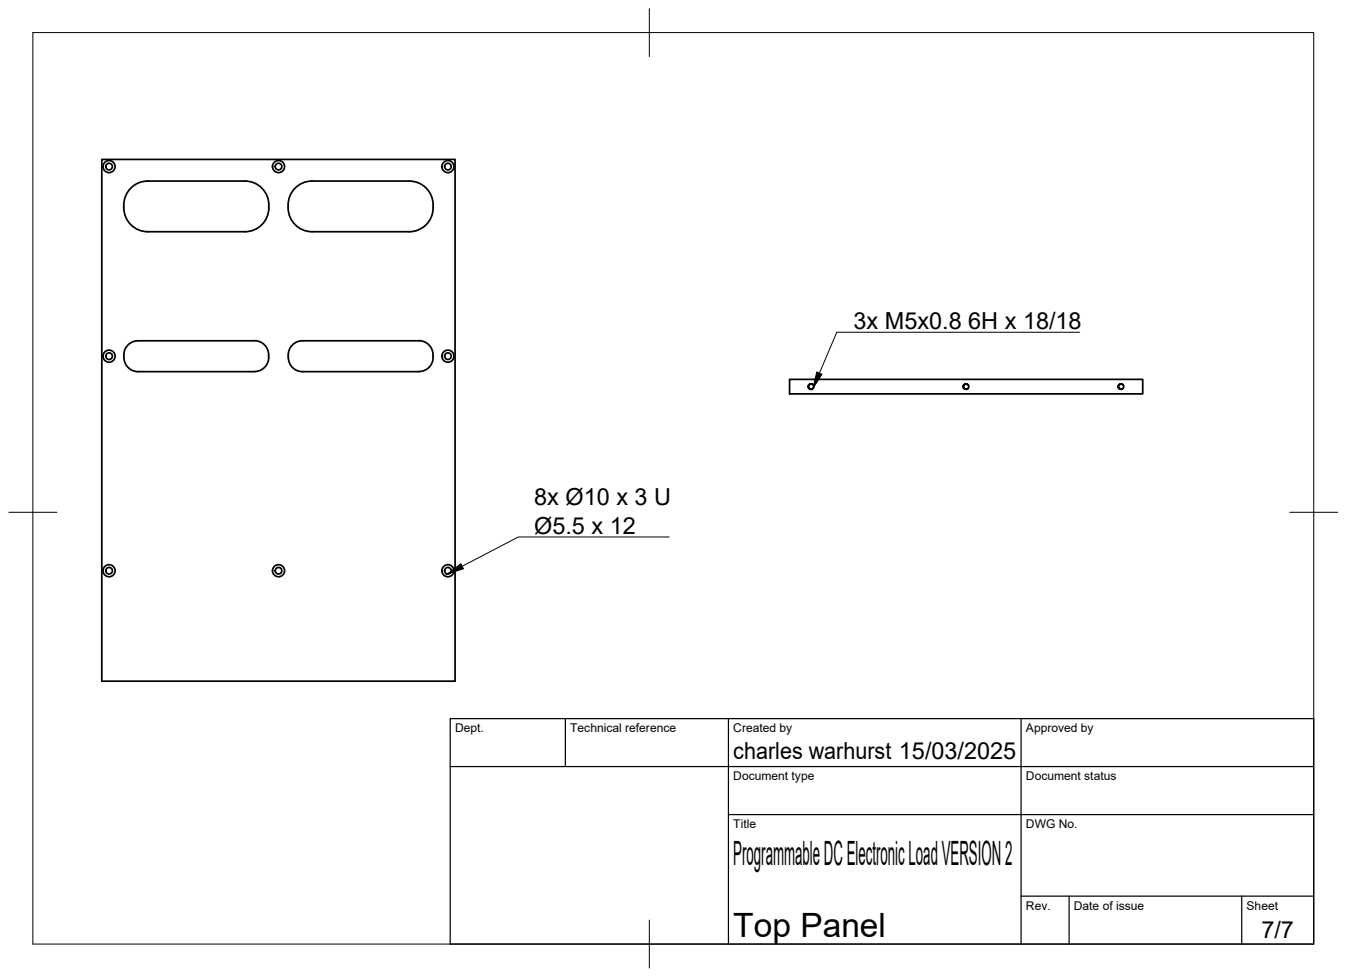
[picture p112: page 7]

Dept. | Technical reference | Created by charles warhurst 15/03/2025 | Approved by

Document type | Document status

Title Programmable DC Electronic Load VERSION 2 Top Panel | DWG No.

Rev. | Date of issue | Sheet
