CharlieW112/Programmable-Electronic-Load/LTSpice/Test Setups/MJ15024 Tester/MJ15024_Tester.asc

R1: res; 220
R2: res; 0.02
R4: res; 220k
R5: res; 5.1k
R6: res; 5.1k
R7: res; 220k
U1: OPAx197
U2: tip120
U3: OPAx197
V1: voltage; ""
V5: voltage; 5
V6: voltage; 8
V7: voltage; 8
Named nets: 0, +5V, +8V, -8V
.lib "Z:\\Projects\\Programmable_Electronic_Load\\LTSpice\\Spice Libraries\\OPAx197.LIB"
.lib "Z:\\Projects\\Programmable_Electronic_Load\\LTSpice\\Spice Libraries\\TIP120.LIB"
.lib "Z:\\Projects\\Programmable_Electronic_Load\\LTSpice\\Spice Libraries\\LM358.lib"
.dc V1 0.01 3.3 0.04
VCCS
Power Nets
