CharlieW112/Programmable-Electronic-Load/(list of files, drawings)

Other design files:
Proteus Files/Test Setups/NPN Transistor Tester/NPN Transistor Tester.pdsprj
Proteus Files/Test Setups/NPN Transistor Tester/Project Backups/New Project [20250111, 08-00-50].pdsprj
Proteus Files/Test Setups/NPN Transistor Tester/Project Backups/NPN Transistor Tester [20250111, 08-41-41].pdsprj
Proteus Files/Test Setups/NPN Transistor Tester/Project Backups/NPN Transistor Tester [20250111, 11-30-00].pdsprj
Proteus Files/Test Setups/VCCS 4A/Project Backups/VCCCS 4A [20250112, 07-43-47].pdsprj
Proteus Files/Test Setups/VCCS 4A/Project Backups/VCCCS 4A [20250112, 08-42-53].pdsprj
Proteus Files/Test Setups/VCCS 4A/VCCCS 4A.pdsprj
Proteus Files/V1/DIY DC Electronic Load.pdsprj
Proteus Files/V1/Project Backups/DIY DC Electronic Load [20240917, 04-49-37].pdsprj
Proteus Files/V1/Project Backups/DIY DC Electronic Load [20240922, 19-15-07].pdsprj
Proteus Files/V1/Project Backups/DIY DC Electronic Load [20240922, 19-15-26].pdsprj
Proteus Files/V1/Project Backups/DIY DC Electronic Load [20240928, 04-08-39].pdsprj
Proteus Files/V2.1/Programmable Electronic Load.pdsprj
Proteus Files/V2.1/Project Backups/Programmable Electronic Load [20240930, 18-35-13].pdsprj
Proteus Files/V2.1/Project Backups/Programmable Electronic Load [20241001, 02-20-32].pdsprj
Proteus Files/V2/Programmable Electronic Load.pdsprj
Proteus Files/V2/Project Backups/Programmable Electronic Load [20240916, 02-54-40].pdsprj
Proteus Files/V2/Project Backups/Programmable Electronic Load [20240916, 02-54-41].pdsprj
Proteus Files/V2/Project Backups/Programmable Electronic Load [20240916, 02-54-42].pdsprj
Proteus Files/V2/Project Backups/Programmable Electronic Load [20240916, 03-05-52].pdsprj
Proteus Files/V2/Project Backups/Programmable Electronic Load [20240917, 04-46-38].pdsprj
Proteus Files/V2/Project Backups/Programmable Electronic Load [20240918, 03-51-45].pdsprj
Proteus Files/V2/Project Backups/Programmable Electronic Load [20240921, 03-37-44].pdsprj
Proteus Files/V2/Project Backups/Programmable Electronic Load [20240921, 17-17-00].pdsprj
Proteus Files/V2/Project Backups/Programmable Electronic Load [20240922, 20-10-29].pdsprj
