CharlieW112/Programmable-Electronic-Load/KiCad/V1/Analogue Board/Analogue Board/Analogue Board.kicad_pcb

## KiCad design KiCad/V1/Analogue Board/Analogue Board/Analogue Board.kicad_pcb (2025-04-07)

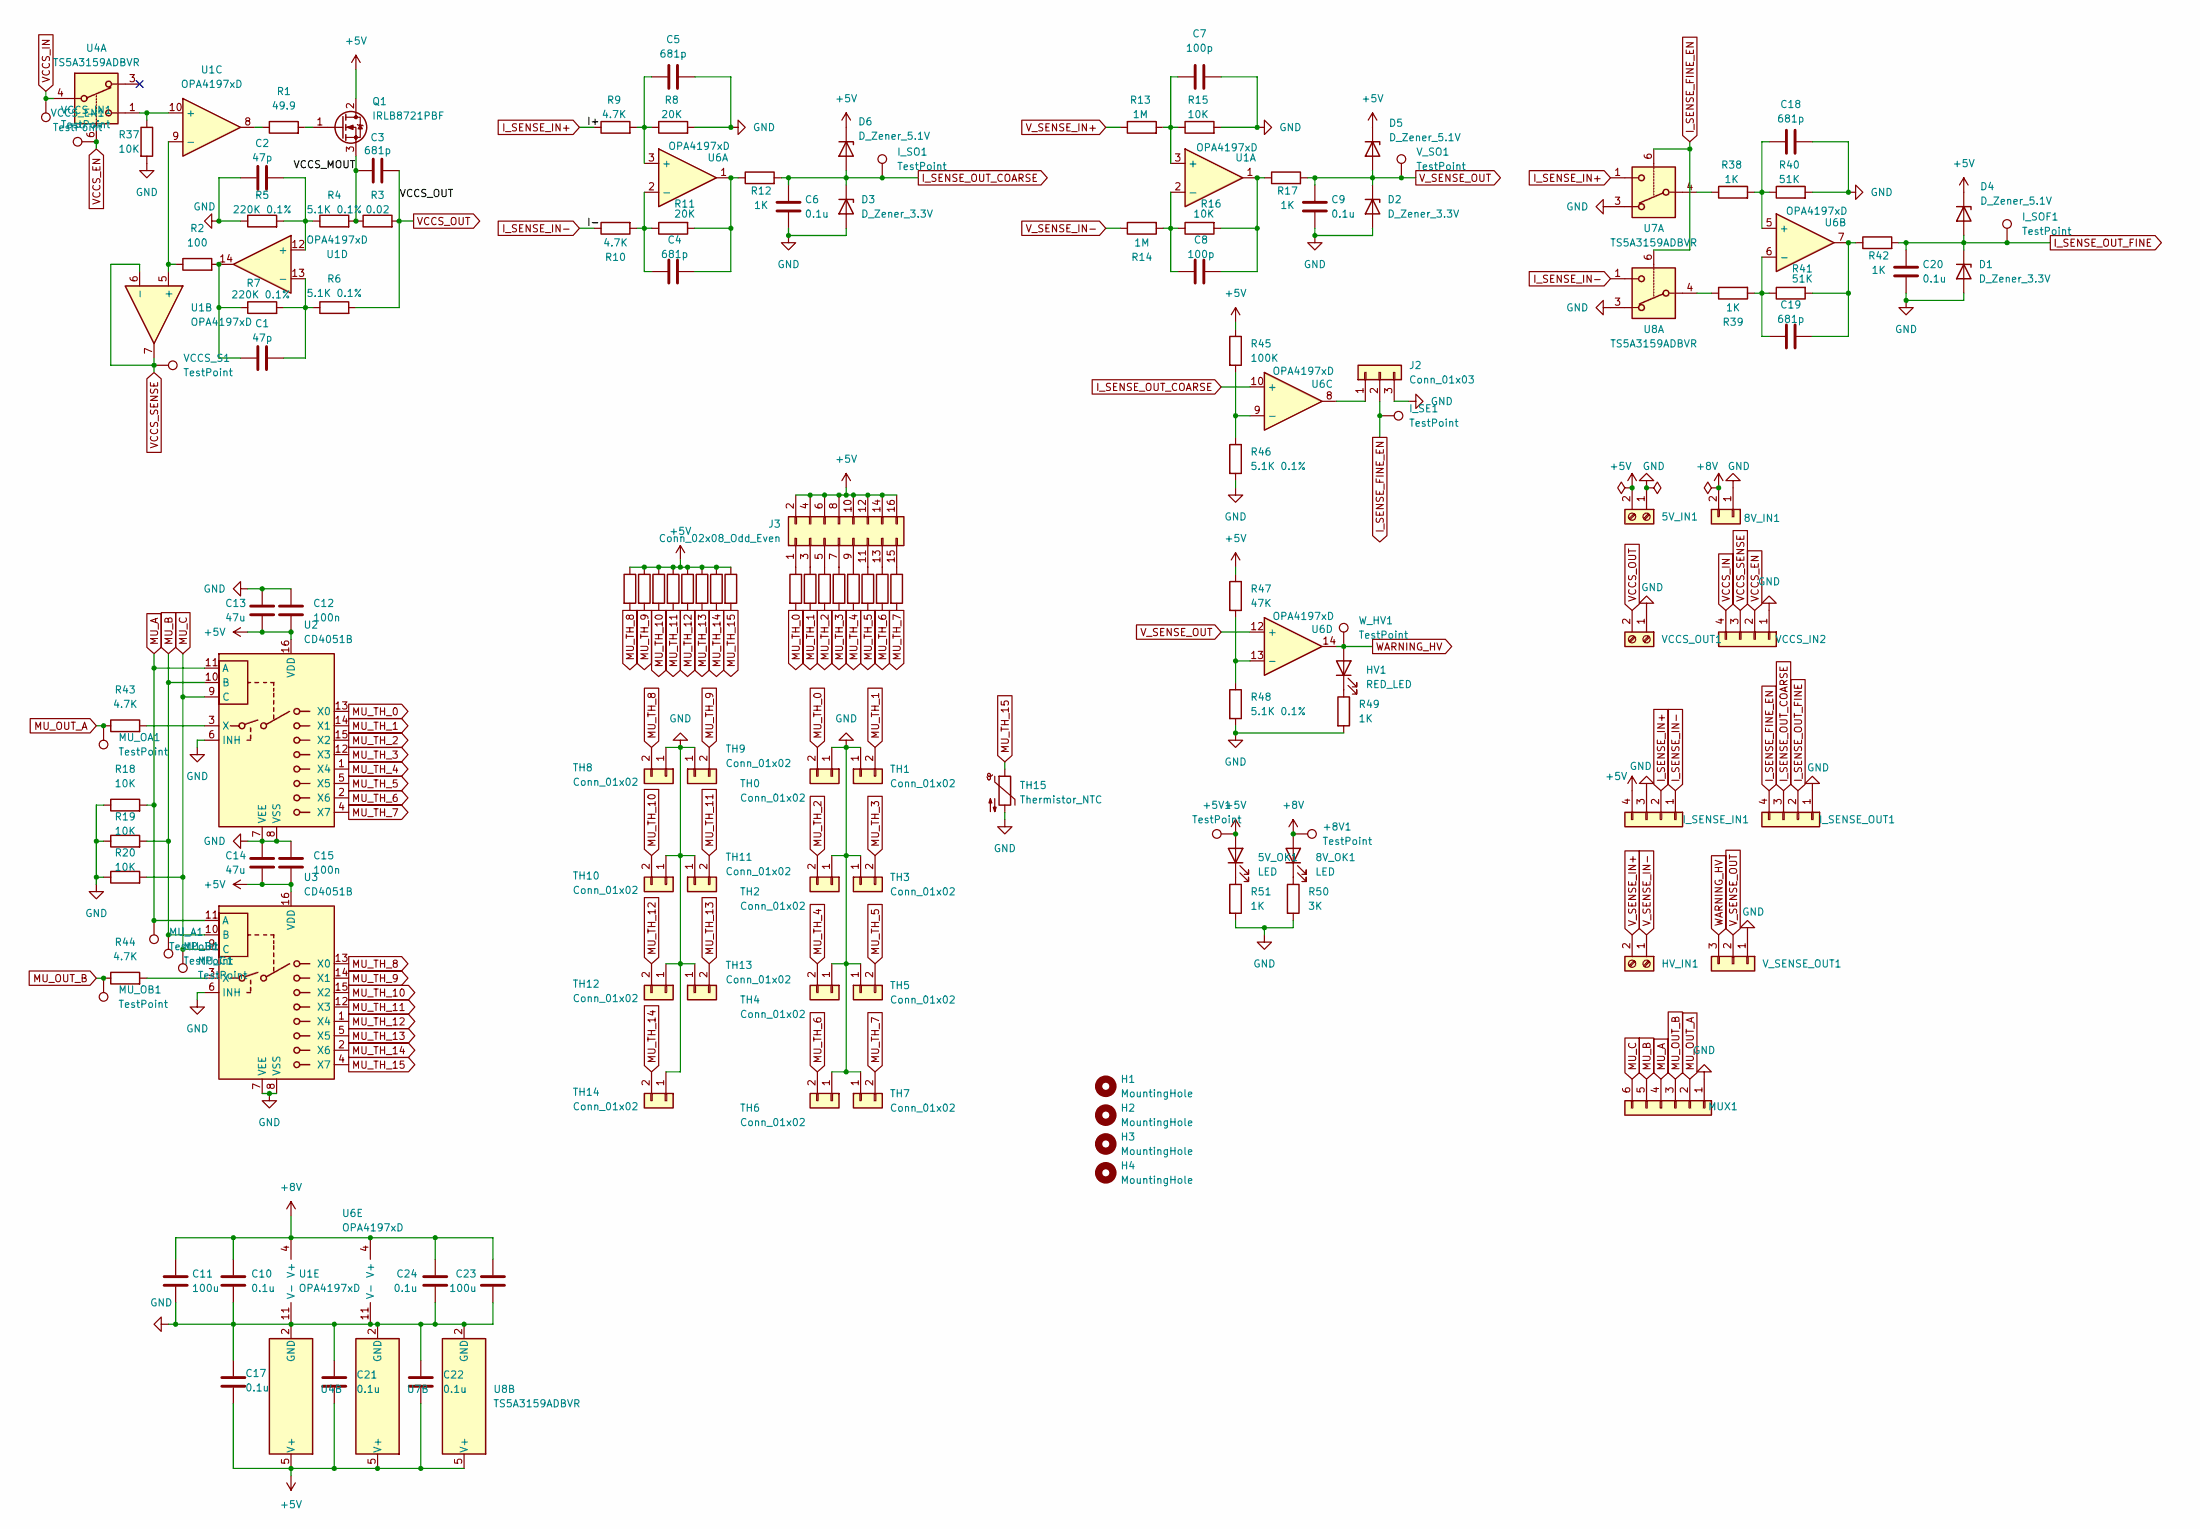
[picture p114: schematic Analogue Board.kicad_sch]

Parts:
5V_IN1: Screw_Terminal_01x02; TerminalBlock_bornier-2_P5.08mm
5V_OK1, 8V_OK1: LED; D_0603_1608Metric_Pad1.05x0.95mm_HandSolder
8V_IN1: Conn_01x02; JST_XH_B2B-XH-A_1x02_P2.50mm_Vertical
+5V1, +8V1: TestPoint; TestPoint_Pad_1.5x1.5mm
C1, C2: 47p; C_0201_0603Metric_Pad0.64x0.40mm_HandSolder
C3, C4, C5, C18, C19: 681p; C_0201_0603Metric_Pad0.64x0.40mm_HandSolder
C6, C9, C10, C17, C20, C21, C22, C24: 0.1u; C_0603_1608Metric_Pad1.08x0.95mm_HandSolder
C7, C8: 100p; C_0402_1005Metric_Pad0.74x0.62mm_HandSolder
C11, C23: 100u; C_Radial_D6.3mm_H11.0mm_P2.50mm
C12, C15: 100n; C_0603_1608Metric_Pad1.08x0.95mm_HandSolder
C13, C14: 47u; C_Radial_D6.3mm_H11.0mm_P2.50mm
D1, D2, D3: D_Zener_3.3V; D_SOD-123
D4, D5, D6: D_Zener_5.1V; D_SOD-123
H1, H2, H3, H4: MountingHole; MountingHole_3.2mm_M3
HV1: RED_LED; D_0603_1608Metric_Pad1.05x0.95mm_HandSolder
HV_IN1: Screw_Terminal_01x02; TerminalBlock_bornier-2_P5.08mm
I_SE1: TestPoint; TestPoint_Pad_1.5x1.5mm
I_SENSE_IN1: Conn_01x04; JST_XH_B4B-XH-A_1x04_P2.50mm_Vertical
I_SENSE_OUT1: Conn_01x04; JST_XH_B4B-XH-A_1x04_P2.50mm_Vertical
I_SO1: TestPoint; TestPoint_Pad_1.5x1.5mm
I_SOF1: TestPoint; TestPoint_Pad_1.5x1.5mm
J2: Conn_01x03; PinHeader_1x03_P2.54mm_Vertical
J3: Conn_02x08_Odd_Even; PinHeader_2x08_P2.54mm_Vertical
MUX1: Conn_01x06; JST_XH_B6B-XH-A_1x06_P2.50mm_Vertical
MU_A1: TestPoint; TestPoint_Pad_1.5x1.5mm
MU_B1: TestPoint; TestPoint_Pad_1.5x1.5mm
MU_C1: TestPoint; TestPoint_Pad_1.5x1.5mm
MU_OA1: TestPoint; TestPoint_Pad_1.5x1.5mm
MU_OB1: TestPoint; TestPoint_Pad_1.5x1.5mm
Q1: IRLB8721PBF; TO-220-3_Vertical
R1: 49.9; R_0402_1005Metric_Pad0.72x0.64mm_HandSolder
R2: 100; R_0603_1608Metric_Pad0.98x0.95mm_HandSolder
R3: 0.02; R_2010_5025Metric_Pad1.40x2.65mm_HandSolder
R4, R6, R46, R48: 5.1K 0.1%; R_0603_1608Metric_Pad0.98x0.95mm_HandSolder
R5, R7: 220K 0.1%; R_0805_2012Metric_Pad1.20x1.40mm_HandSolder
R8, R11: 20K; R_0402_1005Metric_Pad0.72x0.64mm_HandSolder
R9, R10, R43, R44: 4.7K; R_0603_1608Metric_Pad0.98x0.95mm_HandSolder
R12, R17, R38, R39, R42, R49, R51: 1K; R_0603_1608Metric_Pad0.98x0.95mm_HandSolder
R13, R14: 1M; R_Axial_DIN0207_L6.3mm_D2.5mm_P7.62mm_Horizontal
R15, R16, R18, R19, R20, R37: 10K; R_0603_1608Metric_Pad0.98x0.95mm_HandSolder
R21, R22, R23, R24, R25, R26, R27, R28, R29, R30, R31, R32, R33, R34, R35, R36: 10K 0.5%; R_0805_2012Metric_Pad1.20x1.40mm_HandSolder
R40, R41: 51K; R_0603_1608Metric_Pad0.98x0.95mm_HandSolder
R45: 100K; R_0402_1005Metric_Pad0.72x0.64mm_HandSolder
R47: 47K; R_0603_1608Metric_Pad0.98x0.95mm_HandSolder
R50: 3K; R_0603_1608Metric_Pad0.98x0.95mm_HandSolder
TH0, TH1, TH2, TH3, TH4, TH5, TH6, TH7, TH8, TH9, TH10, TH11, TH12, TH13, TH14: Conn_01x02; JST_XH_B2B-XH-A_1x02_P2.50mm_Vertical
TH15: Thermistor_NTC; R_0805_2012Metric_Pad1.20x1.40mm_HandSolder
U1, U6: OPA4197xD; SOIC-14_3.9x8.7mm_P1.27mm
U2, U3: CD4051B; DIP-16_W7.62mm
U4, U7, U8: TS5A3159ADBVR; SOT-23-6
VCCS_EN1: TestPoint; TestPoint_Pad_1.5x1.5mm
VCCS_IN1: TestPoint; TestPoint_Pad_1.5x1.5mm
VCCS_IN2: Conn_01x04; JST_XH_B4B-XH-A_1x04_P2.50mm_Vertical
VCCS_OUT1: Screw_Terminal_01x02; TerminalBlock_bornier-2_P5.08mm
VCCS_S1: TestPoint; TestPoint_Pad_1.5x1.5mm
V_SENSE_OUT1: Conn_01x03; JST_XH_B3B-XH-A_1x03_P2.50mm_Vertical
V_SO1: TestPoint; TestPoint_Pad_1.5x1.5mm
W_HV1: TestPoint; TestPoint_Pad_1.5x1.5mm

Connections:
+5V: 5V_IN1.2, 5V_OK1.2 (A), +5V1.1, C12.2, C13.2, C14.2, C15.2, C17.2, C21.2, C22.2, D4.1 (K), D5.1 (K), D6.1 (K), I_SENSE_IN1.4, J3.2, J3.4, J3.6, J3.8, J3.10, J3.12, J3.14, J3.16, Q1.2 (D), R29.1, R30.1, R31.1, R32.1, R33.1, R34.1, R35.1, R36.1, R45.1, R47.1, U2.16 (VDD), U3.16 (VDD), U4.5 (V+), U7.5 (V+), U8.5 (V+)
+8V: 8V_IN1.2, 8V_OK1.2 (A), +8V1.1, C10.1, C11.1, C23.1, C24.1, U1.4 (V+), U6.4 (V+)
/VCCS_MOUT: C3.1, Q1.3 (S), R3.1, R4.2
GND: 5V_IN1.1, 8V_IN1.1, C2.1, C5.2, C6.2, C7.2, C9.2, C10.2, C11.2, C12.1, C13.1, C14.1, C15.1, C17.1, C18.2, C20.2, C21.1, C22.1, C23.2, C24.2, D1.2 (A), D2.2 (A), D3.2 (A), I_SENSE_IN1.3, I_SENSE_OUT1.1, J2.3, MUX1.1, R5.1, R8.2, R15.2, R18.1, R19.1, R20.1, R37.2, R40.2, R46.2, R48.2, R49.2, R50.2, R51.2, TH0.1, TH1.1, TH2.1, TH3.1, TH4.1, TH5.1, TH6.1, TH7.1, TH8.1, TH9.1, TH10.1, TH11.1, TH12.1, TH13.1, TH14.1, TH15.2, U1.11 (V-), U2.6 (INH), U2.7 (VEE), U2.8 (VSS), U3.6 (INH), U3.7 (VEE), U3.8 (VSS), U4.2 (GND), U6.11 (V-), U7.2 (GND), U7.3, U8.2 (GND), U8.3, VCCS_IN2.1, VCCS_OUT1.1, V_SENSE_OUT1.1
I_SENSE_FINE_EN: I_SE1.1, I_SENSE_OUT1.4, J2.2, U7.6, U8.6
I_SENSE_IN+: I_SENSE_IN1.2, R9.1, U7.1
I_SENSE_IN-: I_SENSE_IN1.1, R10.1, U8.1
I_SENSE_OUT_COARSE: C6.1, D3.1 (K), D6.2 (A), I_SENSE_OUT1.3, I_SO1.1, R12.2, U6.10 (+)
I_SENSE_OUT_FINE: C20.1, D1.1 (K), D4.2 (A), I_SENSE_OUT1.2, I_SOF1.1, R42.2
MU_A: MUX1.4, MU_A1.1, R18.2, U2.11 (A), U3.11 (A)
MU_B: MUX1.5, MU_B1.1, R19.2, U2.10 (B), U3.10 (B)
MU_C: MUX1.6, MU_C1.1, R20.2, U2.9 (C), U3.9 (C)
MU_OUT_A: MUX1.2, MU_OA1.1, R43.1
MU_OUT_B: MUX1.3, MU_OB1.1, R44.1
MU_TH_0: R21.2, TH0.2, U2.13 (X0)
MU_TH_1: R22.2, TH1.2, U2.14 (X1)
MU_TH_2: R23.2, TH2.2, U2.15 (X2)
MU_TH_3: R24.2, TH3.2, U2.12 (X3)
MU_TH_4: R25.2, TH4.2, U2.1 (X4)
MU_TH_5: R26.2, TH5.2, U2.5 (X5)
MU_TH_6: R27.2, TH6.2, U2.2 (X6)
MU_TH_7: R28.2, TH7.2, U2.4 (X7)
MU_TH_8: R29.2, TH8.2, U3.13 (X0)
MU_TH_9: R30.2, TH9.2, U3.14 (X1)
MU_TH_10: R31.2, TH10.2, U3.15 (X2)
MU_TH_11: R32.2, TH11.2, U3.12 (X3)
MU_TH_12: R33.2, TH12.2, U3.1 (X4)
MU_TH_13: R34.2, TH13.2, U3.5 (X5)
MU_TH_14: R35.2, TH14.2, U3.2 (X6)
MU_TH_15: R36.2, TH15.1, U3.4 (X7)
unnamed: 5V_OK1.1 (K), R51.1
unnamed: 8V_OK1.1 (K), R50.1
unnamed: C1.1, R2.2, R7.1, U1.14
unnamed: C4.2, R11.2, R12.1, U6.1
unnamed: C8.2, R16.2, R17.1, U1.1
unnamed: C19.2, R41.2, R42.1, U6.7
unnamed: HV1.1 (K), R49.1
unnamed: J2.1, U6.8
unnamed: J3.1, R21.1
unnamed: J3.3, R22.1
unnamed: J3.5, R23.1
unnamed: J3.7, R24.1
unnamed: J3.9, R25.1
unnamed: J3.11, R26.1
unnamed: J3.13, R27.1
unnamed: J3.15, R28.1
unnamed: Q1.1 (G), R1.2
unnamed: R1.1, U1.8
unnamed: R38.1, U7.4
unnamed: R39.1, U8.4
unnamed: C7.1, R13.2, R15.1, U1.3 (+)
unnamed: C8.1, R14.2, R16.1, U1.2 (-)
unnamed: R2.1, U1.5 (+), U1.9 (-)
unnamed: R37.1, U1.10 (+), U4.1
unnamed: C2.2, R4.1, R5.2, U1.12 (+)
unnamed: C1.2, R6.1, R7.2, U1.13 (-)
unnamed: R43.2, U2.3 (X)
unnamed: R44.2, U3.3 (X)
unnamed: C5.1, R8.1, R9.2, U6.3 (+)
unnamed: C4.1, R10.2, R11.1, U6.2 (-)
unnamed: C18.1, R38.2, R40.1, U6.5 (+)
unnamed: C19.1, R39.2, R41.1, U6.6 (-)
unnamed: R45.2, R46.1, U6.9 (-)
unnamed: R47.2, R48.1, U6.13 (-)
VCCS_EN: U4.6, VCCS_EN1.1, VCCS_IN2.2
VCCS_IN: U4.4, VCCS_IN1.1, VCCS_IN2.4
VCCS_OUT: C3.2, R3.2, R6.2, VCCS_OUT1.2
VCCS_SENSE: U1.6 (-), U1.7, VCCS_IN2.3, VCCS_S1.1
V_SENSE_IN+: HV_IN1.2, R13.1
V_SENSE_IN-: HV_IN1.1, R14.1
V_SENSE_OUT: C9.1, D2.1 (K), D5.2 (A), R17.2, U6.12 (+), V_SENSE_OUT1.2, V_SO1.1
WARNING_HV: HV1.2 (A), U6.14, V_SENSE_OUT1.3, W_HV1.1

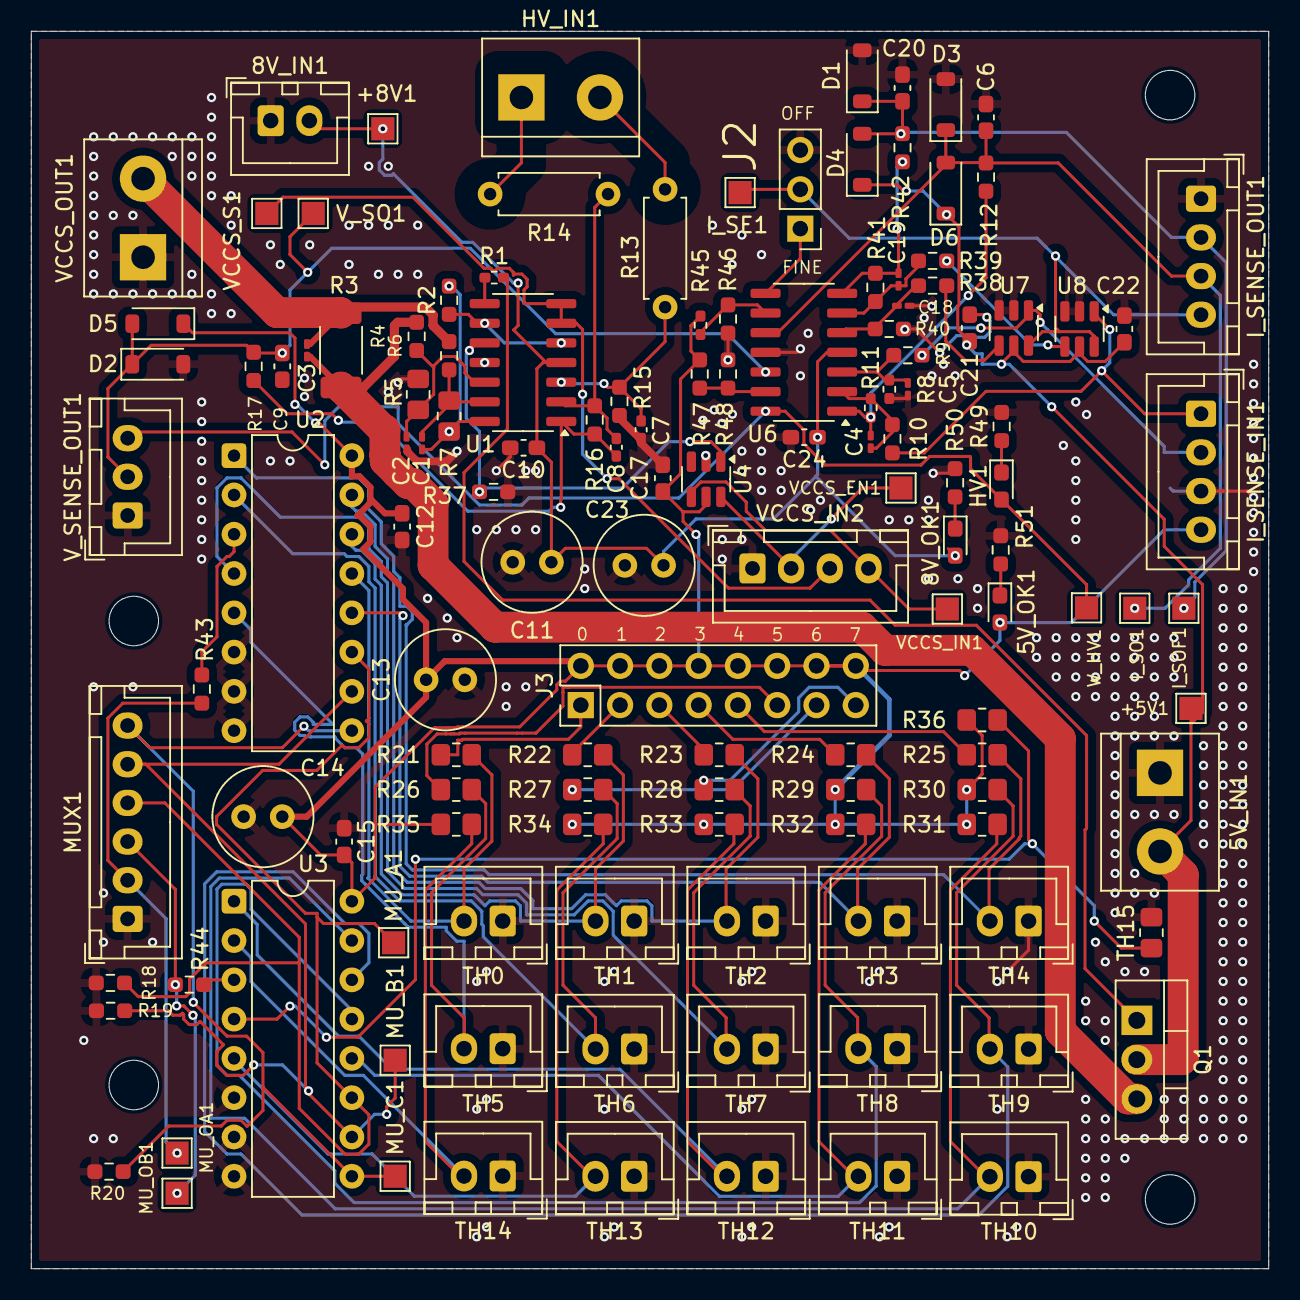
[picture p115: board Analogue Board.kicad_pcb from above]

Board: 2 copper layers, 80.0 x 80.0 mm, 137 parts (0 on the bottom side), 72 nets.
