CharlieW112/Programmable-Electronic-Load/KiCad/V1/Power Regulation Board/Power Regulation/Power Regulation.kicad_pcb

## KiCad design KiCad/V1/Power Regulation Board/Power Regulation/Power Regulation.kicad_pcb (2025-04-07)

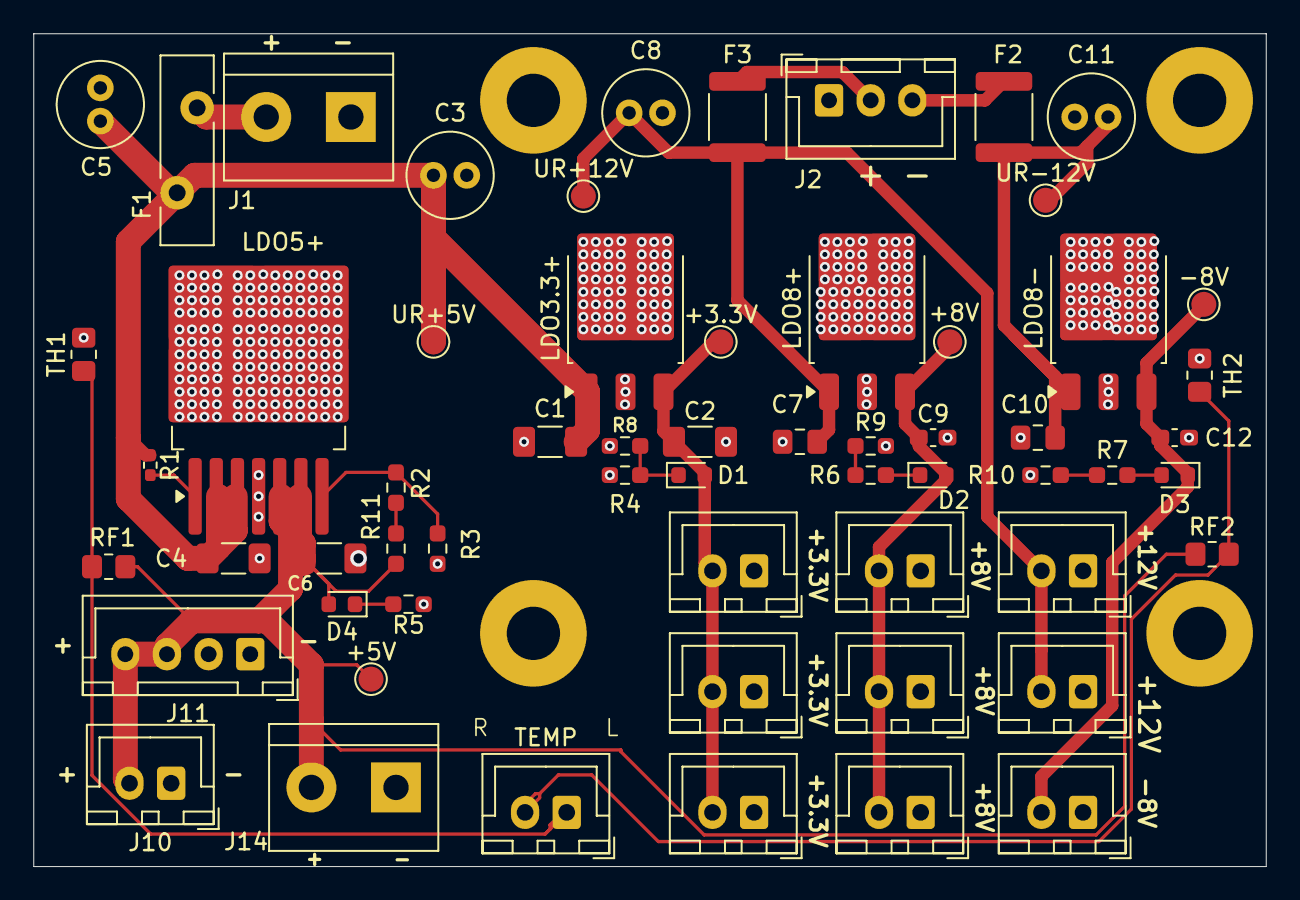
[picture p116: board Power Regulation.kicad_pcb from above]

Board: 2 copper layers, 74.0 x 50.0 mm, 64 parts (0 on the bottom side), 22 nets.

Parts:
+3.3V, +5V, +8V: TestPoint; TestPoint_Pad_D1.5mm
-8V: TestPoint; TestPoint_Pad_D1.5mm
C1, C2, C4, C6: 10u; C_1206_3216Metric_Pad1.33x1.80mm_HandSolder
C3, C5, C8, C11: 100u; C_Radial_D5.0mm_H11.0mm_P2.00mm
C7, C10: 1u; C_0805_2012Metric_Pad1.18x1.45mm_HandSolder
C9, C12: 0.1u; C_0603_1608Metric_Pad1.08x0.95mm_HandSolder
D1, D2, D3, D4: LED; LED_0603_1608Metric
F1: Polyfuse; Fuse_Bourns_MF-RHT550
F2, F3: Polyfuse_Small; Fuse_1812_4532Metric
H1, H2, H3, H4: MountingHole_Pad; MountingHole_3.2mm_M3_Pad
J1, J14: Screw_Terminal_01x02; TerminalBlock_bornier-2_P5.08mm
J2: Conn_01x03; JST_XH_B3B-XH-A_1x03_P2.50mm_Vertical
J3, J4, J5, J6, J7, J8, J9, J10, J12, J13: Conn_01x02; JST_XH_B2B-XH-A_1x02_P2.50mm_Vertical
J11: Conn_01x04; JST_XH_B4B-XH-A_1x04_P2.50mm_Vertical
LDO3.3+, LDO8+, LDO8-: TO-252-3_TabPin2
LDO5+: TO-263-7_TabPin4
R1: 100K; R_0402_1005Metric_Pad0.72x0.64mm_HandSolder
R2, R11: 3K; R_0603_1608Metric_Pad0.98x0.95mm_HandSolder
R3: 680; R_0603_1608Metric_Pad0.98x0.95mm_HandSolder
R4, R5, R6, R7, R8: 1K; R_0603_1608Metric_Pad0.98x0.95mm_HandSolder
R9, R10: 470; R_0603_1608Metric_Pad0.98x0.95mm_HandSolder
RF1, RF2: 10K; R_0805_2012Metric_Pad1.20x1.40mm_HandSolder
TEMP: Conn_01x02; JST_XH_B2B-XH-A_1x02_P2.50mm_Vertical
TH1, TH2: Thermistor_NTC; R_0805_2012Metric_Pad1.20x1.40mm_HandSolder
UR+5V, UR+12V: TestPoint; TestPoint_Pad_D1.5mm
UR-12V: TestPoint; TestPoint_Pad_D1.5mm

Connections:
+3.3V: +3.3V.1, C2.1, D1.2 (A), J3.2, J4.2, J5.2, LDO3.3+.3 (OUT)
+5V: +5V.1, C6.1, D4.2 (A), J10.2, J11.3, J11.4, J14.2, LDO5+.5 (VOUT), LDO5+.6 (VOUT), R11.2, RF1.1, RF2.1
+8V: +8V.1, C9.1, D2.2 (A), J6.2, J7.2, J8.2, LDO8+.3 (OUT)
-8V: -8V.1, C12.1, D3.1 (K), J9.2, LDO8-.3 (OUT)
GND: C1.2, C2.2, C3.2, C4.2, C5.2, C6.2, C7.2, C8.2, C9.2, C10.2, C11.2, C12.2, H1.1, H2.1, H3.1, H4.1, J1.1, J2.1, J3.1, J4.1, J5.1, J6.1, J7.1, J8.1, J9.1, J10.1, J11.1, J11.2, J12.1, J13.1, J14.1, LDO3.3+.2 (GND), LDO5+.4 (GND), LDO8+.2 (GND), LDO8-.2 (GND), R3.1, R4.2, R5.2, R8.2, R9.2, R10.2, TH1.2, TH2.2
unnamed: D1.1 (K), R4.1, R8.1
unnamed: D4.1 (K), R5.1
unnamed: D2.1 (K), R6.1
unnamed: D3.2 (A), R7.1
unnamed: F1.1, J1.2
unnamed: F3.1, J2.2
unnamed: F2.1, J2.3
unnamed: LDO5+.7 (ADJ), R2.1, R3.2
unnamed: LDO5+.1 (EN), R1.2
unnamed: R6.2, R9.1
unnamed: R7.2, R10.1
unnamed: R2.2, R11.1
TEMP_1: RF1.2, TEMP.1, TH1.1
TEMP_2: RF2.2, TEMP.2, TH2.1
UR_+5V: C1.1, C3.1, C4.1, C5.1, F1.2, LDO3.3+.1 (IN), LDO5+.2 (VIN), LDO5+.3 (VIN), R1.1, UR+5V.1
UR_+12V: C7.1, C8.1, F3.2, J12.2, J13.2, LDO8+.1 (IN), UR+12V.1
UR_-12V: C10.1, C11.1, F2.2, LDO8-.1 (IN), UR-12V.1
