CharlieW112/Programmable-Electronic-Load/KiCad/V1/LED Board/LED_BOARD/LED_BOARD.kicad_pcb

## KiCad design KiCad/V1/LED Board/LED_BOARD/LED_BOARD.kicad_pcb (2025-04-07)

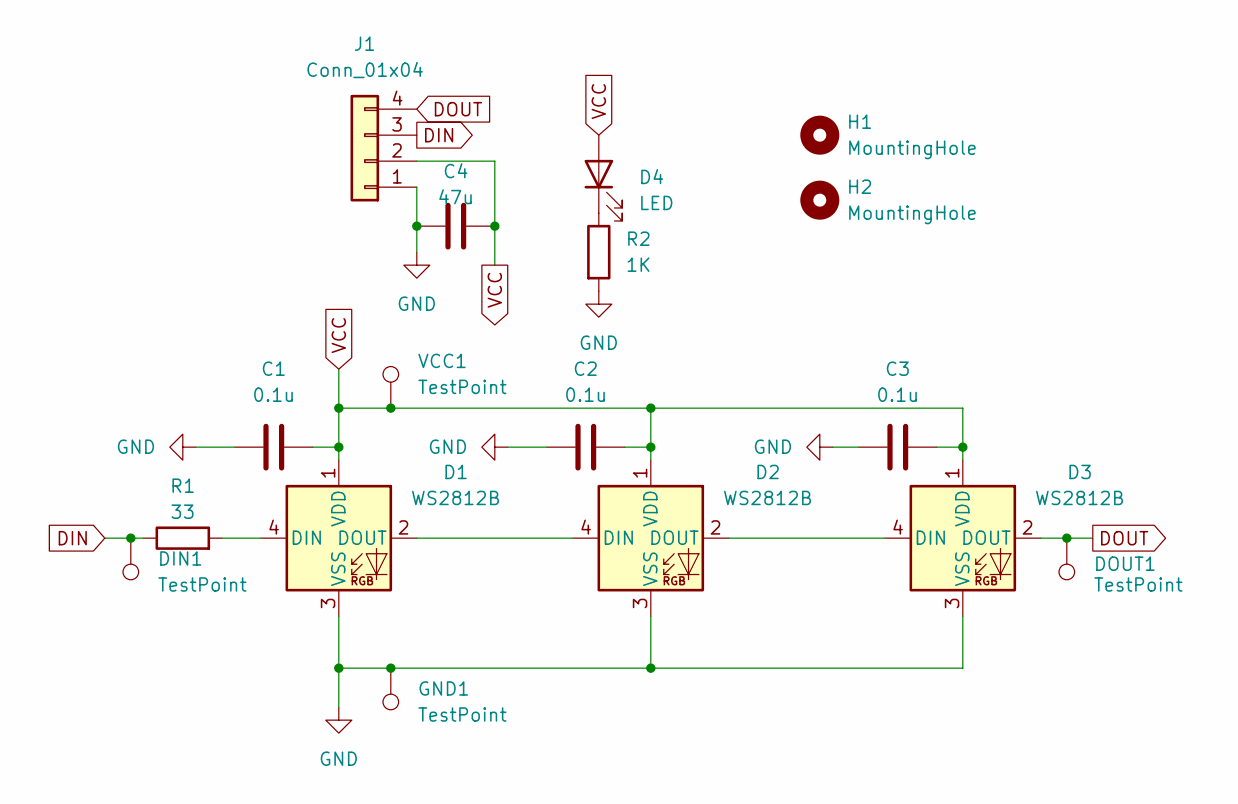
[picture p117: schematic LED_BOARD.kicad_sch]

Parts:
C1, C2, C3: 0.1u; C_0603_1608Metric_Pad1.08x0.95mm_HandSolder
C4: 47u; CP_Radial_D5.0mm_P2.00mm
D1, D2, D3: WS2812B; LED_WS2812B_PLCC4_5.0x5.0mm_P3.2mm
D4: LED; LED_0603_1608Metric_Pad1.05x0.95mm_HandSolder
DIN1: TestPoint; TestPoint_Pad_D1.5mm
DOUT1: TestPoint; TestPoint_Pad_D1.5mm
GND1: TestPoint; TestPoint_Pad_D1.5mm
H1, H2: MountingHole; MountingHole_3.2mm_M3
J1: Conn_01x04; PinSocket_1x04_P2.54mm_Vertical
R1: 33; R_0402_1005Metric_Pad0.72x0.64mm_HandSolder
R2: 1K; R_0603_1608Metric_Pad0.98x0.95mm_HandSolder
VCC1: TestPoint; TestPoint_Pad_D1.5mm

Connections:
DIN: DIN1.1, J1.3, R1.1
DOUT: D3.2 (DOUT), DOUT1.1, J1.4
GND: C1.1, C2.1, C3.1, C4.1, D1.3 (VSS), D2.3 (VSS), D3.3 (VSS), GND1.1, J1.1, R2.2
unnamed: D1.4 (DIN), R1.2
unnamed: D1.2 (DOUT), D2.4 (DIN)
unnamed: D2.2 (DOUT), D3.4 (DIN)
unnamed: D4.1 (K), R2.1
VCC: C1.2, C2.2, C3.2, C4.2, D1.1 (VDD), D2.1 (VDD), D3.1 (VDD), D4.2 (A), J1.2, VCC1.1

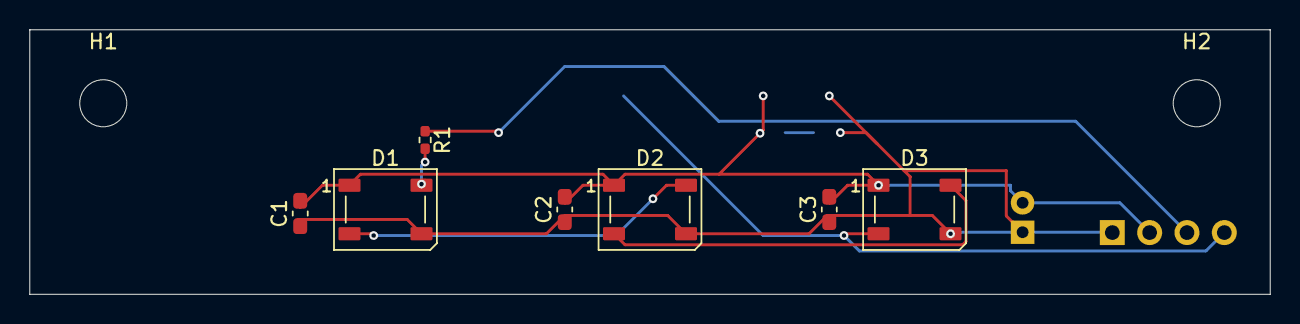
[picture p118: board LED_BOARD.kicad_pcb from above]

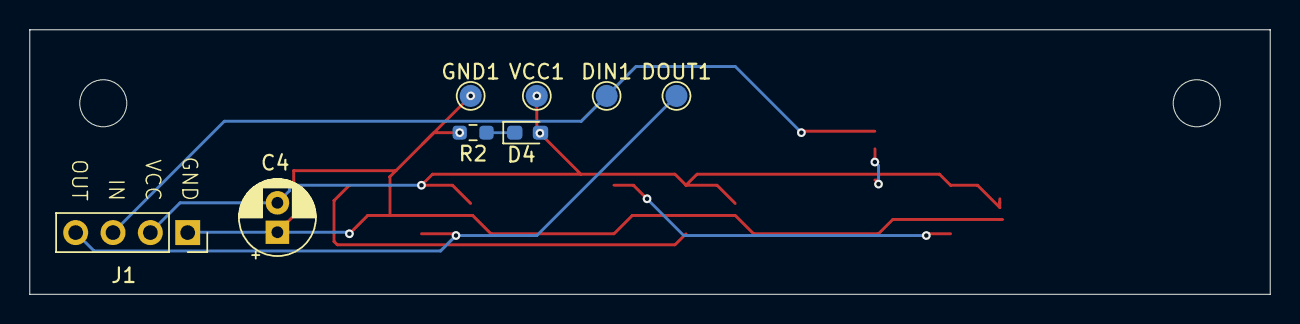
[picture p119: board LED_BOARD.kicad_pcb from below]

Board: 2 copper layers, 84.4 x 18.0 mm, 17 parts (8 on the bottom side), 8 nets.
