CharlieW112/Programmable-Electronic-Load/STM32/TouchGFX_Projects/MyApplication/Core/Inc/main.h

#define VSYNC_FREQ_Pin GPIO_PIN_2
#define VSYNC_FREQ_GPIO_Port GPIOE
#define RENDER_TIME_Pin GPIO_PIN_3
#define RENDER_TIME_GPIO_Port GPIOE
#define FRAME_RATE_Pin GPIO_PIN_4
#define FRAME_RATE_GPIO_Port GPIOE
#define MCU_ACTIVE_Pin GPIO_PIN_5
#define MCU_ACTIVE_GPIO_Port GPIOE
