CharlieW112/Programmable-Electronic-Load/(commit log)

2024-10-15 V2 CAD Proposed Changes
2024-10-31 CAD and Reports
    CAD V2 is mostly done. Lots of additional CAD files have been downloaded and added.
    Reports for the front panel and a CAD progress update have been made. A sample tracker has been created to track all sample requests and free products obtained.
    [80x80x25 9 blade fan.SLDASM, 80x80x25 fan blade.SLDPRT, 80x80x25 fan frame.SLDPRT, Banana jack (4mm female socket).f3d, Banana jack (4mm female socket).step, Body1.stl, CW4EL2-10A-T EMI v2.f3d, CW4EL2-10A-T EMI v2.iges]
2024-12-23 Front panel CAD & datasheets
    [Binding Post Insulator.stl, Display Bezel.stl, Pipe Straightener.stl]
2025-01-18 STM32CUBE Testing
    STM32CUBE "Hello World" completed
    STM32CUBE LCD SPI driver tested and implemented
    STM32CUBE TouchGFX tested and implemented - ready for custom TouchGFX application
    [NPN Transistor Tester [20250111, 08-41-41].pdsprj, NPN Transistor Tester [20250111, 11-30-00].pdsprj, NPN Transistor Tester.pdsprj, New Project [20250111, 08-00-50].pdsprj, VCCCS 4A [20250112, 07-43-47].pdsprj, VCCCS 4A [20250112, 08-42-53].pdsprj, VCCCS 4A.pdsprj]
