CharlieW112/Programmable-Electronic-Load/(notices)

Notices in the files:
STM32/TouchGFX_Projects/MyApplication/Core/Inc/main.h:
© Copyright (c) 2020 STMicroelectronics.
All rights reserved.
This software component is licensed by ST under Ultimate Liberty license
